Kevin-Pottier/SOCN/VHDL/PkgS51ItCtrl/CompPkgS51ItCtrl.vhdl

-- Library Declaration

Library IEEE;
  Use IEEE.std_logic_1164.all;
-- synopsys translate_off
  Use IEEE.vital_primitives.all;
  Use IEEE.vital_timing.all;

-- synopsys translate_on

-- Components Declaration

package PkgCompPkgS51ItCtrl is

End PkgCompPkgS51ItCtrl ;
