Kevin-Pottier/SOCN/TECH/AMS/vital/c35/c35_CORELIB_3B_Vcomponents.vhd

----------------------------------------------------------------
-- 
-- DATE CREATED :    Tue Aug  6 2006
-- 
-- LIBRARY      :    c35_CORELIB_3B
-- REVISION     :    2.1 bka
-- TECHNOLOGY   :    cmos
-- TIME SCALE   :    1 ps
-- LOGIC SYSTEM :    IEEE-1164
-- NOTES        :    
--                   Owner: austriamicrosystems AG  HIT-Kit: Digital
-- HISTORY      :
-- 
----------------------------------------------------------------

library IEEE;
use IEEE.STD_LOGIC_1164.all;
-- synopsys translate_off

library IEEE;
use IEEE.VITAL_Timing.all;
-- synopsys translate_on

package VCOMPONENTS is

constant DefaultTimingChecksOn : Boolean := True;
constant DefaultXon : Boolean := True;
constant DefaultMsgOn : Boolean := True;

----- Component ADD21 -----
component ADD21_3B
-- synopsys translate_off
   generic(
      TimingChecksOn: Boolean := DefaultTimingChecksOn;
      InstancePath: STRING := "*";
      Xon: Boolean := DefaultXon;
      MsgOn: Boolean := DefaultMsgOn;
      tpd_A_CO                       :	VitalDelayType01 := (1 ps, 1 ps);
      tpd_B_CO                       :	VitalDelayType01 := (1 ps, 1 ps);
      tpd_A_S                        :	VitalDelayType01 := (1 ps, 1 ps);
      tpd_B_S                        :	VitalDelayType01 := (1 ps, 1 ps);
      tipd_A                         :	VitalDelayType01 := (0 ps, 0 ps);
      tipd_B                         :	VitalDelayType01 := (0 ps, 0 ps));

-- synopsys translate_on
   port(
      A                              :	in    STD_ULOGIC;
      B                              :	in    STD_ULOGIC;
      CO                             :	out   STD_ULOGIC;
      S                              :	out   STD_ULOGIC);
end component;


----- Component ADD22 -----
component ADD22_3B
-- synopsys translate_off
   generic(
      TimingChecksOn: Boolean := DefaultTimingChecksOn;
      InstancePath: STRING := "*";
      Xon: Boolean := DefaultXon;
      MsgOn: Boolean := DefaultMsgOn;
      tpd_A_CO                       :	VitalDelayType01 := (1 ps, 1 ps);
      tpd_B_CO                       :	VitalDelayType01 := (1 ps, 1 ps);
      tpd_A_S                        :	VitalDelayType01 := (1 ps, 1 ps);
      tpd_B_S                        :	VitalDelayType01 := (1 ps, 1 ps);
      tipd_A                         :	VitalDelayType01 := (0 ps, 0 ps);
      tipd_B                         :	VitalDelayType01 := (0 ps, 0 ps));

-- synopsys translate_on
   port(
      A                              :	in    STD_ULOGIC;
      B                              :	in    STD_ULOGIC;
      CO                             :	out   STD_ULOGIC;
      S                              :	out   STD_ULOGIC);
end component;


----- Component ADD31 -----
component ADD31_3B
-- synopsys translate_off
   generic(
      TimingChecksOn: Boolean := DefaultTimingChecksOn;
      InstancePath: STRING := "*";
      Xon: Boolean := DefaultXon;
      MsgOn: Boolean := DefaultMsgOn;
      tpd_A_CO                       :	VitalDelayType01 := (1 ps, 1 ps);
      tpd_B_CO                       :	VitalDelayType01 := (1 ps, 1 ps);
      tpd_CI_CO                      :	VitalDelayType01 := (1 ps, 1 ps);
      tpd_A_S                        :	VitalDelayType01 := (1 ps, 1 ps);
      tpd_B_S                        :	VitalDelayType01 := (1 ps, 1 ps);
      tpd_CI_S                       :	VitalDelayType01 := (1 ps, 1 ps);
      tipd_A                         :	VitalDelayType01 := (0 ps, 0 ps);
      tipd_B                         :	VitalDelayType01 := (0 ps, 0 ps);
      tipd_CI                        :	VitalDelayType01 := (0 ps, 0 ps));

-- synopsys translate_on
   port(
      A                              :	in    STD_ULOGIC;
      B                              :	in    STD_ULOGIC;
      CI                             :	in    STD_ULOGIC;
      CO                             :	out   STD_ULOGIC;
      S                              :	out   STD_ULOGIC);
end component;


----- Component ADD32 -----
component ADD32_3B
-- synopsys translate_off
   generic(
      TimingChecksOn: Boolean := DefaultTimingChecksOn;
      InstancePath: STRING := "*";
      Xon: Boolean := DefaultXon;
      MsgOn: Boolean := DefaultMsgOn;
      tpd_A_CO                       :	VitalDelayType01 := (1 ps, 1 ps);
      tpd_B_CO                       :	VitalDelayType01 := (1 ps, 1 ps);
      tpd_CI_CO                      :	VitalDelayType01 := (1 ps, 1 ps);
      tpd_A_S                        :	VitalDelayType01 := (1 ps, 1 ps);
      tpd_B_S                        :	VitalDelayType01 := (1 ps, 1 ps);
      tpd_CI_S                       :	VitalDelayType01 := (1 ps, 1 ps);
      tipd_A                         :	VitalDelayType01 := (0 ps, 0 ps);
      tipd_B                         :	VitalDelayType01 := (0 ps, 0 ps);
      tipd_CI                        :	VitalDelayType01 := (0 ps, 0 ps));

-- synopsys translate_on
   port(
      A                              :	in    STD_ULOGIC;
      B                              :	in    STD_ULOGIC;
      CI                             :	in    STD_ULOGIC;
      CO                             :	out   STD_ULOGIC;
      S                              :	out   STD_ULOGIC);
end component;


----- Component AOI210 -----
component AOI210_3B
-- synopsys translate_off
   generic(
      TimingChecksOn: Boolean := DefaultTimingChecksOn;
      InstancePath: STRING := "*";
      Xon: Boolean := DefaultXon;
      MsgOn: Boolean := DefaultMsgOn;
      tpd_A_Q                        :	VitalDelayType01 := (1 ps, 1 ps);
      tpd_B_Q                        :	VitalDelayType01 := (1 ps, 1 ps);
      tpd_C_Q                        :	VitalDelayType01 := (1 ps, 1 ps);
      tipd_A                         :	VitalDelayType01 := (0 ps, 0 ps);
      tipd_B                         :	VitalDelayType01 := (0 ps, 0 ps);
      tipd_C                         :	VitalDelayType01 := (0 ps, 0 ps));

-- synopsys translate_on
   port(
      A                              :	in    STD_ULOGIC;
      B                              :	in    STD_ULOGIC;
      C                              :	in    STD_ULOGIC;
      Q                              :	out   STD_ULOGIC);
end component;


----- Component AOI211 -----
component AOI211_3B
-- synopsys translate_off
   generic(
      TimingChecksOn: Boolean := DefaultTimingChecksOn;
      InstancePath: STRING := "*";
      Xon: Boolean := DefaultXon;
      MsgOn: Boolean := DefaultMsgOn;
      tpd_A_Q                        :	VitalDelayType01 := (1 ps, 1 ps);
      tpd_B_Q                        :	VitalDelayType01 := (1 ps, 1 ps);
      tpd_C_Q                        :	VitalDelayType01 := (1 ps, 1 ps);
      tipd_A                         :	VitalDelayType01 := (0 ps, 0 ps);
      tipd_B                         :	VitalDelayType01 := (0 ps, 0 ps);
      tipd_C                         :	VitalDelayType01 := (0 ps, 0 ps));

-- synopsys translate_on
   port(
      A                              :	in    STD_ULOGIC;
      B                              :	in    STD_ULOGIC;
      C                              :	in    STD_ULOGIC;
      Q                              :	out   STD_ULOGIC);
end component;


----- Component AOI212 -----
component AOI212_3B
-- synopsys translate_off
   generic(
      TimingChecksOn: Boolean := DefaultTimingChecksOn;
      InstancePath: STRING := "*";
      Xon: Boolean := DefaultXon;
      MsgOn: Boolean := DefaultMsgOn;
      tpd_A_Q                        :	VitalDelayType01 := (1 ps, 1 ps);
      tpd_B_Q                        :	VitalDelayType01 := (1 ps, 1 ps);
      tpd_C_Q                        :	VitalDelayType01 := (1 ps, 1 ps);
      tipd_A                         :	VitalDelayType01 := (0 ps, 0 ps);
      tipd_B                         :	VitalDelayType01 := (0 ps, 0 ps);
      tipd_C                         :	VitalDelayType01 := (0 ps, 0 ps));

-- synopsys translate_on
   port(
      A                              :	in    STD_ULOGIC;
      B                              :	in    STD_ULOGIC;
      C                              :	in    STD_ULOGIC;
      Q                              :	out   STD_ULOGIC);
end component;


----- Component AOI220 -----
component AOI220_3B
-- synopsys translate_off
   generic(
      TimingChecksOn: Boolean := DefaultTimingChecksOn;
      InstancePath: STRING := "*";
      Xon: Boolean := DefaultXon;
      MsgOn: Boolean := DefaultMsgOn;
      tpd_A_Q                        :	VitalDelayType01 := (1 ps, 1 ps);
      tpd_B_Q                        :	VitalDelayType01 := (1 ps, 1 ps);
      tpd_C_Q                        :	VitalDelayType01 := (1 ps, 1 ps);
      tpd_D_Q                        :	VitalDelayType01 := (1 ps, 1 ps);
      tipd_A                         :	VitalDelayType01 := (0 ps, 0 ps);
      tipd_B                         :	VitalDelayType01 := (0 ps, 0 ps);
      tipd_C                         :	VitalDelayType01 := (0 ps, 0 ps);
      tipd_D                         :	VitalDelayType01 := (0 ps, 0 ps));

-- synopsys translate_on
   port(
      A                              :	in    STD_ULOGIC;
      B                              :	in    STD_ULOGIC;
      C                              :	in    STD_ULOGIC;
      D                              :	in    STD_ULOGIC;
      Q                              :	out   STD_ULOGIC);
end component;


----- Component AOI221 -----
component AOI221_3B
-- synopsys translate_off
   generic(
      TimingChecksOn: Boolean := DefaultTimingChecksOn;
      InstancePath: STRING := "*";
      Xon: Boolean := DefaultXon;
      MsgOn: Boolean := DefaultMsgOn;
      tpd_A_Q                        :	VitalDelayType01 := (1 ps, 1 ps);
      tpd_B_Q                        :	VitalDelayType01 := (1 ps, 1 ps);
      tpd_C_Q                        :	VitalDelayType01 := (1 ps, 1 ps);
      tpd_D_Q                        :	VitalDelayType01 := (1 ps, 1 ps);
      tipd_A                         :	VitalDelayType01 := (0 ps, 0 ps);
      tipd_B                         :	VitalDelayType01 := (0 ps, 0 ps);
      tipd_C                         :	VitalDelayType01 := (0 ps, 0 ps);
      tipd_D                         :	VitalDelayType01 := (0 ps, 0 ps));

-- synopsys translate_on
   port(
      A                              :	in    STD_ULOGIC;
      B                              :	in    STD_ULOGIC;
      C                              :	in    STD_ULOGIC;
      D                              :	in    STD_ULOGIC;
      Q                              :	out   STD_ULOGIC);
end component;


----- Component AOI222 -----
component AOI222_3B
-- synopsys translate_off
   generic(
      TimingChecksOn: Boolean := DefaultTimingChecksOn;
      InstancePath: STRING := "*";
      Xon: Boolean := DefaultXon;
      MsgOn: Boolean := DefaultMsgOn;
      tpd_A_Q                        :	VitalDelayType01 := (1 ps, 1 ps);
      tpd_B_Q                        :	VitalDelayType01 := (1 ps, 1 ps);
      tpd_C_Q                        :	VitalDelayType01 := (1 ps, 1 ps);
      tpd_D_Q                        :	VitalDelayType01 := (1 ps, 1 ps);
      tipd_A                         :	VitalDelayType01 := (0 ps, 0 ps);
      tipd_B                         :	VitalDelayType01 := (0 ps, 0 ps);
      tipd_C                         :	VitalDelayType01 := (0 ps, 0 ps);
      tipd_D                         :	VitalDelayType01 := (0 ps, 0 ps));

-- synopsys translate_on
   port(
      A                              :	in    STD_ULOGIC;
      B                              :	in    STD_ULOGIC;
      C                              :	in    STD_ULOGIC;
      D                              :	in    STD_ULOGIC;
      Q                              :	out   STD_ULOGIC);
end component;


----- Component AOI310 -----
component AOI310_3B
-- synopsys translate_off
   generic(
      TimingChecksOn: Boolean := DefaultTimingChecksOn;
      InstancePath: STRING := "*";
      Xon: Boolean := DefaultXon;
      MsgOn: Boolean := DefaultMsgOn;
      tpd_A_Q                        :	VitalDelayType01 := (1 ps, 1 ps);
      tpd_B_Q                        :	VitalDelayType01 := (1 ps, 1 ps);
      tpd_C_Q                        :	VitalDelayType01 := (1 ps, 1 ps);
      tpd_D_Q                        :	VitalDelayType01 := (1 ps, 1 ps);
      tipd_A                         :	VitalDelayType01 := (0 ps, 0 ps);
      tipd_B                         :	VitalDelayType01 := (0 ps, 0 ps);
      tipd_C                         :	VitalDelayType01 := (0 ps, 0 ps);
      tipd_D                         :	VitalDelayType01 := (0 ps, 0 ps));

-- synopsys translate_on
   port(
      A                              :	in    STD_ULOGIC;
      B                              :	in    STD_ULOGIC;
      C                              :	in    STD_ULOGIC;
      D                              :	in    STD_ULOGIC;
      Q                              :	out   STD_ULOGIC);
end component;


----- Component AOI311 -----
component AOI311_3B
-- synopsys translate_off
   generic(
      TimingChecksOn: Boolean := DefaultTimingChecksOn;
      InstancePath: STRING := "*";
      Xon: Boolean := DefaultXon;
      MsgOn: Boolean := DefaultMsgOn;
      tpd_A_Q                        :	VitalDelayType01 := (1 ps, 1 ps);
      tpd_B_Q                        :	VitalDelayType01 := (1 ps, 1 ps);
      tpd_C_Q                        :	VitalDelayType01 := (1 ps, 1 ps);
      tpd_D_Q                        :	VitalDelayType01 := (1 ps, 1 ps);
      tipd_A                         :	VitalDelayType01 := (0 ps, 0 ps);
      tipd_B                         :	VitalDelayType01 := (0 ps, 0 ps);
      tipd_C                         :	VitalDelayType01 := (0 ps, 0 ps);
      tipd_D                         :	VitalDelayType01 := (0 ps, 0 ps));

-- synopsys translate_on
   port(
      A                              :	in    STD_ULOGIC;
      B                              :	in    STD_ULOGIC;
      C                              :	in    STD_ULOGIC;
      D                              :	in    STD_ULOGIC;
      Q                              :	out   STD_ULOGIC);
end component;


----- Component AOI312 -----
component AOI312_3B
-- synopsys translate_off
   generic(
      TimingChecksOn: Boolean := DefaultTimingChecksOn;
      InstancePath: STRING := "*";
      Xon: Boolean := DefaultXon;
      MsgOn: Boolean := DefaultMsgOn;
      tpd_A_Q                        :	VitalDelayType01 := (1 ps, 1 ps);
      tpd_B_Q                        :	VitalDelayType01 := (1 ps, 1 ps);
      tpd_C_Q                        :	VitalDelayType01 := (1 ps, 1 ps);
      tpd_D_Q                        :	VitalDelayType01 := (1 ps, 1 ps);
      tipd_A                         :	VitalDelayType01 := (0 ps, 0 ps);
      tipd_B                         :	VitalDelayType01 := (0 ps, 0 ps);
      tipd_C                         :	VitalDelayType01 := (0 ps, 0 ps);
      tipd_D                         :	VitalDelayType01 := (0 ps, 0 ps));

-- synopsys translate_on
   port(
      A                              :	in    STD_ULOGIC;
      B                              :	in    STD_ULOGIC;
      C                              :	in    STD_ULOGIC;
      D                              :	in    STD_ULOGIC;
      Q                              :	out   STD_ULOGIC);
end component;


----- Component AOI2110 -----
component AOI2110_3B
-- synopsys translate_off
   generic(
      TimingChecksOn: Boolean := DefaultTimingChecksOn;
      InstancePath: STRING := "*";
      Xon: Boolean := DefaultXon;
      MsgOn: Boolean := DefaultMsgOn;
      tpd_A_Q                        :	VitalDelayType01 := (1 ps, 1 ps);
      tpd_B_Q                        :	VitalDelayType01 := (1 ps, 1 ps);
      tpd_C_Q                        :	VitalDelayType01 := (1 ps, 1 ps);
      tpd_D_Q                        :	VitalDelayType01 := (1 ps, 1 ps);
      tipd_A                         :	VitalDelayType01 := (0 ps, 0 ps);
      tipd_B                         :	VitalDelayType01 := (0 ps, 0 ps);
      tipd_C                         :	VitalDelayType01 := (0 ps, 0 ps);
      tipd_D                         :	VitalDelayType01 := (0 ps, 0 ps));

-- synopsys translate_on
   port(
      A                              :	in    STD_ULOGIC;
      B                              :	in    STD_ULOGIC;
      C                              :	in    STD_ULOGIC;
      D                              :	in    STD_ULOGIC;
      Q                              :	out   STD_ULOGIC);
end component;


----- Component AOI2111 -----
component AOI2111_3B
-- synopsys translate_off
   generic(
      TimingChecksOn: Boolean := DefaultTimingChecksOn;
      InstancePath: STRING := "*";
      Xon: Boolean := DefaultXon;
      MsgOn: Boolean := DefaultMsgOn;
      tpd_A_Q                        :	VitalDelayType01 := (1 ps, 1 ps);
      tpd_B_Q                        :	VitalDelayType01 := (1 ps, 1 ps);
      tpd_C_Q                        :	VitalDelayType01 := (1 ps, 1 ps);
      tpd_D_Q                        :	VitalDelayType01 := (1 ps, 1 ps);
      tipd_A                         :	VitalDelayType01 := (0 ps, 0 ps);
      tipd_B                         :	VitalDelayType01 := (0 ps, 0 ps);
      tipd_C                         :	VitalDelayType01 := (0 ps, 0 ps);
      tipd_D                         :	VitalDelayType01 := (0 ps, 0 ps));

-- synopsys translate_on
   port(
      A                              :	in    STD_ULOGIC;
      B                              :	in    STD_ULOGIC;
      C                              :	in    STD_ULOGIC;
      D                              :	in    STD_ULOGIC;
      Q                              :	out   STD_ULOGIC);
end component;


----- Component AOI2112 -----
component AOI2112_3B
-- synopsys translate_off
   generic(
      TimingChecksOn: Boolean := DefaultTimingChecksOn;
      InstancePath: STRING := "*";
      Xon: Boolean := DefaultXon;
      MsgOn: Boolean := DefaultMsgOn;
      tpd_A_Q                        :	VitalDelayType01 := (1 ps, 1 ps);
      tpd_B_Q                        :	VitalDelayType01 := (1 ps, 1 ps);
      tpd_C_Q                        :	VitalDelayType01 := (1 ps, 1 ps);
      tpd_D_Q                        :	VitalDelayType01 := (1 ps, 1 ps);
      tipd_A                         :	VitalDelayType01 := (0 ps, 0 ps);
      tipd_B                         :	VitalDelayType01 := (0 ps, 0 ps);
      tipd_C                         :	VitalDelayType01 := (0 ps, 0 ps);
      tipd_D                         :	VitalDelayType01 := (0 ps, 0 ps));

-- synopsys translate_on
   port(
      A                              :	in    STD_ULOGIC;
      B                              :	in    STD_ULOGIC;
      C                              :	in    STD_ULOGIC;
      D                              :	in    STD_ULOGIC;
      Q                              :	out   STD_ULOGIC);
end component;


----- Component BUF2 -----
component BUF2_3B
-- synopsys translate_off
   generic(
      TimingChecksOn: Boolean := DefaultTimingChecksOn;
      InstancePath: STRING := "*";
      Xon: Boolean := DefaultXon;
      MsgOn: Boolean := DefaultMsgOn;
      tpd_A_Q                        :	VitalDelayType01 := (1 ps, 1 ps);
      tipd_A                         :	VitalDelayType01 := (0 ps, 0 ps));

-- synopsys translate_on
   port(
      A                              :	in    STD_ULOGIC;
      Q                              :	out   STD_ULOGIC);
end component;


----- Component BUF4 -----
component BUF4_3B
-- synopsys translate_off
   generic(
      TimingChecksOn: Boolean := DefaultTimingChecksOn;
      InstancePath: STRING := "*";
      Xon: Boolean := DefaultXon;
      MsgOn: Boolean := DefaultMsgOn;
      tpd_A_Q                        :	VitalDelayType01 := (1 ps, 1 ps);
      tipd_A                         :	VitalDelayType01 := (0 ps, 0 ps));

-- synopsys translate_on
   port(
      A                              :	in    STD_ULOGIC;
      Q                              :	out   STD_ULOGIC);
end component;


----- Component BUF6 -----
component BUF6_3B
-- synopsys translate_off
   generic(
      TimingChecksOn: Boolean := DefaultTimingChecksOn;
      InstancePath: STRING := "*";
      Xon: Boolean := DefaultXon;
      MsgOn: Boolean := DefaultMsgOn;
      tpd_A_Q                        :	VitalDelayType01 := (1 ps, 1 ps);
      tipd_A                         :	VitalDelayType01 := (0 ps, 0 ps));

-- synopsys translate_on
   port(
      A                              :	in    STD_ULOGIC;
      Q                              :	out   STD_ULOGIC);
end component;


----- Component BUF8 -----
component BUF8_3B
-- synopsys translate_off
   generic(
      TimingChecksOn: Boolean := DefaultTimingChecksOn;
      InstancePath: STRING := "*";
      Xon: Boolean := DefaultXon;
      MsgOn: Boolean := DefaultMsgOn;
      tpd_A_Q                        :	VitalDelayType01 := (1 ps, 1 ps);
      tipd_A                         :	VitalDelayType01 := (0 ps, 0 ps));

-- synopsys translate_on
   port(
      A                              :	in    STD_ULOGIC;
      Q                              :	out   STD_ULOGIC);
end component;


----- Component BUF12 -----
component BUF12_3B
-- synopsys translate_off
   generic(
      TimingChecksOn: Boolean := DefaultTimingChecksOn;
      InstancePath: STRING := "*";
      Xon: Boolean := DefaultXon;
      MsgOn: Boolean := DefaultMsgOn;
      tpd_A_Q                        :	VitalDelayType01 := (1 ps, 1 ps);
      tipd_A                         :	VitalDelayType01 := (0 ps, 0 ps));

-- synopsys translate_on
   port(
      A                              :	in    STD_ULOGIC;
      Q                              :	out   STD_ULOGIC);
end component;


----- Component BUF15 -----
component BUF15_3B
-- synopsys translate_off
   generic(
      TimingChecksOn: Boolean := DefaultTimingChecksOn;
      InstancePath: STRING := "*";
      Xon: Boolean := DefaultXon;
      MsgOn: Boolean := DefaultMsgOn;
      tpd_A_Q                        :	VitalDelayType01 := (1 ps, 1 ps);
      tipd_A                         :	VitalDelayType01 := (0 ps, 0 ps));

-- synopsys translate_on
   port(
      A                              :	in    STD_ULOGIC;
      Q                              :	out   STD_ULOGIC);
end component;


----- Component BUFE2 -----
component BUFE2_3B
-- synopsys translate_off
   generic(
      TimingChecksOn: Boolean := DefaultTimingChecksOn;
      InstancePath: STRING := "*";
      Xon: Boolean := DefaultXon;
      MsgOn: Boolean := DefaultMsgOn;
      tpd_A_Q                        :	VitalDelayType01 := (1 ps, 1 ps);
      tpd_E_Q                        :	VitalDelayType01z := 
               (1 ps, 1 ps, 1 ps, 1 ps, 1 ps, 1 ps);
      tipd_A                         :	VitalDelayType01 := (0 ps, 0 ps);
      tipd_E                         :	VitalDelayType01 := (0 ps, 0 ps));

-- synopsys translate_on
   port(
      A                              :	in    STD_ULOGIC;
      E                              :	in    STD_ULOGIC;
      Q                              :	out   STD_ULOGIC);
end component;


----- Component BUFE4 -----
component BUFE4_3B
-- synopsys translate_off
   generic(
      TimingChecksOn: Boolean := DefaultTimingChecksOn;
      InstancePath: STRING := "*";
      Xon: Boolean := DefaultXon;
      MsgOn: Boolean := DefaultMsgOn;
      tpd_A_Q                        :	VitalDelayType01 := (1 ps, 1 ps);
      tpd_E_Q                        :	VitalDelayType01z := 
               (1 ps, 1 ps, 1 ps, 1 ps, 1 ps, 1 ps);
      tipd_A                         :	VitalDelayType01 := (0 ps, 0 ps);
      tipd_E                         :	VitalDelayType01 := (0 ps, 0 ps));

-- synopsys translate_on
   port(
      A                              :	in    STD_ULOGIC;
      E                              :	in    STD_ULOGIC;
      Q                              :	out   STD_ULOGIC);
end component;


----- Component BUFE6 -----
component BUFE6_3B
-- synopsys translate_off
   generic(
      TimingChecksOn: Boolean := DefaultTimingChecksOn;
      InstancePath: STRING := "*";
      Xon: Boolean := DefaultXon;
      MsgOn: Boolean := DefaultMsgOn;
      tpd_A_Q                        :	VitalDelayType01 := (1 ps, 1 ps);
      tpd_E_Q                        :	VitalDelayType01z := 
               (1 ps, 1 ps, 1 ps, 1 ps, 1 ps, 1 ps);
      tipd_A                         :	VitalDelayType01 := (0 ps, 0 ps);
      tipd_E                         :	VitalDelayType01 := (0 ps, 0 ps));

-- synopsys translate_on
   port(
      A                              :	in    STD_ULOGIC;
      E                              :	in    STD_ULOGIC;
      Q                              :	out   STD_ULOGIC);
end component;


----- Component BUFE8 -----
component BUFE8_3B
-- synopsys translate_off
   generic(
      TimingChecksOn: Boolean := DefaultTimingChecksOn;
      InstancePath: STRING := "*";
      Xon: Boolean := DefaultXon;
      MsgOn: Boolean := DefaultMsgOn;
      tpd_A_Q                        :	VitalDelayType01 := (1 ps, 1 ps);
      tpd_E_Q                        :	VitalDelayType01z := 
               (1 ps, 1 ps, 1 ps, 1 ps, 1 ps, 1 ps);
      tipd_A                         :	VitalDelayType01 := (0 ps, 0 ps);
      tipd_E                         :	VitalDelayType01 := (0 ps, 0 ps));

-- synopsys translate_on
   port(
      A                              :	in    STD_ULOGIC;
      E                              :	in    STD_ULOGIC;
      Q                              :	out   STD_ULOGIC);
end component;


----- Component BUFE12 -----
component BUFE12_3B
-- synopsys translate_off
   generic(
      TimingChecksOn: Boolean := DefaultTimingChecksOn;
      InstancePath: STRING := "*";
      Xon: Boolean := DefaultXon;
      MsgOn: Boolean := DefaultMsgOn;
      tpd_A_Q                        :	VitalDelayType01 := (1 ps, 1 ps);
      tpd_E_Q                        :	VitalDelayType01z := 
               (1 ps, 1 ps, 1 ps, 1 ps, 1 ps, 1 ps);
      tipd_A                         :	VitalDelayType01 := (0 ps, 0 ps);
      tipd_E                         :	VitalDelayType01 := (0 ps, 0 ps));

-- synopsys translate_on
   port(
      A                              :	in    STD_ULOGIC;
      E                              :	in    STD_ULOGIC;
      Q                              :	out   STD_ULOGIC);
end component;


----- Component BUFE15 -----
component BUFE15_3B
-- synopsys translate_off
   generic(
      TimingChecksOn: Boolean := DefaultTimingChecksOn;
      InstancePath: STRING := "*";
      Xon: Boolean := DefaultXon;
      MsgOn: Boolean := DefaultMsgOn;
      tpd_A_Q                        :	VitalDelayType01 := (1 ps, 1 ps);
      tpd_E_Q                        :	VitalDelayType01z := 
               (1 ps, 1 ps, 1 ps, 1 ps, 1 ps, 1 ps);
      tipd_A                         :	VitalDelayType01 := (0 ps, 0 ps);
      tipd_E                         :	VitalDelayType01 := (0 ps, 0 ps));

-- synopsys translate_on
   port(
      A                              :	in    STD_ULOGIC;
      E                              :	in    STD_ULOGIC;
      Q                              :	out   STD_ULOGIC);
end component;


----- Component BUSHD -----
component BUSHD_3B
-- synopsys translate_off
   generic(
      TimingChecksOn: Boolean := DefaultTimingChecksOn;
      InstancePath: STRING := "*";
      Xon: Boolean := DefaultXon;
      MsgOn: Boolean := DefaultMsgOn;
      tipd_A                         :	VitalDelayType01 := (0 ps, 0 ps));

-- synopsys translate_on
   port(
      A                              :	inout STD_ULOGIC := 'Z');
end component;


----- Component BUFT2 -----
component BUFT2_3B
-- synopsys translate_off
   generic(
      TimingChecksOn: Boolean := DefaultTimingChecksOn;
      InstancePath: STRING := "*";
      Xon: Boolean := DefaultXon;
      MsgOn: Boolean := DefaultMsgOn;
      tpd_A_Q                        :	VitalDelayType01 := (1 ps, 1 ps);
      tpd_EN_Q                       :	VitalDelayType01z := 
               (1 ps, 1 ps, 1 ps, 1 ps, 1 ps, 1 ps);
      tipd_A                         :	VitalDelayType01 := (0 ps, 0 ps);
      tipd_EN                        :	VitalDelayType01 := (0 ps, 0 ps));

-- synopsys translate_on
   port(
      A                              :	in    STD_ULOGIC;
      EN                             :	in    STD_ULOGIC;
      Q                              :	out   STD_ULOGIC);
end component;


----- Component BUFT4 -----
component BUFT4_3B
-- synopsys translate_off
   generic(
      TimingChecksOn: Boolean := DefaultTimingChecksOn;
      InstancePath: STRING := "*";
      Xon: Boolean := DefaultXon;
      MsgOn: Boolean := DefaultMsgOn;
      tpd_A_Q                        :	VitalDelayType01 := (1 ps, 1 ps);
      tpd_EN_Q                       :	VitalDelayType01z := 
               (1 ps, 1 ps, 1 ps, 1 ps, 1 ps, 1 ps);
      tipd_A                         :	VitalDelayType01 := (0 ps, 0 ps);
      tipd_EN                        :	VitalDelayType01 := (0 ps, 0 ps));

-- synopsys translate_on
   port(
      A                              :	in    STD_ULOGIC;
      EN                             :	in    STD_ULOGIC;
      Q                              :	out   STD_ULOGIC);
end component;


----- Component BUFT6 -----
component BUFT6_3B
-- synopsys translate_off
   generic(
      TimingChecksOn: Boolean := DefaultTimingChecksOn;
      InstancePath: STRING := "*";
      Xon: Boolean := DefaultXon;
      MsgOn: Boolean := DefaultMsgOn;
      tpd_A_Q                        :	VitalDelayType01 := (1 ps, 1 ps);
      tpd_EN_Q                       :	VitalDelayType01z := 
               (1 ps, 1 ps, 1 ps, 1 ps, 1 ps, 1 ps);
      tipd_A                         :	VitalDelayType01 := (0 ps, 0 ps);
      tipd_EN                        :	VitalDelayType01 := (0 ps, 0 ps));

-- synopsys translate_on
   port(
      A                              :	in    STD_ULOGIC;
      EN                             :	in    STD_ULOGIC;
      Q                              :	out   STD_ULOGIC);
end component;


----- Component BUFT8 -----
component BUFT8_3B
-- synopsys translate_off
   generic(
      TimingChecksOn: Boolean := DefaultTimingChecksOn;
      InstancePath: STRING := "*";
      Xon: Boolean := DefaultXon;
      MsgOn: Boolean := DefaultMsgOn;
      tpd_A_Q                        :	VitalDelayType01 := (1 ps, 1 ps);
      tpd_EN_Q                       :	VitalDelayType01z := 
               (1 ps, 1 ps, 1 ps, 1 ps, 1 ps, 1 ps);
      tipd_A                         :	VitalDelayType01 := (0 ps, 0 ps);
      tipd_EN                        :	VitalDelayType01 := (0 ps, 0 ps));

-- synopsys translate_on
   port(
      A                              :	in    STD_ULOGIC;
      EN                             :	in    STD_ULOGIC;
      Q                              :	out   STD_ULOGIC);
end component;


----- Component BUFT12 -----
component BUFT12_3B
-- synopsys translate_off
   generic(
      TimingChecksOn: Boolean := DefaultTimingChecksOn;
      InstancePath: STRING := "*";
      Xon: Boolean := DefaultXon;
      MsgOn: Boolean := DefaultMsgOn;
      tpd_A_Q                        :	VitalDelayType01 := (1 ps, 1 ps);
      tpd_EN_Q                       :	VitalDelayType01z := 
               (1 ps, 1 ps, 1 ps, 1 ps, 1 ps, 1 ps);
      tipd_A                         :	VitalDelayType01 := (0 ps, 0 ps);
      tipd_EN                        :	VitalDelayType01 := (0 ps, 0 ps));

-- synopsys translate_on
   port(
      A                              :	in    STD_ULOGIC;
      EN                             :	in    STD_ULOGIC;
      Q                              :	out   STD_ULOGIC);
end component;


----- Component BUFT15 -----
component BUFT15_3B
-- synopsys translate_off
   generic(
      TimingChecksOn: Boolean := DefaultTimingChecksOn;
      InstancePath: STRING := "*";
      Xon: Boolean := DefaultXon;
      MsgOn: Boolean := DefaultMsgOn;
      tpd_A_Q                        :	VitalDelayType01 := (1 ps, 1 ps);
      tpd_EN_Q                       :	VitalDelayType01z := 
               (1 ps, 1 ps, 1 ps, 1 ps, 1 ps, 1 ps);
      tipd_A                         :	VitalDelayType01 := (0 ps, 0 ps);
      tipd_EN                        :	VitalDelayType01 := (0 ps, 0 ps));

-- synopsys translate_on
   port(
      A                              :	in    STD_ULOGIC;
      EN                             :	in    STD_ULOGIC;
      Q                              :	out   STD_ULOGIC);
end component;


----- Component CLKBUF2 -----
component CLKBUF2_3B
-- synopsys translate_off
   generic(
      TimingChecksOn: Boolean := DefaultTimingChecksOn;
      InstancePath: STRING := "*";
      Xon: Boolean := DefaultXon;
      MsgOn: Boolean := DefaultMsgOn;
      tpd_A_Q                        :	VitalDelayType01 := (1 ps, 1 ps);
      tipd_A                         :	VitalDelayType01 := (0 ps, 0 ps));

-- synopsys translate_on
   port(
      A                              :	in    STD_ULOGIC;
      Q                              :	out   STD_ULOGIC);
end component;


----- Component CLKBUF4 -----
component CLKBUF4_3B
-- synopsys translate_off
   generic(
      TimingChecksOn: Boolean := DefaultTimingChecksOn;
      InstancePath: STRING := "*";
      Xon: Boolean := DefaultXon;
      MsgOn: Boolean := DefaultMsgOn;
      tpd_A_Q                        :	VitalDelayType01 := (1 ps, 1 ps);
      tipd_A                         :	VitalDelayType01 := (0 ps, 0 ps));

-- synopsys translate_on
   port(
      A                              :	in    STD_ULOGIC;
      Q                              :	out   STD_ULOGIC);
end component;


----- Component CLKBUF6 -----
component CLKBUF6_3B
-- synopsys translate_off
   generic(
      TimingChecksOn: Boolean := DefaultTimingChecksOn;
      InstancePath: STRING := "*";
      Xon: Boolean := DefaultXon;
      MsgOn: Boolean := DefaultMsgOn;
      tpd_A_Q                        :	VitalDelayType01 := (1 ps, 1 ps);
      tipd_A                         :	VitalDelayType01 := (0 ps, 0 ps));

-- synopsys translate_on
   port(
      A                              :	in    STD_ULOGIC;
      Q                              :	out   STD_ULOGIC);
end component;


----- Component CLKBUF8 -----
component CLKBUF8_3B
-- synopsys translate_off
   generic(
      TimingChecksOn: Boolean := DefaultTimingChecksOn;
      InstancePath: STRING := "*";
      Xon: Boolean := DefaultXon;
      MsgOn: Boolean := DefaultMsgOn;
      tpd_A_Q                        :	VitalDelayType01 := (1 ps, 1 ps);
      tipd_A                         :	VitalDelayType01 := (0 ps, 0 ps));

-- synopsys translate_on
   port(
      A                              :	in    STD_ULOGIC;
      Q                              :	out   STD_ULOGIC);
end component;


----- Component CLKBUF12 -----
component CLKBUF12_3B
-- synopsys translate_off
   generic(
      TimingChecksOn: Boolean := DefaultTimingChecksOn;
      InstancePath: STRING := "*";
      Xon: Boolean := DefaultXon;
      MsgOn: Boolean := DefaultMsgOn;
      tpd_A_Q                        :	VitalDelayType01 := (1 ps, 1 ps);
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
      tipd_A                         :	VitalDelayType01 := (0 ps, 0 ps));

-- synopsys translate_on
   port(
      A                              :	in    STD_ULOGIC;
      Q                              :	out   STD_ULOGIC);
end component;


----- Component DF1 -----
component DF1_3B
-- synopsys translate_off
   generic(
      TimingChecksOn: Boolean := DefaultTimingChecksOn;
      InstancePath: STRING := "*";
      Xon: Boolean := DefaultXon;
      MsgOn: Boolean := DefaultMsgOn;
      tpd_C_Q                        :	VitalDelayType01 := (1 ps, 1 ps);
      tpd_C_QN                       :	VitalDelayType01 := (1 ps, 1 ps);
      thold_D_C_posedge_posedge      :	VitalDelayType := 1 ps;
      thold_D_C_negedge_posedge      :	VitalDelayType := 1 ps;
      tsetup_D_C_posedge_posedge     :	VitalDelayType := -1 ps;
      tsetup_D_C_negedge_posedge     :	VitalDelayType := -1 ps;
      tpw_C_posedge                  :	VitalDelayType := 1 ps;
      tpw_C_negedge                  :	VitalDelayType := 1 ps;
      tipd_C                         :	VitalDelayType01 := (0 ps, 0 ps);
      tipd_D                         :	VitalDelayType01 := (0 ps, 0 ps));

-- synopsys translate_on
   port(
      C                              :	in    STD_ULOGIC;
      D                              :	in    STD_ULOGIC;
      Q                              :	out   STD_ULOGIC;
      QN                             :	out   STD_ULOGIC);
end component;


----- Component DF3 -----
component DF3_3B
-- synopsys translate_off
   generic(
      TimingChecksOn: Boolean := DefaultTimingChecksOn;
      InstancePath: STRING := "*";
      Xon: Boolean := DefaultXon;
      MsgOn: Boolean := DefaultMsgOn;
      tpd_C_Q                        :	VitalDelayType01 := (1 ps, 1 ps);
      tpd_C_QN                       :	VitalDelayType01 := (1 ps, 1 ps);
      thold_D_C_posedge_posedge      :	VitalDelayType := 1 ps;
      thold_D_C_negedge_posedge      :	VitalDelayType := 1 ps;
      tsetup_D_C_posedge_posedge     :	VitalDelayType := -1 ps;
      tsetup_D_C_negedge_posedge     :	VitalDelayType := -1 ps;
      tpw_C_posedge                  :	VitalDelayType := 1 ps;
      tpw_C_negedge                  :	VitalDelayType := 1 ps;
      tipd_C                         :	VitalDelayType01 := (0 ps, 0 ps);
      tipd_D                         :	VitalDelayType01 := (0 ps, 0 ps));

-- synopsys translate_on
   port(
      C                              :	in    STD_ULOGIC;
      D                              :	in    STD_ULOGIC;
      Q                              :	out   STD_ULOGIC;
      QN                             :	out   STD_ULOGIC);
end component;


----- Component DFC1 -----
component DFC1_3B
-- synopsys translate_off
   generic(
      TimingChecksOn: Boolean := DefaultTimingChecksOn;
      InstancePath: STRING := "*";
      Xon: Boolean := DefaultXon;
      MsgOn: Boolean := DefaultMsgOn;
      tpd_RN_Q                       :	VitalDelayType01 := (0 ps, 1 ps);
      tpd_C_Q                        :	VitalDelayType01 := (1 ps, 1 ps);
      tpd_RN_QN                      :	VitalDelayType01 := (1 ps, 0 ps);
      tpd_C_QN                       :	VitalDelayType01 := (1 ps, 1 ps);
      thold_D_C_posedge_posedge      :	VitalDelayType := 1 ps;
      thold_D_C_negedge_posedge      :	VitalDelayType := 1 ps;
      tsetup_D_C_posedge_posedge     :	VitalDelayType := -1 ps;
      tsetup_D_C_negedge_posedge     :	VitalDelayType := -1 ps;
      trecovery_RN_C_posedge_posedge :	VitalDelayType := 0 ps;
      thold_RN_C_posedge_posedge     :	VitalDelayType := 0 ps;
      tpw_C_posedge                  :	VitalDelayType := 1 ps;
      tpw_C_negedge                  :	VitalDelayType := 1 ps;
      tpw_RN_negedge                 :	VitalDelayType := 1 ps;
      tipd_C                         :	VitalDelayType01 := (0 ps, 0 ps);
      tipd_D                         :	VitalDelayType01 := (0 ps, 0 ps);
      tipd_RN                        :	VitalDelayType01 := (0 ps, 0 ps));

-- synopsys translate_on
   port(
      C                              :	in    STD_ULOGIC;
      D                              :	in    STD_ULOGIC;
      Q                              :	out   STD_ULOGIC;
      QN                             :	out   STD_ULOGIC;
      RN                             :	in    STD_ULOGIC);
end component;


----- Component DFC3 -----
component DFC3_3B
-- synopsys translate_off
   generic(
      TimingChecksOn: Boolean := DefaultTimingChecksOn;
      InstancePath: STRING := "*";
      Xon: Boolean := DefaultXon;
      MsgOn: Boolean := DefaultMsgOn;
      tpd_RN_Q                       :	VitalDelayType01 := (0 ps, 1 ps);
      tpd_C_Q                        :	VitalDelayType01 := (1 ps, 1 ps);
      tpd_RN_QN                      :	VitalDelayType01 := (1 ps, 0 ps);
      tpd_C_QN                       :	VitalDelayType01 := (1 ps, 1 ps);
      thold_D_C_posedge_posedge      :	VitalDelayType := 1 ps;
      thold_D_C_negedge_posedge      :	VitalDelayType := 1 ps;
      tsetup_D_C_posedge_posedge     :	VitalDelayType := -1 ps;
      tsetup_D_C_negedge_posedge     :	VitalDelayType := -1 ps;
      trecovery_RN_C_posedge_posedge :	VitalDelayType := 0 ps;
      thold_RN_C_posedge_posedge     :	VitalDelayType := 0 ps;
      tpw_C_posedge                  :	VitalDelayType := 1 ps;
      tpw_C_negedge                  :	VitalDelayType := 1 ps;
      tpw_RN_negedge                 :	VitalDelayType := 1 ps;
      tipd_C                         :	VitalDelayType01 := (0 ps, 0 ps);
      tipd_D                         :	VitalDelayType01 := (0 ps, 0 ps);
      tipd_RN                        :	VitalDelayType01 := (0 ps, 0 ps));

-- synopsys translate_on
   port(
      C                              :	in    STD_ULOGIC;
      D                              :	in    STD_ULOGIC;
      Q                              :	out   STD_ULOGIC;
      QN                             :	out   STD_ULOGIC;
      RN                             :	in    STD_ULOGIC);
end component;


----- Component DFCP1 -----
component DFCP1_3B
-- synopsys translate_off
   generic(
      TimingChecksOn: Boolean := DefaultTimingChecksOn;
      InstancePath: STRING := "*";
      Xon: Boolean := DefaultXon;
      MsgOn: Boolean := DefaultMsgOn;
      tpd_RN_Q                       :	VitalDelayType01 := (1 ps, 1 ps);
      tpd_SN_Q                       :	VitalDelayType01 := (1 ps, 0 ps);
      tpd_C_Q                        :	VitalDelayType01 := (1 ps, 1 ps);
      tpd_RN_QN                      :	VitalDelayType01 := (1 ps, 0 ps);
      tpd_SN_QN                      :	VitalDelayType01 := (1 ps, 1 ps);
      tpd_C_QN                       :	VitalDelayType01 := (1 ps, 1 ps);
      thold_D_C_posedge_posedge      :	VitalDelayType := 1 ps;
      thold_D_C_negedge_posedge      :	VitalDelayType := 1 ps;
      tsetup_D_C_posedge_posedge     :	VitalDelayType := -1 ps;
      tsetup_D_C_negedge_posedge     :	VitalDelayType := -1 ps;
      trecovery_RN_C_posedge_posedge :	VitalDelayType := 0 ps;
      trecovery_SN_C_posedge_posedge :	VitalDelayType := 0 ps;
      thold_SN_C_posedge_posedge     :	VitalDelayType := 0 ps;
      thold_RN_C_posedge_posedge     :	VitalDelayType := 0 ps;
      tpw_C_posedge                  :	VitalDelayType := 1 ps;
      tpw_C_negedge                  :	VitalDelayType := 1 ps;
      tpw_RN_negedge                 :	VitalDelayType := 1 ps;
      tpw_SN_negedge                 :	VitalDelayType := 1 ps;
      tipd_C                         :	VitalDelayType01 := (0 ps, 0 ps);
      tipd_D                         :	VitalDelayType01 := (0 ps, 0 ps);
      tipd_RN                        :	VitalDelayType01 := (0 ps, 0 ps);
      tipd_SN                        :	VitalDelayType01 := (0 ps, 0 ps));

-- synopsys translate_on
   port(
      C                              :	in    STD_ULOGIC;
      D                              :	in    STD_ULOGIC;
      Q                              :	out   STD_ULOGIC;
      QN                             :	out   STD_ULOGIC;
      RN                             :	in    STD_ULOGIC;
      SN                             :	in    STD_ULOGIC);
end component;


----- Component DFCP3 -----
component DFCP3_3B
-- synopsys translate_off
   generic(
      TimingChecksOn: Boolean := DefaultTimingChecksOn;
      InstancePath: STRING := "*";
      Xon: Boolean := DefaultXon;
      MsgOn: Boolean := DefaultMsgOn;
      tpd_RN_Q                       :	VitalDelayType01 := (1 ps, 1 ps);
      tpd_SN_Q                       :	VitalDelayType01 := (1 ps, 0 ps);
      tpd_C_Q                        :	VitalDelayType01 := (1 ps, 1 ps);
      tpd_RN_QN                      :	VitalDelayType01 := (1 ps, 0 ps);
      tpd_SN_QN                      :	VitalDelayType01 := (1 ps, 1 ps);
      tpd_C_QN                       :	VitalDelayType01 := (1 ps, 1 ps);
      thold_D_C_posedge_posedge      :	VitalDelayType := 1 ps;
      thold_D_C_negedge_posedge      :	VitalDelayType := 1 ps;
      tsetup_D_C_posedge_posedge     :	VitalDelayType := 1 ps;
      tsetup_D_C_negedge_posedge     :	VitalDelayType := -1 ps;
      trecovery_RN_C_posedge_posedge :	VitalDelayType := 0 ps;
      trecovery_SN_C_posedge_posedge :	VitalDelayType := 0 ps;
      thold_SN_C_posedge_posedge     :	VitalDelayType := 0 ps;
      thold_RN_C_posedge_posedge     :	VitalDelayType := 0 ps;
      tpw_C_posedge                  :	VitalDelayType := 1 ps;
      tpw_C_negedge                  :	VitalDelayType := 1 ps;
      tpw_RN_negedge                 :	VitalDelayType := 1 ps;
      tpw_SN_negedge                 :	VitalDelayType := 1 ps;
      tipd_C                         :	VitalDelayType01 := (0 ps, 0 ps);
      tipd_D                         :	VitalDelayType01 := (0 ps, 0 ps);
      tipd_RN                        :	VitalDelayType01 := (0 ps, 0 ps);
      tipd_SN                        :	VitalDelayType01 := (0 ps, 0 ps));

-- synopsys translate_on
   port(
      C                              :	in    STD_ULOGIC;
      D                              :	in    STD_ULOGIC;
      Q                              :	out   STD_ULOGIC;
      QN                             :	out   STD_ULOGIC;
      RN                             :	in    STD_ULOGIC;
      SN                             :	in    STD_ULOGIC);
end component;


----- Component DFE1 -----
component DFE1_3B
-- synopsys translate_off
   generic(
      TimingChecksOn: Boolean := DefaultTimingChecksOn;
      InstancePath: STRING := "*";
      Xon: Boolean := DefaultXon;
      MsgOn: Boolean := DefaultMsgOn;
      tpd_C_Q                        :	VitalDelayType01 := (1 ps, 1 ps);
      tpd_C_QN                       :	VitalDelayType01 := (1 ps, 1 ps);
      thold_D_C_posedge_posedge      :	VitalDelayType := -1 ps;
      thold_D_C_negedge_posedge      :	VitalDelayType := 1 ps;
      tsetup_D_C_posedge_posedge     :	VitalDelayType := 1 ps;
      tsetup_D_C_negedge_posedge     :	VitalDelayType := 1 ps;
      thold_E_C_posedge_posedge      :	VitalDelayType := -1 ps;
      thold_E_C_negedge_posedge      :	VitalDelayType := 0 ps;
      tsetup_E_C_posedge_posedge     :	VitalDelayType := 1 ps;
      tsetup_E_C_negedge_posedge     :	VitalDelayType := 1 ps;
      tpw_C_posedge                  :	VitalDelayType := 1 ps;
      tpw_C_negedge                  :	VitalDelayType := 1 ps;
      tipd_C                         :	VitalDelayType01 := (0 ps, 0 ps);
      tipd_D                         :	VitalDelayType01 := (0 ps, 0 ps);
      tipd_E                         :	VitalDelayType01 := (0 ps, 0 ps));

-- synopsys translate_on
   port(
      C                              :	in    STD_ULOGIC;
      D                              :	in    STD_ULOGIC;
      E                              :	in    STD_ULOGIC;
      Q                              :	out   STD_ULOGIC;
      QN                             :	out   STD_ULOGIC);
end component;


----- Component DFE3 -----
component DFE3_3B
-- synopsys translate_off
   generic(
      TimingChecksOn: Boolean := DefaultTimingChecksOn;
      InstancePath: STRING := "*";
      Xon: Boolean := DefaultXon;
      MsgOn: Boolean := DefaultMsgOn;
      tpd_C_Q                        :	VitalDelayType01 := (1 ps, 1 ps);
      tpd_C_QN                       :	VitalDelayType01 := (1 ps, 1 ps);
      thold_D_C_posedge_posedge      :	VitalDelayType := -1 ps;
      thold_D_C_negedge_posedge      :	VitalDelayType := -1 ps;
      tsetup_D_C_posedge_posedge     :	VitalDelayType := 1 ps;
      tsetup_D_C_negedge_posedge     :	VitalDelayType := 1 ps;
      thold_E_C_posedge_posedge      :	VitalDelayType := -1 ps;
      thold_E_C_negedge_posedge      :	VitalDelayType := 0 ps;
      tsetup_E_C_posedge_posedge     :	VitalDelayType := 1 ps;
      tsetup_E_C_negedge_posedge     :	VitalDelayType := 1 ps;
      tpw_C_posedge                  :	VitalDelayType := 1 ps;
      tpw_C_negedge                  :	VitalDelayType := 1 ps;
      tipd_C                         :	VitalDelayType01 := (0 ps, 0 ps);
      tipd_D                         :	VitalDelayType01 := (0 ps, 0 ps);
      tipd_E                         :	VitalDelayType01 := (0 ps, 0 ps));

-- synopsys translate_on
   port(
      C                              :	in    STD_ULOGIC;
      D                              :	in    STD_ULOGIC;
      E                              :	in    STD_ULOGIC;
      Q                              :	out   STD_ULOGIC;
      QN                             :	out   STD_ULOGIC);
end component;


----- Component DFEC1 -----
component DFEC1_3B
-- synopsys translate_off
   generic(
      TimingChecksOn: Boolean := DefaultTimingChecksOn;
      InstancePath: STRING := "*";
      Xon: Boolean := DefaultXon;
      MsgOn: Boolean := DefaultMsgOn;
      tpd_RN_Q                       :	VitalDelayType01 := (0 ps, 1 ps);
      tpd_C_Q                        :	VitalDelayType01 := (1 ps, 1 ps);
      tpd_RN_QN                      :	VitalDelayType01 := (1 ps, 0 ps);
      tpd_C_QN                       :	VitalDelayType01 := (1 ps, 1 ps);
      thold_D_C_posedge_posedge      :	VitalDelayType := 0 ps;
      thold_D_C_negedge_posedge      :	VitalDelayType := -1 ps;
      tsetup_D_C_posedge_posedge     :	VitalDelayType := 1 ps;
      tsetup_D_C_negedge_posedge     :	VitalDelayType := 1 ps;
      thold_E_C_posedge_posedge      :	VitalDelayType := 0 ps;
      thold_E_C_negedge_posedge      :	VitalDelayType := 1 ps;
      tsetup_E_C_posedge_posedge     :	VitalDelayType := 1 ps;
      tsetup_E_C_negedge_posedge     :	VitalDelayType := 1 ps;
      trecovery_RN_C_posedge_posedge :	VitalDelayType := 0 ps;
      thold_RN_C_posedge_posedge     :	VitalDelayType := 0 ps;
      tpw_C_posedge                  :	VitalDelayType := 1 ps;
      tpw_C_negedge                  :	VitalDelayType := 1 ps;
      tpw_RN_negedge                 :	VitalDelayType := 1 ps;
      tipd_C                         :	VitalDelayType01 := (0 ps, 0 ps);
      tipd_D                         :	VitalDelayType01 := (0 ps, 0 ps);
      tipd_E                         :	VitalDelayType01 := (0 ps, 0 ps);
      tipd_RN                        :	VitalDelayType01 := (0 ps, 0 ps));

-- synopsys translate_on
   port(
      C                              :	in    STD_ULOGIC;
      D                              :	in    STD_ULOGIC;
      E                              :	in    STD_ULOGIC;
      Q                              :	out   STD_ULOGIC;
      QN                             :	out   STD_ULOGIC;
      RN                             :	in    STD_ULOGIC);
end component;


----- Component DFEC3 -----
component DFEC3_3B
-- synopsys translate_off
   generic(
      TimingChecksOn: Boolean := DefaultTimingChecksOn;
      InstancePath: STRING := "*";
      Xon: Boolean := DefaultXon;
      MsgOn: Boolean := DefaultMsgOn;
      tpd_RN_Q                       :	VitalDelayType01 := (0 ps, 1 ps);
      tpd_C_Q                        :	VitalDelayType01 := (1 ps, 1 ps);
      tpd_RN_QN                      :	VitalDelayType01 := (1 ps, 0 ps);
      tpd_C_QN                       :	VitalDelayType01 := (1 ps, 1 ps);
      thold_D_C_posedge_posedge      :	VitalDelayType := -1 ps;
      thold_D_C_negedge_posedge      :	VitalDelayType := -1 ps;
      tsetup_D_C_posedge_posedge     :	VitalDelayType := 1 ps;
      tsetup_D_C_negedge_posedge     :	VitalDelayType := 1 ps;
      thold_E_C_posedge_posedge      :	VitalDelayType := -1 ps;
      thold_E_C_negedge_posedge      :	VitalDelayType := 0 ps;
      tsetup_E_C_posedge_posedge     :	VitalDelayType := 1 ps;
      tsetup_E_C_negedge_posedge     :	VitalDelayType := 1 ps;
      trecovery_RN_C_posedge_posedge :	VitalDelayType := 0 ps;
      thold_RN_C_posedge_posedge     :	VitalDelayType := 0 ps;
      tpw_C_posedge                  :	VitalDelayType := 1 ps;
      tpw_C_negedge                  :	VitalDelayType := 1 ps;
      tpw_RN_negedge                 :	VitalDelayType := 1 ps;
      tipd_C                         :	VitalDelayType01 := (0 ps, 0 ps);
      tipd_D                         :	VitalDelayType01 := (0 ps, 0 ps);
      tipd_E                         :	VitalDelayType01 := (0 ps, 0 ps);
      tipd_RN                        :	VitalDelayType01 := (0 ps, 0 ps));

-- synopsys translate_on
   port(
      C                              :	in    STD_ULOGIC;
      D                              :	in    STD_ULOGIC;
      E                              :	in    STD_ULOGIC;
      Q                              :	out   STD_ULOGIC;
      QN                             :	out   STD_ULOGIC;
      RN                             :	in    STD_ULOGIC);
end component;


----- Component DFECP1 -----
component DFECP1_3B
-- synopsys translate_off
   generic(
      TimingChecksOn: Boolean := DefaultTimingChecksOn;
      InstancePath: STRING := "*";
      Xon: Boolean := DefaultXon;
      MsgOn: Boolean := DefaultMsgOn;
      tpd_SN_Q                       :	VitalDelayType01 := (1 ps, 0 ps);
      tpd_RN_Q                       :	VitalDelayType01 := (1 ps, 1 ps);
      tpd_C_Q                        :	VitalDelayType01 := (1 ps, 1 ps);
      tpd_SN_QN                      :	VitalDelayType01 := (1 ps, 1 ps);
      tpd_RN_QN                      :	VitalDelayType01 := (1 ps, 0 ps);
      tpd_C_QN                       :	VitalDelayType01 := (1 ps, 1 ps);
      thold_D_C_posedge_posedge      :	VitalDelayType := -1 ps;
      thold_D_C_negedge_posedge      :	VitalDelayType := 1 ps;
      tsetup_D_C_posedge_posedge     :	VitalDelayType := 1 ps;
      tsetup_D_C_negedge_posedge     :	VitalDelayType := 1 ps;
      thold_E_C_posedge_posedge      :	VitalDelayType := 0 ps;
      thold_E_C_negedge_posedge      :	VitalDelayType := 1 ps;
      tsetup_E_C_posedge_posedge     :	VitalDelayType := 1 ps;
      tsetup_E_C_negedge_posedge     :	VitalDelayType := 1 ps;
      trecovery_RN_C_posedge_posedge :	VitalDelayType := 0 ps;
      trecovery_SN_C_posedge_posedge :	VitalDelayType := 0 ps;
      thold_SN_C_posedge_posedge     :	VitalDelayType := 0 ps;
      thold_RN_C_posedge_posedge     :	VitalDelayType := 0 ps;
      tpw_C_posedge                  :	VitalDelayType := 1 ps;
      tpw_C_negedge                  :	VitalDelayType := 1 ps;
      tpw_RN_negedge                 :	VitalDelayType := 1 ps;
      tpw_SN_negedge                 :	VitalDelayType := 1 ps;
      tipd_C                         :	VitalDelayType01 := (0 ps, 0 ps);
      tipd_D                         :	VitalDelayType01 := (0 ps, 0 ps);
      tipd_E                         :	VitalDelayType01 := (0 ps, 0 ps);
      tipd_RN                        :	VitalDelayType01 := (0 ps, 0 ps);
      tipd_SN                        :	VitalDelayType01 := (0 ps, 0 ps));

-- synopsys translate_on
   port(
      C                              :	in    STD_ULOGIC;
      D                              :	in    STD_ULOGIC;
      E                              :	in    STD_ULOGIC;
      Q                              :	out   STD_ULOGIC;
      QN                             :	out   STD_ULOGIC;
      RN                             :	in    STD_ULOGIC;
      SN                             :	in    STD_ULOGIC);
end component;


----- Component DFECP3 -----
component DFECP3_3B
-- synopsys translate_off
   generic(
      TimingChecksOn: Boolean := DefaultTimingChecksOn;
      InstancePath: STRING := "*";
      Xon: Boolean := DefaultXon;
      MsgOn: Boolean := DefaultMsgOn;
      tpd_SN_Q                       :	VitalDelayType01 := (1 ps, 0 ps);
      tpd_RN_Q                       :	VitalDelayType01 := (1 ps, 1 ps);
      tpd_C_Q                        :	VitalDelayType01 := (1 ps, 1 ps);
      tpd_SN_QN                      :	VitalDelayType01 := (1 ps, 1 ps);
      tpd_RN_QN                      :	VitalDelayType01 := (1 ps, 0 ps);
      tpd_C_QN                       :	VitalDelayType01 := (1 ps, 1 ps);
      thold_D_C_posedge_posedge      :	VitalDelayType := -1 ps;
      thold_D_C_negedge_posedge      :	VitalDelayType := -1 ps;
      tsetup_D_C_posedge_posedge     :	VitalDelayType := 1 ps;
      tsetup_D_C_negedge_posedge     :	VitalDelayType := 1 ps;
      thold_E_C_posedge_posedge      :	VitalDelayType := 0 ps;
      thold_E_C_negedge_posedge      :	VitalDelayType := 1 ps;
      tsetup_E_C_posedge_posedge     :	VitalDelayType := 1 ps;
      tsetup_E_C_negedge_posedge     :	VitalDelayType := 1 ps;
      trecovery_RN_C_posedge_posedge :	VitalDelayType := 0 ps;
      trecovery_SN_C_posedge_posedge :	VitalDelayType := 0 ps;
      thold_SN_C_posedge_posedge     :	VitalDelayType := 0 ps;
      thold_RN_C_posedge_posedge     :	VitalDelayType := 0 ps;
      tpw_C_posedge                  :	VitalDelayType := 1 ps;
      tpw_C_negedge                  :	VitalDelayType := 1 ps;
      tpw_RN_negedge                 :	VitalDelayType := 1 ps;
      tpw_SN_negedge                 :	VitalDelayType := 1 ps;
      tipd_C                         :	VitalDelayType01 := (0 ps, 0 ps);
      tipd_D                         :	VitalDelayType01 := (0 ps, 0 ps);
      tipd_E                         :	VitalDelayType01 := (0 ps, 0 ps);
      tipd_RN                        :	VitalDelayType01 := (0 ps, 0 ps);
      tipd_SN                        :	VitalDelayType01 := (0 ps, 0 ps));

-- synopsys translate_on
   port(
      C                              :	in    STD_ULOGIC;
      D                              :	in    STD_ULOGIC;
      E                              :	in    STD_ULOGIC;
      Q                              :	out   STD_ULOGIC;
      QN                             :	out   STD_ULOGIC;
      RN                             :	in    STD_ULOGIC;
      SN                             :	in    STD_ULOGIC);
end component;


----- Component DFEP1 -----
component DFEP1_3B
-- synopsys translate_off
   generic(
      TimingChecksOn: Boolean := DefaultTimingChecksOn;
      InstancePath: STRING := "*";
      Xon: Boolean := DefaultXon;
      MsgOn: Boolean := DefaultMsgOn;
      tpd_SN_Q                       :	VitalDelayType01 := (1 ps, 0 ps);
      tpd_C_Q                        :	VitalDelayType01 := (1 ps, 1 ps);
      tpd_SN_QN                      :	VitalDelayType01 := (0 ps, 1 ps);
      tpd_C_QN                       :	VitalDelayType01 := (1 ps, 1 ps);
      thold_D_C_posedge_posedge      :	VitalDelayType := -1 ps;
      thold_D_C_negedge_posedge      :	VitalDelayType := -1 ps;
      tsetup_D_C_posedge_posedge     :	VitalDelayType := 1 ps;
      tsetup_D_C_negedge_posedge     :	VitalDelayType := 1 ps;
      thold_E_C_posedge_posedge      :	VitalDelayType := 0 ps;
      thold_E_C_negedge_posedge      :	VitalDelayType := 1 ps;
      tsetup_E_C_posedge_posedge     :	VitalDelayType := 1 ps;
      tsetup_E_C_negedge_posedge     :	VitalDelayType := 1 ps;
      trecovery_SN_C_posedge_posedge :	VitalDelayType := 0 ps;
      thold_SN_C_posedge_posedge     :	VitalDelayType := 0 ps;
      tpw_C_posedge                  :	VitalDelayType := 1 ps;
      tpw_C_negedge                  :	VitalDelayType := 1 ps;
      tpw_SN_negedge                 :	VitalDelayType := 1 ps;
      tipd_C                         :	VitalDelayType01 := (0 ps, 0 ps);
      tipd_D                         :	VitalDelayType01 := (0 ps, 0 ps);
      tipd_E                         :	VitalDelayType01 := (0 ps, 0 ps);
      tipd_SN                        :	VitalDelayType01 := (0 ps, 0 ps));

-- synopsys translate_on
   port(
      C                              :	in    STD_ULOGIC;
      D                              :	in    STD_ULOGIC;
      E                              :	in    STD_ULOGIC;
      Q                              :	out   STD_ULOGIC;
      QN                             :	out   STD_ULOGIC;
      SN                             :	in    STD_ULOGIC);
end component;


----- Component DFEP3 -----
component DFEP3_3B
-- synopsys translate_off
   generic(
      TimingChecksOn: Boolean := DefaultTimingChecksOn;
      InstancePath: STRING := "*";
      Xon: Boolean := DefaultXon;
      MsgOn: Boolean := DefaultMsgOn;
      tpd_SN_Q                       :	VitalDelayType01 := (1 ps, 0 ps);
      tpd_C_Q                        :	VitalDelayType01 := (1 ps, 1 ps);
      tpd_SN_QN                      :	VitalDelayType01 := (0 ps, 1 ps);
      tpd_C_QN                       :	VitalDelayType01 := (1 ps, 1 ps);
      thold_D_C_posedge_posedge      :	VitalDelayType := 1 ps;
      thold_D_C_negedge_posedge      :	VitalDelayType := -1 ps;
      tsetup_D_C_posedge_posedge     :	VitalDelayType := 1 ps;
      tsetup_D_C_negedge_posedge     :	VitalDelayType := 1 ps;
      thold_E_C_posedge_posedge      :	VitalDelayType := 0 ps;
      thold_E_C_negedge_posedge      :	VitalDelayType := 1 ps;
      tsetup_E_C_posedge_posedge     :	VitalDelayType := 1 ps;
      tsetup_E_C_negedge_posedge     :	VitalDelayType := 1 ps;
      trecovery_SN_C_posedge_posedge :	VitalDelayType := 0 ps;
      thold_SN_C_posedge_posedge     :	VitalDelayType := 0 ps;
      tpw_C_posedge                  :	VitalDelayType := 1 ps;
      tpw_C_negedge                  :	VitalDelayType := 1 ps;
      tpw_SN_negedge                 :	VitalDelayType := 1 ps;
      tipd_C                         :	VitalDelayType01 := (0 ps, 0 ps);
      tipd_D                         :	VitalDelayType01 := (0 ps, 0 ps);
      tipd_E                         :	VitalDelayType01 := (0 ps, 0 ps);
      tipd_SN                        :	VitalDelayType01 := (0 ps, 0 ps));

-- synopsys translate_on
   port(
      C                              :	in    STD_ULOGIC;
      D                              :	in    STD_ULOGIC;
      E                              :	in    STD_ULOGIC;
      Q                              :	out   STD_ULOGIC;
      QN                             :	out   STD_ULOGIC;
      SN                             :	in    STD_ULOGIC);
end component;


----- Component DFP1 -----
component DFP1_3B
-- synopsys translate_off
   generic(
      TimingChecksOn: Boolean := DefaultTimingChecksOn;
      InstancePath: STRING := "*";
      Xon: Boolean := DefaultXon;
      MsgOn: Boolean := DefaultMsgOn;
      tpd_SN_Q                       :	VitalDelayType01 := (1 ps, 0 ps);
      tpd_C_Q                        :	VitalDelayType01 := (1 ps, 1 ps);
      tpd_SN_QN                      :	VitalDelayType01 := (0 ps, 1 ps);
      tpd_C_QN                       :	VitalDelayType01 := (1 ps, 1 ps);
      thold_D_C_posedge_posedge      :	VitalDelayType := 1 ps;
      thold_D_C_negedge_posedge      :	VitalDelayType := 0 ps;
      tsetup_D_C_posedge_posedge     :	VitalDelayType := 1 ps;
      tsetup_D_C_negedge_posedge     :	VitalDelayType := -1 ps;
      trecovery_SN_C_posedge_posedge :	VitalDelayType := 0 ps;
      thold_SN_C_posedge_posedge     :	VitalDelayType := 0 ps;
      tpw_C_posedge                  :	VitalDelayType := 1 ps;
      tpw_C_negedge                  :	VitalDelayType := 1 ps;
      tpw_SN_negedge                 :	VitalDelayType := 1 ps;
      tipd_C                         :	VitalDelayType01 := (0 ps, 0 ps);
      tipd_D                         :	VitalDelayType01 := (0 ps, 0 ps);
      tipd_SN                        :	VitalDelayType01 := (0 ps, 0 ps));

-- synopsys translate_on
   port(
      C                              :	in    STD_ULOGIC;
      D                              :	in    STD_ULOGIC;
      Q                              :	out   STD_ULOGIC;
      QN                             :	out   STD_ULOGIC;
      SN                             :	in    STD_ULOGIC);
end component;


----- Component DFP3 -----
component DFP3_3B
-- synopsys translate_off
   generic(
      TimingChecksOn: Boolean := DefaultTimingChecksOn;
      InstancePath: STRING := "*";
      Xon: Boolean := DefaultXon;
      MsgOn: Boolean := DefaultMsgOn;
      tpd_SN_Q                       :	VitalDelayType01 := (1 ps, 0 ps);
      tpd_C_Q                        :	VitalDelayType01 := (1 ps, 1 ps);
      tpd_SN_QN                      :	VitalDelayType01 := (0 ps, 1 ps);
      tpd_C_QN                       :	VitalDelayType01 := (1 ps, 1 ps);
      thold_D_C_posedge_posedge      :	VitalDelayType := -1 ps;
      thold_D_C_negedge_posedge      :	VitalDelayType := 0 ps;
      tsetup_D_C_posedge_posedge     :	VitalDelayType := 1 ps;
      tsetup_D_C_negedge_posedge     :	VitalDelayType := -1 ps;
      trecovery_SN_C_posedge_posedge :	VitalDelayType := 0 ps;
      thold_SN_C_posedge_posedge     :	VitalDelayType := 0 ps;
      tpw_C_posedge                  :	VitalDelayType := 1 ps;
      tpw_C_negedge                  :	VitalDelayType := 1 ps;
      tpw_SN_negedge                 :	VitalDelayType := 1 ps;
      tipd_C                         :	VitalDelayType01 := (0 ps, 0 ps);
      tipd_D                         :	VitalDelayType01 := (0 ps, 0 ps);
      tipd_SN                        :	VitalDelayType01 := (0 ps, 0 ps));

-- synopsys translate_on
   port(
      C                              :	in    STD_ULOGIC;
      D                              :	in    STD_ULOGIC;
      Q                              :	out   STD_ULOGIC;
      QN                             :	out   STD_ULOGIC;
      SN                             :	in    STD_ULOGIC);
end component;


----- Component DFS1 -----
component DFS1_3B
-- synopsys translate_off
   generic(
      TimingChecksOn: Boolean := DefaultTimingChecksOn;
      InstancePath: STRING := "*";
      Xon: Boolean := DefaultXon;
      MsgOn: Boolean := DefaultMsgOn;
      tpd_C_Q                        :	VitalDelayType01 := (1 ps, 1 ps);
      tpd_C_QN                       :	VitalDelayType01 := (1 ps, 1 ps);
      thold_D_C_negedge_posedge      :	VitalDelayType := 0 ps;
      tsetup_D_C_negedge_posedge     :	VitalDelayType := 1 ps;
      thold_SD_C_posedge_posedge     :	VitalDelayType := 1 ps;
      thold_SD_C_negedge_posedge     :	VitalDelayType := 0 ps;
      tsetup_SD_C_posedge_posedge    :	VitalDelayType := 1 ps;
      tsetup_SD_C_negedge_posedge    :	VitalDelayType := 1 ps;
      thold_SE_C_posedge_posedge     :	VitalDelayType := 0 ps;
      thold_SE_C_negedge_posedge     :	VitalDelayType := -1 ps;
      tsetup_SE_C_posedge_posedge    :	VitalDelayType := 1 ps;
      tsetup_SE_C_negedge_posedge    :	VitalDelayType := 1 ps;
      tpw_C_posedge                  :	VitalDelayType := 1 ps;
      tpw_C_negedge                  :	VitalDelayType := 1 ps;
      tipd_C                         :	VitalDelayType01 := (0 ps, 0 ps);
      tipd_D                         :	VitalDelayType01 := (0 ps, 0 ps);
      tipd_SD                        :	VitalDelayType01 := (0 ps, 0 ps);
      tipd_SE                        :	VitalDelayType01 := (0 ps, 0 ps));

-- synopsys translate_on
   port(
      C                              :	in    STD_ULOGIC;
      D                              :	in    STD_ULOGIC;
      Q                              :	out   STD_ULOGIC;
      QN                             :	out   STD_ULOGIC;
      SD                             :	in    STD_ULOGIC;
      SE                             :	in    STD_ULOGIC);
end component;


----- Component DFS3 -----
component DFS3_3B
-- synopsys translate_off
   generic(
      TimingChecksOn: Boolean := DefaultTimingChecksOn;
      InstancePath: STRING := "*";
      Xon: Boolean := DefaultXon;
      MsgOn: Boolean := DefaultMsgOn;
      tpd_C_Q                        :	VitalDelayType01 := (1 ps, 1 ps);
      tpd_C_QN                       :	VitalDelayType01 := (1 ps, 1 ps);
      thold_D_C_posedge_posedge      :	VitalDelayType := 0 ps;
      thold_D_C_negedge_posedge      :	VitalDelayType := 1 ps;
      tsetup_D_C_posedge_posedge     :	VitalDelayType := 1 ps;
      tsetup_D_C_negedge_posedge     :	VitalDelayType := 1 ps;
      thold_SD_C_posedge_posedge     :	VitalDelayType := -1 ps;
      thold_SD_C_negedge_posedge     :	VitalDelayType := 0 ps;
      tsetup_SD_C_posedge_posedge    :	VitalDelayType := 1 ps;
      tsetup_SD_C_negedge_posedge    :	VitalDelayType := 1 ps;
      thold_SE_C_posedge_posedge     :	VitalDelayType := -1 ps;
      thold_SE_C_negedge_posedge     :	VitalDelayType := -1 ps;
      tsetup_SE_C_posedge_posedge    :	VitalDelayType := 1 ps;
      tsetup_SE_C_negedge_posedge    :	VitalDelayType := 1 ps;
      tpw_C_posedge                  :	VitalDelayType := 1 ps;
      tpw_C_negedge                  :	VitalDelayType := 1 ps;
      tipd_C                         :	VitalDelayType01 := (0 ps, 0 ps);
      tipd_D                         :	VitalDelayType01 := (0 ps, 0 ps);
      tipd_SD                        :	VitalDelayType01 := (0 ps, 0 ps);
      tipd_SE                        :	VitalDelayType01 := (0 ps, 0 ps));

-- synopsys translate_on
   port(
      C                              :	in    STD_ULOGIC;
      D                              :	in    STD_ULOGIC;
      Q                              :	out   STD_ULOGIC;
      QN                             :	out   STD_ULOGIC;
      SD                             :	in    STD_ULOGIC;
      SE                             :	in    STD_ULOGIC);
end component;


----- Component DFSC1 -----
component DFSC1_3B
-- synopsys translate_off
   generic(
      TimingChecksOn: Boolean := DefaultTimingChecksOn;
      InstancePath: STRING := "*";
      Xon: Boolean := DefaultXon;
      MsgOn: Boolean := DefaultMsgOn;
      tpd_RN_Q                       :	VitalDelayType01 := (0 ps, 1 ps);
      tpd_C_Q                        :	VitalDelayType01 := (1 ps, 1 ps);
      tpd_RN_QN                      :	VitalDelayType01 := (1 ps, 0 ps);
      tpd_C_QN                       :	VitalDelayType01 := (1 ps, 1 ps);
      thold_D_C_posedge_posedge      :	VitalDelayType := 0 ps;
      thold_D_C_negedge_posedge      :	VitalDelayType := -1 ps;
      tsetup_D_C_posedge_posedge     :	VitalDelayType := 1 ps;
      tsetup_D_C_negedge_posedge     :	VitalDelayType := 1 ps;
      trecovery_RN_C_posedge_posedge :	VitalDelayType := 0 ps;
      thold_SD_C_posedge_posedge     :	VitalDelayType := 0 ps;
      thold_SD_C_negedge_posedge     :	VitalDelayType := 1 ps;
      tsetup_SD_C_posedge_posedge    :	VitalDelayType := 1 ps;
      tsetup_SD_C_negedge_posedge    :	VitalDelayType := 1 ps;
      thold_SE_C_posedge_posedge     :	VitalDelayType := 0 ps;
      thold_SE_C_negedge_posedge     :	VitalDelayType := -1 ps;
      tsetup_SE_C_posedge_posedge    :	VitalDelayType := 1 ps;
      tsetup_SE_C_negedge_posedge    :	VitalDelayType := 1 ps;
      thold_RN_C_posedge_posedge     :	VitalDelayType := 0 ps;
      tpw_C_posedge                  :	VitalDelayType := 1 ps;
      tpw_C_negedge                  :	VitalDelayType := 1 ps;
      tpw_RN_negedge                 :	VitalDelayType := 1 ps;
      tipd_C                         :	VitalDelayType01 := (0 ps, 0 ps);
      tipd_D                         :	VitalDelayType01 := (0 ps, 0 ps);
      tipd_RN                        :	VitalDelayType01 := (0 ps, 0 ps);
      tipd_SD                        :	VitalDelayType01 := (0 ps, 0 ps);
      tipd_SE                        :	VitalDelayType01 := (0 ps, 0 ps));

-- synopsys translate_on
   port(
      C                              :	in    STD_ULOGIC;
      D                              :	in    STD_ULOGIC;
      Q                              :	out   STD_ULOGIC;
      QN                             :	out   STD_ULOGIC;
      RN                             :	in    STD_ULOGIC;
      SD                             :	in    STD_ULOGIC;
      SE                             :	in    STD_ULOGIC);
end component;


----- Component DFSC3 -----
component DFSC3_3B
-- synopsys translate_off
   generic(
      TimingChecksOn: Boolean := DefaultTimingChecksOn;
      InstancePath: STRING := "*";
      Xon: Boolean := DefaultXon;
      MsgOn: Boolean := DefaultMsgOn;
      tpd_RN_Q                       :	VitalDelayType01 := (0 ps, 1 ps);
      tpd_C_Q                        :	VitalDelayType01 := (1 ps, 1 ps);
      tpd_RN_QN                      :	VitalDelayType01 := (1 ps, 0 ps);
      tpd_C_QN                       :	VitalDelayType01 := (1 ps, 1 ps);
      thold_D_C_posedge_posedge      :	VitalDelayType := 0 ps;
      thold_D_C_negedge_posedge      :	VitalDelayType := 1 ps;
      tsetup_D_C_posedge_posedge     :	VitalDelayType := 1 ps;
      tsetup_D_C_negedge_posedge     :	VitalDelayType := 1 ps;
      trecovery_RN_C_posedge_posedge :	VitalDelayType := 0 ps;
      thold_SD_C_posedge_posedge     :	VitalDelayType := -1 ps;
      thold_SD_C_negedge_posedge     :	VitalDelayType := -1 ps;
      tsetup_SD_C_posedge_posedge    :	VitalDelayType := 1 ps;
      tsetup_SD_C_negedge_posedge    :	VitalDelayType := 1 ps;
      thold_SE_C_posedge_posedge     :	VitalDelayType := -1 ps;
      thold_SE_C_negedge_posedge     :	VitalDelayType := -1 ps;
      tsetup_SE_C_posedge_posedge    :	VitalDelayType := 1 ps;
      tsetup_SE_C_negedge_posedge    :	VitalDelayType := 1 ps;
      thold_RN_C_posedge_posedge     :	VitalDelayType := 0 ps;
      tpw_C_posedge                  :	VitalDelayType := 1 ps;
      tpw_C_negedge                  :	VitalDelayType := 1 ps;
      tpw_RN_negedge                 :	VitalDelayType := 1 ps;
      tipd_C                         :	VitalDelayType01 := (0 ps, 0 ps);
      tipd_D                         :	VitalDelayType01 := (0 ps, 0 ps);
      tipd_RN                        :	VitalDelayType01 := (0 ps, 0 ps);
      tipd_SD                        :	VitalDelayType01 := (0 ps, 0 ps);
      tipd_SE                        :	VitalDelayType01 := (0 ps, 0 ps));

-- synopsys translate_on
   port(
      C                              :	in    STD_ULOGIC;
      D                              :	in    STD_ULOGIC;
      Q                              :	out   STD_ULOGIC;
      QN                             :	out   STD_ULOGIC;
      RN                             :	in    STD_ULOGIC;
      SD                             :	in    STD_ULOGIC;
      SE                             :	in    STD_ULOGIC);
end component;


----- Component DFSCP1 -----
component DFSCP1_3B
-- synopsys translate_off
   generic(
      TimingChecksOn: Boolean := DefaultTimingChecksOn;
      InstancePath: STRING := "*";
      Xon: Boolean := DefaultXon;
      MsgOn: Boolean := DefaultMsgOn;
      tpd_RN_Q                       :	VitalDelayType01 := (1 ps, 1 ps);
      tpd_SN_Q                       :	VitalDelayType01 := (1 ps, 0 ps);
      tpd_C_Q                        :	VitalDelayType01 := (1 ps, 1 ps);
      tpd_RN_QN                      :	VitalDelayType01 := (1 ps, 0 ps);
      tpd_SN_QN                      :	VitalDelayType01 := (1 ps, 1 ps);
      tpd_C_QN                       :	VitalDelayType01 := (1 ps, 1 ps);
      thold_D_C_posedge_posedge      :	VitalDelayType := 0 ps;
      thold_D_C_negedge_posedge      :	VitalDelayType := -1 ps;
      tsetup_D_C_posedge_posedge     :	VitalDelayType := 1 ps;
      tsetup_D_C_negedge_posedge     :	VitalDelayType := 1 ps;
      trecovery_RN_C_posedge_posedge :	VitalDelayType := 0 ps;
      thold_SD_C_posedge_posedge     :	VitalDelayType := 1 ps;
      thold_SD_C_negedge_posedge     :	VitalDelayType := 1 ps;
      tsetup_SD_C_posedge_posedge    :	VitalDelayType := 1 ps;
      tsetup_SD_C_negedge_posedge    :	VitalDelayType := 1 ps;
      thold_SE_C_posedge_posedge     :	VitalDelayType := -1 ps;
      thold_SE_C_negedge_posedge     :	VitalDelayType := -1 ps;
      tsetup_SE_C_posedge_posedge    :	VitalDelayType := 1 ps;
      tsetup_SE_C_negedge_posedge    :	VitalDelayType := 1 ps;
      trecovery_SN_C_posedge_posedge :	VitalDelayType := 0 ps;
      thold_SN_C_posedge_posedge     :	VitalDelayType := 0 ps;
      thold_RN_C_posedge_posedge     :	VitalDelayType := 0 ps;
      tpw_C_posedge                  :	VitalDelayType := 1 ps;
      tpw_C_negedge                  :	VitalDelayType := 1 ps;
      tpw_RN_negedge                 :	VitalDelayType := 1 ps;
      tpw_SN_negedge                 :	VitalDelayType := 1 ps;
      tipd_C                         :	VitalDelayType01 := (0 ps, 0 ps);
      tipd_D                         :	VitalDelayType01 := (0 ps, 0 ps);
      tipd_RN                        :	VitalDelayType01 := (0 ps, 0 ps);
      tipd_SD                        :	VitalDelayType01 := (0 ps, 0 ps);
      tipd_SE                        :	VitalDelayType01 := (0 ps, 0 ps);
      tipd_SN                        :	VitalDelayType01 := (0 ps, 0 ps));

-- synopsys translate_on
   port(
      C                              :	in    STD_ULOGIC;
      D                              :	in    STD_ULOGIC;
      Q                              :	out   STD_ULOGIC;
      QN                             :	out   STD_ULOGIC;
      RN                             :	in    STD_ULOGIC;
      SD                             :	in    STD_ULOGIC;
      SE                             :	in    STD_ULOGIC;
      SN                             :	in    STD_ULOGIC);
end component;


----- Component DFSCP3 -----
component DFSCP3_3B
-- synopsys translate_off
   generic(
      TimingChecksOn: Boolean := DefaultTimingChecksOn;
      InstancePath: STRING := "*";
      Xon: Boolean := DefaultXon;
      MsgOn: Boolean := DefaultMsgOn;
      tpd_RN_Q                       :	VitalDelayType01 := (1 ps, 1 ps);
      tpd_SN_Q                       :	VitalDelayType01 := (1 ps, 0 ps);
      tpd_C_Q                        :	VitalDelayType01 := (1 ps, 1 ps);
      tpd_RN_QN                      :	VitalDelayType01 := (1 ps, 0 ps);
      tpd_SN_QN                      :	VitalDelayType01 := (1 ps, 1 ps);
      tpd_C_QN                       :	VitalDelayType01 := (1 ps, 1 ps);
      thold_D_C_posedge_posedge      :	VitalDelayType := 0 ps;
      thold_D_C_negedge_posedge      :	VitalDelayType := 1 ps;
      tsetup_D_C_posedge_posedge     :	VitalDelayType := 1 ps;
      tsetup_D_C_negedge_posedge     :	VitalDelayType := 1 ps;
      trecovery_RN_C_posedge_posedge :	VitalDelayType := 0 ps;
      thold_SD_C_posedge_posedge     :	VitalDelayType := -1 ps;
      thold_SD_C_negedge_posedge     :	VitalDelayType := -1 ps;
      tsetup_SD_C_posedge_posedge    :	VitalDelayType := 1 ps;
      tsetup_SD_C_negedge_posedge    :	VitalDelayType := 1 ps;
      thold_SE_C_posedge_posedge     :	VitalDelayType := -1 ps;
      thold_SE_C_negedge_posedge     :	VitalDelayType := 0 ps;
      tsetup_SE_C_posedge_posedge    :	VitalDelayType := 1 ps;
      tsetup_SE_C_negedge_posedge    :	VitalDelayType := 1 ps;
      trecovery_SN_C_posedge_posedge :	VitalDelayType := 0 ps;
      thold_SN_C_posedge_posedge     :	VitalDelayType := 0 ps;
      thold_RN_C_posedge_posedge     :	VitalDelayType := 0 ps;
      tpw_C_posedge                  :	VitalDelayType := 1 ps;
      tpw_C_negedge                  :	VitalDelayType := 1 ps;
      tpw_RN_negedge                 :	VitalDelayType := 1 ps;
      tpw_SN_negedge                 :	VitalDelayType := 1 ps;
      tipd_C                         :	VitalDelayType01 := (0 ps, 0 ps);
      tipd_D                         :	VitalDelayType01 := (0 ps, 0 ps);
      tipd_RN                        :	VitalDelayType01 := (0 ps, 0 ps);
      tipd_SD                        :	VitalDelayType01 := (0 ps, 0 ps);
      tipd_SE                        :	VitalDelayType01 := (0 ps, 0 ps);
      tipd_SN                        :	VitalDelayType01 := (0 ps, 0 ps));

-- synopsys translate_on
   port(
      C                              :	in    STD_ULOGIC;
      D                              :	in    STD_ULOGIC;
      Q                              :	out   STD_ULOGIC;
      QN                             :	out   STD_ULOGIC;
      RN                             :	in    STD_ULOGIC;
      SD                             :	in    STD_ULOGIC;
      SE                             :	in    STD_ULOGIC;
      SN                             :	in    STD_ULOGIC);
end component;


----- Component DFSE1 -----
component DFSE1_3B
-- synopsys translate_off
   generic(
      TimingChecksOn: Boolean := DefaultTimingChecksOn;
      InstancePath: STRING := "*";
      Xon: Boolean := DefaultXon;
      MsgOn: Boolean := DefaultMsgOn;
      tpd_C_Q                        :	VitalDelayType01 := (1 ps, 1 ps);
      tpd_C_QN                       :	VitalDelayType01 := (1 ps, 1 ps);
      thold_D_C_posedge_posedge      :	VitalDelayType := 0 ps;
      thold_D_C_negedge_posedge      :	VitalDelayType := 1 ps;
      tsetup_D_C_posedge_posedge     :	VitalDelayType := 1 ps;
      tsetup_D_C_negedge_posedge     :	VitalDelayType := 1 ps;
      thold_E_C_posedge_posedge      :	VitalDelayType := 0 ps;
      thold_E_C_negedge_posedge      :	VitalDelayType := 1 ps;
      tsetup_E_C_posedge_posedge     :	VitalDelayType := 1 ps;
      tsetup_E_C_negedge_posedge     :	VitalDelayType := 1 ps;
      thold_SD_C_posedge_posedge     :	VitalDelayType := 0 ps;
      thold_SD_C_negedge_posedge     :	VitalDelayType := -1 ps;
      tsetup_SD_C_posedge_posedge    :	VitalDelayType := 1 ps;
      tsetup_SD_C_negedge_posedge    :	VitalDelayType := 1 ps;
      thold_SE_C_posedge_posedge     :	VitalDelayType := 0 ps;
      thold_SE_C_negedge_posedge     :	VitalDelayType := -1 ps;
      tsetup_SE_C_posedge_posedge    :	VitalDelayType := 1 ps;
      tsetup_SE_C_negedge_posedge    :	VitalDelayType := 1 ps;
      tpw_C_posedge                  :	VitalDelayType := 1 ps;
      tpw_C_negedge                  :	VitalDelayType := 1 ps;
      tipd_C                         :	VitalDelayType01 := (0 ps, 0 ps);
      tipd_D                         :	VitalDelayType01 := (0 ps, 0 ps);
      tipd_E                         :	VitalDelayType01 := (0 ps, 0 ps);
      tipd_SD                        :	VitalDelayType01 := (0 ps, 0 ps);
      tipd_SE                        :	VitalDelayType01 := (0 ps, 0 ps));

-- synopsys translate_on
   port(
      C                              :	in    STD_ULOGIC;
      D                              :	in    STD_ULOGIC;
      E                              :	in    STD_ULOGIC;
      Q                              :	out   STD_ULOGIC;
      QN                             :	out   STD_ULOGIC;
      SD                             :	in    STD_ULOGIC;
      SE                             :	in    STD_ULOGIC);
end component;


----- Component DFSE3 -----
component DFSE3_3B
-- synopsys translate_off
   generic(
      TimingChecksOn: Boolean := DefaultTimingChecksOn;
      InstancePath: STRING := "*";
      Xon: Boolean := DefaultXon;
      MsgOn: Boolean := DefaultMsgOn;
      tpd_C_Q                        :	VitalDelayType01 := (1 ps, 1 ps);
      tpd_C_QN                       :	VitalDelayType01 := (1 ps, 1 ps);
      thold_D_C_posedge_posedge      :	VitalDelayType := 0 ps;
      thold_D_C_negedge_posedge      :	VitalDelayType := -1 ps;
      tsetup_D_C_posedge_posedge     :	VitalDelayType := 1 ps;
      tsetup_D_C_negedge_posedge     :	VitalDelayType := 1 ps;
      thold_E_C_posedge_posedge      :	VitalDelayType := 0 ps;
      thold_E_C_negedge_posedge      :	VitalDelayType := 1 ps;
      tsetup_E_C_posedge_posedge     :	VitalDelayType := 1 ps;
      tsetup_E_C_negedge_posedge     :	VitalDelayType := 1 ps;
      thold_SD_C_posedge_posedge     :	VitalDelayType := -1 ps;
      thold_SD_C_negedge_posedge     :	VitalDelayType := -1 ps;
      tsetup_SD_C_posedge_posedge    :	VitalDelayType := 1 ps;
      tsetup_SD_C_negedge_posedge    :	VitalDelayType := 1 ps;
      thold_SE_C_posedge_posedge     :	VitalDelayType := -1 ps;
      thold_SE_C_negedge_posedge     :	VitalDelayType := -1 ps;
      tsetup_SE_C_posedge_posedge    :	VitalDelayType := 1 ps;
      tsetup_SE_C_negedge_posedge    :	VitalDelayType := 1 ps;
      tpw_C_posedge                  :	VitalDelayType := 1 ps;
      tpw_C_negedge                  :	VitalDelayType := 1 ps;
      tipd_C                         :	VitalDelayType01 := (0 ps, 0 ps);
      tipd_D                         :	VitalDelayType01 := (0 ps, 0 ps);
      tipd_E                         :	VitalDelayType01 := (0 ps, 0 ps);
      tipd_SD                        :	VitalDelayType01 := (0 ps, 0 ps);
      tipd_SE                        :	VitalDelayType01 := (0 ps, 0 ps));

-- synopsys translate_on
   port(
      C                              :	in    STD_ULOGIC;
      D                              :	in    STD_ULOGIC;
      E                              :	in    STD_ULOGIC;
      Q                              :	out   STD_ULOGIC;
      QN                             :	out   STD_ULOGIC;
      SD                             :	in    STD_ULOGIC;
      SE                             :	in    STD_ULOGIC);
end component;


----- Component DFSEC1 -----
component DFSEC1_3B
-- synopsys translate_off
   generic(
      TimingChecksOn: Boolean := DefaultTimingChecksOn;
      InstancePath: STRING := "*";
      Xon: Boolean := DefaultXon;
      MsgOn: Boolean := DefaultMsgOn;
      tpd_RN_Q                       :	VitalDelayType01 := (0 ps, 1 ps);
      tpd_C_Q                        :	VitalDelayType01 := (1 ps, 1 ps);
      tpd_RN_QN                      :	VitalDelayType01 := (1 ps, 0 ps);
      tpd_C_QN                       :	VitalDelayType01 := (1 ps, 1 ps);
      thold_D_C_posedge_posedge      :	VitalDelayType := -1 ps;
      thold_D_C_negedge_posedge      :	VitalDelayType := -1 ps;
      tsetup_D_C_posedge_posedge     :	VitalDelayType := 1 ps;
      tsetup_D_C_negedge_posedge     :	VitalDelayType := 1 ps;
      thold_E_C_posedge_posedge      :	VitalDelayType := 0 ps;
      thold_E_C_negedge_posedge      :	VitalDelayType := 1 ps;
      tsetup_E_C_posedge_posedge     :	VitalDelayType := 1 ps;
      tsetup_E_C_negedge_posedge     :	VitalDelayType := 1 ps;
      trecovery_RN_C_posedge_posedge :	VitalDelayType := 0 ps;
      thold_SD_C_posedge_posedge     :	VitalDelayType := -1 ps;
      thold_SD_C_negedge_posedge     :	VitalDelayType := -1 ps;
      tsetup_SD_C_posedge_posedge    :	VitalDelayType := 1 ps;
      tsetup_SD_C_negedge_posedge    :	VitalDelayType := 1 ps;
      thold_SE_C_posedge_posedge     :	VitalDelayType := -1 ps;
      thold_SE_C_negedge_posedge     :	VitalDelayType := -1 ps;
      tsetup_SE_C_posedge_posedge    :	VitalDelayType := 1 ps;
      tsetup_SE_C_negedge_posedge    :	VitalDelayType := 1 ps;
      thold_RN_C_posedge_posedge     :	VitalDelayType := 0 ps;
      tpw_C_posedge                  :	VitalDelayType := 1 ps;
      tpw_C_negedge                  :	VitalDelayType := 1 ps;
      tpw_RN_negedge                 :	VitalDelayType := 1 ps;
      tipd_C                         :	VitalDelayType01 := (0 ps, 0 ps);
      tipd_D                         :	VitalDelayType01 := (0 ps, 0 ps);
      tipd_E                         :	VitalDelayType01 := (0 ps, 0 ps);
      tipd_RN                        :	VitalDelayType01 := (0 ps, 0 ps);
      tipd_SD                        :	VitalDelayType01 := (0 ps, 0 ps);
      tipd_SE                        :	VitalDelayType01 := (0 ps, 0 ps));

-- synopsys translate_on
   port(
      C                              :	in    STD_ULOGIC;
      D                              :	in    STD_ULOGIC;
      E                              :	in    STD_ULOGIC;
      Q                              :	out   STD_ULOGIC;
      QN                             :	out   STD_ULOGIC;
      RN                             :	in    STD_ULOGIC;
      SD                             :	in    STD_ULOGIC;
      SE                             :	in    STD_ULOGIC);
end component;


----- Component DFSEC3 -----
component DFSEC3_3B
-- synopsys translate_off
   generic(
      TimingChecksOn: Boolean := DefaultTimingChecksOn;
      InstancePath: STRING := "*";
      Xon: Boolean := DefaultXon;
      MsgOn: Boolean := DefaultMsgOn;
      tpd_RN_Q                       :	VitalDelayType01 := (0 ps, 1 ps);
      tpd_C_Q                        :	VitalDelayType01 := (1 ps, 1 ps);
      tpd_RN_QN                      :	VitalDelayType01 := (1 ps, 0 ps);
      tpd_C_QN                       :	VitalDelayType01 := (1 ps, 1 ps);
      thold_D_C_posedge_posedge      :	VitalDelayType := -1 ps;
      thold_D_C_negedge_posedge      :	VitalDelayType := -1 ps;
      tsetup_D_C_posedge_posedge     :	VitalDelayType := 0 ps;
      tsetup_D_C_negedge_posedge     :	VitalDelayType := 1 ps;
      thold_E_C_posedge_posedge      :	VitalDelayType := 0 ps;
      thold_E_C_negedge_posedge      :	VitalDelayType := 1 ps;
      tsetup_E_C_posedge_posedge     :	VitalDelayType := 1 ps;
      tsetup_E_C_negedge_posedge     :	VitalDelayType := 1 ps;
      trecovery_RN_C_posedge_posedge :	VitalDelayType := 0 ps;
      thold_SD_C_posedge_posedge     :	VitalDelayType := 0 ps;
      thold_SD_C_negedge_posedge     :	VitalDelayType := 1 ps;
      tsetup_SD_C_posedge_posedge    :	VitalDelayType := 0 ps;
      tsetup_SD_C_negedge_posedge    :	VitalDelayType := -1 ps;
      thold_SE_C_posedge_posedge     :	VitalDelayType := 0 ps;
      thold_SE_C_negedge_posedge     :	VitalDelayType := -1 ps;
      tsetup_SE_C_posedge_posedge    :	VitalDelayType := 1 ps;
      tsetup_SE_C_negedge_posedge    :	VitalDelayType := 1 ps;
      thold_RN_C_posedge_posedge     :	VitalDelayType := 0 ps;
      tpw_C_posedge                  :	VitalDelayType := 1 ps;
      tpw_C_negedge                  :	VitalDelayType := 1 ps;
      tpw_RN_negedge                 :	VitalDelayType := 1 ps;
      tipd_C                         :	VitalDelayType01 := (0 ps, 0 ps);
      tipd_D                         :	VitalDelayType01 := (0 ps, 0 ps);
      tipd_E                         :	VitalDelayType01 := (0 ps, 0 ps);
      tipd_RN                        :	VitalDelayType01 := (0 ps, 0 ps);
      tipd_SD                        :	VitalDelayType01 := (0 ps, 0 ps);
      tipd_SE                        :	VitalDelayType01 := (0 ps, 0 ps));

-- synopsys translate_on
   port(
      C                              :	in    STD_ULOGIC;
      D                              :	in    STD_ULOGIC;
      E                              :	in    STD_ULOGIC;
      Q                              :	out   STD_ULOGIC;
      QN                             :	out   STD_ULOGIC;
      RN                             :	in    STD_ULOGIC;
      SD                             :	in    STD_ULOGIC;
      SE                             :	in    STD_ULOGIC);
end component;


----- Component DFSECP1 -----
component DFSECP1_3B
-- synopsys translate_off
   generic(
      TimingChecksOn: Boolean := DefaultTimingChecksOn;
      InstancePath: STRING := "*";
      Xon: Boolean := DefaultXon;
      MsgOn: Boolean := DefaultMsgOn;
      tpd_SN_Q                       :	VitalDelayType01 := (1 ps, 0 ps);
      tpd_RN_Q                       :	VitalDelayType01 := (1 ps, 1 ps);
      tpd_C_Q                        :	VitalDelayType01 := (1 ps, 1 ps);
      tpd_SN_QN                      :	VitalDelayType01 := (1 ps, 1 ps);
      tpd_RN_QN                      :	VitalDelayType01 := (1 ps, 0 ps);
      tpd_C_QN                       :	VitalDelayType01 := (1 ps, 1 ps);
      thold_D_C_posedge_posedge      :	VitalDelayType := 1 ps;
      thold_D_C_negedge_posedge      :	VitalDelayType := 0 ps;
      tsetup_D_C_posedge_posedge     :	VitalDelayType := 1 ps;
      tsetup_D_C_negedge_posedge     :	VitalDelayType := 1 ps;
      thold_E_C_posedge_posedge      :	VitalDelayType := 0 ps;
      thold_E_C_negedge_posedge      :	VitalDelayType := 1 ps;
      tsetup_E_C_posedge_posedge     :	VitalDelayType := 1 ps;
      tsetup_E_C_negedge_posedge     :	VitalDelayType := 1 ps;
      trecovery_RN_C_posedge_posedge :	VitalDelayType := 0 ps;
      thold_SD_C_posedge_posedge     :	VitalDelayType := 1 ps;
      thold_SD_C_negedge_posedge     :	VitalDelayType := 1 ps;
      tsetup_SD_C_posedge_posedge    :	VitalDelayType := 1 ps;
      tsetup_SD_C_negedge_posedge    :	VitalDelayType := 1 ps;
      thold_SE_C_posedge_posedge     :	VitalDelayType := -1 ps;
      thold_SE_C_negedge_posedge     :	VitalDelayType := -1 ps;
      tsetup_SE_C_posedge_posedge    :	VitalDelayType := 1 ps;
      tsetup_SE_C_negedge_posedge    :	VitalDelayType := 1 ps;
      trecovery_SN_C_posedge_posedge :	VitalDelayType := 0 ps;
      thold_SN_C_posedge_posedge     :	VitalDelayType := 0 ps;
      thold_RN_C_posedge_posedge     :	VitalDelayType := 0 ps;
      tpw_C_posedge                  :	VitalDelayType := 1 ps;
      tpw_C_negedge                  :	VitalDelayType := 1 ps;
      tpw_RN_negedge                 :	VitalDelayType := 1 ps;
      tpw_SN_negedge                 :	VitalDelayType := 1 ps;
      tipd_C                         :	VitalDelayType01 := (0 ps, 0 ps);
      tipd_D                         :	VitalDelayType01 := (0 ps, 0 ps);
      tipd_E                         :	VitalDelayType01 := (0 ps, 0 ps);
      tipd_RN                        :	VitalDelayType01 := (0 ps, 0 ps);
      tipd_SD                        :	VitalDelayType01 := (0 ps, 0 ps);
      tipd_SE                        :	VitalDelayType01 := (0 ps, 0 ps);
      tipd_SN                        :	VitalDelayType01 := (0 ps, 0 ps));

-- synopsys translate_on
   port(
      C                              :	in    STD_ULOGIC;
      D                              :	in    STD_ULOGIC;
      E                              :	in    STD_ULOGIC;
      Q                              :	out   STD_ULOGIC;
      QN                             :	out   STD_ULOGIC;
      RN                             :	in    STD_ULOGIC;
      SD                             :	in    STD_ULOGIC;
      SE                             :	in    STD_ULOGIC;
      SN                             :	in    STD_ULOGIC);
end component;


----- Component DFSECP3 -----
component DFSECP3_3B
-- synopsys translate_off
   generic(
      TimingChecksOn: Boolean := DefaultTimingChecksOn;
      InstancePath: STRING := "*";
      Xon: Boolean := DefaultXon;
      MsgOn: Boolean := DefaultMsgOn;
      tpd_SN_Q                       :	VitalDelayType01 := (1 ps, 0 ps);
      tpd_RN_Q                       :	VitalDelayType01 := (1 ps, 1 ps);
      tpd_C_Q                        :	VitalDelayType01 := (1 ps, 1 ps);
      tpd_SN_QN                      :	VitalDelayType01 := (1 ps, 1 ps);
      tpd_RN_QN                      :	VitalDelayType01 := (1 ps, 0 ps);
      tpd_C_QN                       :	VitalDelayType01 := (1 ps, 1 ps);
      thold_D_C_posedge_posedge      :	VitalDelayType := 0 ps;
      thold_D_C_negedge_posedge      :	VitalDelayType := 1 ps;
      tsetup_D_C_posedge_posedge     :	VitalDelayType := 1 ps;
      tsetup_D_C_negedge_posedge     :	VitalDelayType := 1 ps;
      thold_E_C_posedge_posedge      :	VitalDelayType := 0 ps;
      thold_E_C_negedge_posedge      :	VitalDelayType := 1 ps;
      tsetup_E_C_posedge_posedge     :	VitalDelayType := 1 ps;
      tsetup_E_C_negedge_posedge     :	VitalDelayType := 1 ps;
      trecovery_RN_C_posedge_posedge :	VitalDelayType := 0 ps;
      thold_SD_C_posedge_posedge     :	VitalDelayType := -1 ps;
      thold_SD_C_negedge_posedge     :	VitalDelayType := 0 ps;
      tsetup_SD_C_posedge_posedge    :	VitalDelayType := 1 ps;
      tsetup_SD_C_negedge_posedge    :	VitalDelayType := 1 ps;
      thold_SE_C_posedge_posedge     :	VitalDelayType := -1 ps;
      thold_SE_C_negedge_posedge     :	VitalDelayType := -1 ps;
      tsetup_SE_C_posedge_posedge    :	VitalDelayType := 1 ps;
      tsetup_SE_C_negedge_posedge    :	VitalDelayType := 1 ps;
      trecovery_SN_C_posedge_posedge :	VitalDelayType := 0 ps;
      thold_SN_C_posedge_posedge     :	VitalDelayType := 0 ps;
      thold_RN_C_posedge_posedge     :	VitalDelayType := 0 ps;
      tpw_C_posedge                  :	VitalDelayType := 1 ps;
      tpw_C_negedge                  :	VitalDelayType := 1 ps;
      tpw_RN_negedge                 :	VitalDelayType := 1 ps;
      tpw_SN_negedge                 :	VitalDelayType := 1 ps;
      tipd_C                         :	VitalDelayType01 := (0 ps, 0 ps);
      tipd_D                         :	VitalDelayType01 := (0 ps, 0 ps);
      tipd_E                         :	VitalDelayType01 := (0 ps, 0 ps);
      tipd_RN                        :	VitalDelayType01 := (0 ps, 0 ps);
      tipd_SD                        :	VitalDelayType01 := (0 ps, 0 ps);
      tipd_SE                        :	VitalDelayType01 := (0 ps, 0 ps);
      tipd_SN                        :	VitalDelayType01 := (0 ps, 0 ps));

-- synopsys translate_on
   port(
      C                              :	in    STD_ULOGIC;
      D                              :	in    STD_ULOGIC;
      E                              :	in    STD_ULOGIC;
      Q                              :	out   STD_ULOGIC;
      QN                             :	out   STD_ULOGIC;
      RN                             :	in    STD_ULOGIC;
      SD                             :	in    STD_ULOGIC;
      SE                             :	in    STD_ULOGIC;
      SN                             :	in    STD_ULOGIC);
end component;


----- Component DFSEP1 -----
component DFSEP1_3B
-- synopsys translate_off
   generic(
      TimingChecksOn: Boolean := DefaultTimingChecksOn;
      InstancePath: STRING := "*";
      Xon: Boolean := DefaultXon;
      MsgOn: Boolean := DefaultMsgOn;
      tpd_SN_Q                       :	VitalDelayType01 := (1 ps, 0 ps);
      tpd_C_Q                        :	VitalDelayType01 := (1 ps, 1 ps);
      tpd_SN_QN                      :	VitalDelayType01 := (0 ps, 1 ps);
      tpd_C_QN                       :	VitalDelayType01 := (1 ps, 1 ps);
      thold_D_C_posedge_posedge      :	VitalDelayType := 0 ps;
      thold_D_C_negedge_posedge      :	VitalDelayType := 1 ps;
      tsetup_D_C_posedge_posedge     :	VitalDelayType := 1 ps;
      tsetup_D_C_negedge_posedge     :	VitalDelayType := 1 ps;
      thold_E_C_posedge_posedge      :	VitalDelayType := 0 ps;
      thold_E_C_negedge_posedge      :	VitalDelayType := -1 ps;
      tsetup_E_C_posedge_posedge     :	VitalDelayType := 1 ps;
      tsetup_E_C_negedge_posedge     :	VitalDelayType := 1 ps;
      thold_SD_C_posedge_posedge     :	VitalDelayType := -1 ps;
      thold_SD_C_negedge_posedge     :	VitalDelayType := -1 ps;
      tsetup_SD_C_posedge_posedge    :	VitalDelayType := 1 ps;
      tsetup_SD_C_negedge_posedge    :	VitalDelayType := 1 ps;
      thold_SE_C_posedge_posedge     :	VitalDelayType := -1 ps;
      thold_SE_C_negedge_posedge     :	VitalDelayType := -1 ps;
      tsetup_SE_C_posedge_posedge    :	VitalDelayType := 1 ps;
      tsetup_SE_C_negedge_posedge    :	VitalDelayType := 1 ps;
      trecovery_SN_C_posedge_posedge :	VitalDelayType := 0 ps;
      thold_SN_C_posedge_posedge     :	VitalDelayType := 0 ps;
      tpw_C_posedge                  :	VitalDelayType := 1 ps;
      tpw_C_negedge                  :	VitalDelayType := 1 ps;
      tpw_SN_negedge                 :	VitalDelayType := 1 ps;
      tipd_C                         :	VitalDelayType01 := (0 ps, 0 ps);
      tipd_D                         :	VitalDelayType01 := (0 ps, 0 ps);
      tipd_E                         :	VitalDelayType01 := (0 ps, 0 ps);
      tipd_SD                        :	VitalDelayType01 := (0 ps, 0 ps);
      tipd_SE                        :	VitalDelayType01 := (0 ps, 0 ps);
      tipd_SN                        :	VitalDelayType01 := (0 ps, 0 ps));

-- synopsys translate_on
   port(
      C                              :	in    STD_ULOGIC;
      D                              :	in    STD_ULOGIC;
      E                              :	in    STD_ULOGIC;
      Q                              :	out   STD_ULOGIC;
      QN                             :	out   STD_ULOGIC;
      SD                             :	in    STD_ULOGIC;
      SE                             :	in    STD_ULOGIC;
      SN                             :	in    STD_ULOGIC);
end component;


----- Component DFSEP3 -----
component DFSEP3_3B
-- synopsys translate_off
   generic(
      TimingChecksOn: Boolean := DefaultTimingChecksOn;
      InstancePath: STRING := "*";
      Xon: Boolean := DefaultXon;
      MsgOn: Boolean := DefaultMsgOn;
      tpd_SN_Q                       :	VitalDelayType01 := (1 ps, 0 ps);
      tpd_C_Q                        :	VitalDelayType01 := (1 ps, 1 ps);
      tpd_SN_QN                      :	VitalDelayType01 := (0 ps, 1 ps);
      tpd_C_QN                       :	VitalDelayType01 := (1 ps, 1 ps);
      thold_D_C_posedge_posedge      :	VitalDelayType := -1 ps;
      thold_D_C_negedge_posedge      :	VitalDelayType := -1 ps;
      tsetup_D_C_posedge_posedge     :	VitalDelayType := 0 ps;
      tsetup_D_C_negedge_posedge     :	VitalDelayType := 1 ps;
      thold_E_C_posedge_posedge      :	VitalDelayType := 0 ps;
      thold_E_C_negedge_posedge      :	VitalDelayType := 1 ps;
      tsetup_E_C_posedge_posedge     :	VitalDelayType := -1 ps;
      tsetup_E_C_negedge_posedge     :	VitalDelayType := 1 ps;
      thold_SD_C_posedge_posedge     :	VitalDelayType := -1 ps;
      thold_SD_C_negedge_posedge     :	VitalDelayType := 0 ps;
      tsetup_SD_C_posedge_posedge    :	VitalDelayType := 1 ps;
      tsetup_SD_C_negedge_posedge    :	VitalDelayType := 1 ps;
      thold_SE_C_posedge_posedge     :	VitalDelayType := -1 ps;
      thold_SE_C_negedge_posedge     :	VitalDelayType := -1 ps;
      tsetup_SE_C_posedge_posedge    :	VitalDelayType := 1 ps;
      tsetup_SE_C_negedge_posedge    :	VitalDelayType := 1 ps;
      trecovery_SN_C_posedge_posedge :	VitalDelayType := 0 ps;
      thold_SN_C_posedge_posedge     :	VitalDelayType := 0 ps;
      tpw_C_posedge                  :	VitalDelayType := 1 ps;
      tpw_C_negedge                  :	VitalDelayType := 1 ps;
      tpw_SN_negedge                 :	VitalDelayType := 1 ps;
      tipd_C                         :	VitalDelayType01 := (0 ps, 0 ps);
      tipd_D                         :	VitalDelayType01 := (0 ps, 0 ps);
      tipd_E                         :	VitalDelayType01 := (0 ps, 0 ps);
      tipd_SD                        :	VitalDelayType01 := (0 ps, 0 ps);
      tipd_SE                        :	VitalDelayType01 := (0 ps, 0 ps);
      tipd_SN                        :	VitalDelayType01 := (0 ps, 0 ps));

-- synopsys translate_on
   port(
      C                              :	in    STD_ULOGIC;
      D                              :	in    STD_ULOGIC;
      E                              :	in    STD_ULOGIC;
      Q                              :	out   STD_ULOGIC;
      QN                             :	out   STD_ULOGIC;
      SD                             :	in    STD_ULOGIC;
      SE                             :	in    STD_ULOGIC;
      SN                             :	in    STD_ULOGIC);
end component;


----- Component DFSP1 -----
component DFSP1_3B
-- synopsys translate_off
   generic(
      TimingChecksOn: Boolean := DefaultTimingChecksOn;
      InstancePath: STRING := "*";
      Xon: Boolean := DefaultXon;
      MsgOn: Boolean := DefaultMsgOn;
      tpd_SN_Q                       :	VitalDelayType01 := (1 ps, 0 ps);
      tpd_C_Q                        :	VitalDelayType01 := (1 ps, 1 ps);
      tpd_SN_QN                      :	VitalDelayType01 := (0 ps, 1 ps);
      tpd_C_QN                       :	VitalDelayType01 := (1 ps, 1 ps);
      thold_D_C_posedge_posedge      :	VitalDelayType := -1 ps;
      thold_D_C_negedge_posedge      :	VitalDelayType := -1 ps;
      tsetup_D_C_posedge_posedge     :	VitalDelayType := 1 ps;
      tsetup_D_C_negedge_posedge     :	VitalDelayType := 1 ps;
      thold_SD_C_posedge_posedge     :	VitalDelayType := -1 ps;
      thold_SD_C_negedge_posedge     :	VitalDelayType := -1 ps;
      tsetup_SD_C_posedge_posedge    :	VitalDelayType := 1 ps;
      tsetup_SD_C_negedge_posedge    :	VitalDelayType := 1 ps;
      thold_SE_C_posedge_posedge     :	VitalDelayType := 0 ps;
      thold_SE_C_negedge_posedge     :	VitalDelayType := -1 ps;
      tsetup_SE_C_posedge_posedge    :	VitalDelayType := 1 ps;
      tsetup_SE_C_negedge_posedge    :	VitalDelayType := 1 ps;
      trecovery_SN_C_posedge_posedge :	VitalDelayType := 0 ps;
      thold_SN_C_posedge_posedge     :	VitalDelayType := 0 ps;
      tpw_C_posedge                  :	VitalDelayType := 1 ps;
      tpw_C_negedge                  :	VitalDelayType := 1 ps;
      tpw_SN_negedge                 :	VitalDelayType := 1 ps;
      tipd_C                         :	VitalDelayType01 := (0 ps, 0 ps);
      tipd_D                         :	VitalDelayType01 := (0 ps, 0 ps);
      tipd_SD                        :	VitalDelayType01 := (0 ps, 0 ps);
      tipd_SE                        :	VitalDelayType01 := (0 ps, 0 ps);
      tipd_SN                        :	VitalDelayType01 := (0 ps, 0 ps));

-- synopsys translate_on
   port(
      C                              :	in    STD_ULOGIC;
      D                              :	in    STD_ULOGIC;
      Q                              :	out   STD_ULOGIC;
      QN                             :	out   STD_ULOGIC;
      SD                             :	in    STD_ULOGIC;
      SE                             :	in    STD_ULOGIC;
      SN                             :	in    STD_ULOGIC);
end component;


----- Component DFSP3 -----
component DFSP3_3B
-- synopsys translate_off
   generic(
      TimingChecksOn: Boolean := DefaultTimingChecksOn;
      InstancePath: STRING := "*";
      Xon: Boolean := DefaultXon;
      MsgOn: Boolean := DefaultMsgOn;
      tpd_SN_Q                       :	VitalDelayType01 := (1 ps, 0 ps);
      tpd_C_Q                        :	VitalDelayType01 := (1 ps, 1 ps);
      tpd_SN_QN                      :	VitalDelayType01 := (0 ps, 1 ps);
      tpd_C_QN                       :	VitalDelayType01 := (1 ps, 1 ps);
      thold_D_C_posedge_posedge      :	VitalDelayType := -1 ps;
      thold_D_C_negedge_posedge      :	VitalDelayType := -1 ps;
      tsetup_D_C_posedge_posedge     :	VitalDelayType := 1 ps;
      tsetup_D_C_negedge_posedge     :	VitalDelayType := 1 ps;
      thold_SD_C_posedge_posedge     :	VitalDelayType := -1 ps;
      thold_SD_C_negedge_posedge     :	VitalDelayType := 0 ps;
      tsetup_SD_C_posedge_posedge    :	VitalDelayType := 1 ps;
      tsetup_SD_C_negedge_posedge    :	VitalDelayType := 1 ps;
      thold_SE_C_posedge_posedge     :	VitalDelayType := 0 ps;
      thold_SE_C_negedge_posedge     :	VitalDelayType := -1 ps;
      tsetup_SE_C_posedge_posedge    :	VitalDelayType := 1 ps;
      tsetup_SE_C_negedge_posedge    :	VitalDelayType := 1 ps;
      trecovery_SN_C_posedge_posedge :	VitalDelayType := 0 ps;
      thold_SN_C_posedge_posedge     :	VitalDelayType := 0 ps;
      tpw_C_posedge                  :	VitalDelayType := 1 ps;
      tpw_C_negedge                  :	VitalDelayType := 1 ps;
      tpw_SN_negedge                 :	VitalDelayType := 1 ps;
      tipd_C                         :	VitalDelayType01 := (0 ps, 0 ps);
      tipd_D                         :	VitalDelayType01 := (0 ps, 0 ps);
      tipd_SD                        :	VitalDelayType01 := (0 ps, 0 ps);
      tipd_SE                        :	VitalDelayType01 := (0 ps, 0 ps);
      tipd_SN                        :	VitalDelayType01 := (0 ps, 0 ps));

-- synopsys translate_on
   port(
      C                              :	in    STD_ULOGIC;
      D                              :	in    STD_ULOGIC;
      Q                              :	out   STD_ULOGIC;
      QN                             :	out   STD_ULOGIC;
      SD                             :	in    STD_ULOGIC;
      SE                             :	in    STD_ULOGIC;
      SN                             :	in    STD_ULOGIC);
end component;


----- Component DL1 -----
component DL1_3B
-- synopsys translate_off
   generic(
      TimingChecksOn: Boolean := DefaultTimingChecksOn;
      InstancePath: STRING := "*";
      Xon: Boolean := DefaultXon;
      MsgOn: Boolean := DefaultMsgOn;
      tpd_D_Q                        :	VitalDelayType01 := (1 ps, 1 ps);
      tpd_GN_Q                       :	VitalDelayType01 := (1 ps, 1 ps);
      tpd_D_QN                       :	VitalDelayType01 := (1 ps, 1 ps);
      tpd_GN_QN                      :	VitalDelayType01 := (1 ps, 1 ps);
      thold_D_GN_posedge_posedge     :	VitalDelayType := -1 ps;
      thold_D_GN_negedge_posedge     :	VitalDelayType := -1 ps;
      tsetup_D_GN_posedge_posedge    :	VitalDelayType := 1 ps;
      tsetup_D_GN_negedge_posedge    :	VitalDelayType := 1 ps;
      tpw_GN_negedge                 :	VitalDelayType := 1 ps;
      tipd_D                         :	VitalDelayType01 := (0 ps, 0 ps);
      tipd_GN                        :	VitalDelayType01 := (0 ps, 0 ps));

-- synopsys translate_on
   port(
      D                              :	in    STD_ULOGIC;
      GN                             :	in    STD_ULOGIC;
      Q                              :	out   STD_ULOGIC;
      QN                             :	out   STD_ULOGIC);
end component;


----- Component DL3 -----
component DL3_3B
-- synopsys translate_off
   generic(
      TimingChecksOn: Boolean := DefaultTimingChecksOn;
      InstancePath: STRING := "*";
      Xon: Boolean := DefaultXon;
      MsgOn: Boolean := DefaultMsgOn;
      tpd_D_Q                        :	VitalDelayType01 := (1 ps, 1 ps);
      tpd_GN_Q                       :	VitalDelayType01 := (1 ps, 1 ps);
      tpd_D_QN                       :	VitalDelayType01 := (1 ps, 1 ps);
      tpd_GN_QN                      :	VitalDelayType01 := (1 ps, 1 ps);
      thold_D_GN_posedge_posedge     :	VitalDelayType := -1 ps;
      thold_D_GN_negedge_posedge     :	VitalDelayType := -1 ps;
      tsetup_D_GN_posedge_posedge    :	VitalDelayType := 1 ps;
      tsetup_D_GN_negedge_posedge    :	VitalDelayType := 1 ps;
      tpw_GN_negedge                 :	VitalDelayType := 1 ps;
      tipd_D                         :	VitalDelayType01 := (0 ps, 0 ps);
      tipd_GN                        :	VitalDelayType01 := (0 ps, 0 ps));

-- synopsys translate_on
   port(
      D                              :	in    STD_ULOGIC;
      GN                             :	in    STD_ULOGIC;
      Q                              :	out   STD_ULOGIC;
      QN                             :	out   STD_ULOGIC);
end component;


----- Component DLC1 -----
component DLC1_3B
-- synopsys translate_off
   generic(
      TimingChecksOn: Boolean := DefaultTimingChecksOn;
      InstancePath: STRING := "*";
      Xon: Boolean := DefaultXon;
      MsgOn: Boolean := DefaultMsgOn;
      tpd_D_Q                        :	VitalDelayType01 := (1 ps, 1 ps);
      tpd_GN_Q                       :	VitalDelayType01 := (1 ps, 1 ps);
      tpd_RN_Q                       :	VitalDelayType01 := (1 ps, 1 ps);
      tpd_D_QN                       :	VitalDelayType01 := (1 ps, 1 ps);
      tpd_GN_QN                      :	VitalDelayType01 := (1 ps, 1 ps);
      tpd_RN_QN                      :	VitalDelayType01 := (1 ps, 1 ps);
      thold_D_GN_posedge_posedge     :	VitalDelayType := -1 ps;
      thold_D_GN_negedge_posedge     :	VitalDelayType := -1 ps;
      tsetup_D_GN_posedge_posedge    :	VitalDelayType := 1 ps;
      tsetup_D_GN_negedge_posedge    :	VitalDelayType := 1 ps;
      thold_RN_GN_posedge_posedge    :	VitalDelayType := -1 ps;
      trecovery_RN_GN_posedge_posedge :	VitalDelayType := 0 ps;
      tpw_GN_negedge                 :	VitalDelayType := 1 ps;
      tpw_RN_negedge                 :	VitalDelayType := 1 ps;
      tipd_D                         :	VitalDelayType01 := (0 ps, 0 ps);
      tipd_GN                        :	VitalDelayType01 := (0 ps, 0 ps);
      tipd_RN                        :	VitalDelayType01 := (0 ps, 0 ps));

-- synopsys translate_on
   port(
      D                              :	in    STD_ULOGIC;
      GN                             :	in    STD_ULOGIC;
      Q                              :	out   STD_ULOGIC;
      QN                             :	out   STD_ULOGIC;
      RN                             :	in    STD_ULOGIC);
end component;


----- Component DLC3 -----
component DLC3_3B
-- synopsys translate_off
   generic(
      TimingChecksOn: Boolean := DefaultTimingChecksOn;
      InstancePath: STRING := "*";
      Xon: Boolean := DefaultXon;
      MsgOn: Boolean := DefaultMsgOn;
      tpd_D_Q                        :	VitalDelayType01 := (1 ps, 1 ps);
      tpd_GN_Q                       :	VitalDelayType01 := (1 ps, 1 ps);
      tpd_RN_Q                       :	VitalDelayType01 := (1 ps, 1 ps);
      tpd_D_QN                       :	VitalDelayType01 := (1 ps, 1 ps);
      tpd_GN_QN                      :	VitalDelayType01 := (1 ps, 1 ps);
      tpd_RN_QN                      :	VitalDelayType01 := (1 ps, 1 ps);
      thold_D_GN_posedge_posedge     :	VitalDelayType := -1 ps;
      thold_D_GN_negedge_posedge     :	VitalDelayType := -1 ps;
      tsetup_D_GN_posedge_posedge    :	VitalDelayType := 1 ps;
      tsetup_D_GN_negedge_posedge    :	VitalDelayType := 1 ps;
      thold_RN_GN_posedge_posedge    :	VitalDelayType := -1 ps;
      trecovery_RN_GN_posedge_posedge :	VitalDelayType := 0 ps;
      tpw_GN_negedge                 :	VitalDelayType := 1 ps;
      tpw_RN_negedge                 :	VitalDelayType := 1 ps;
      tipd_D                         :	VitalDelayType01 := (0 ps, 0 ps);
      tipd_GN                        :	VitalDelayType01 := (0 ps, 0 ps);
      tipd_RN                        :	VitalDelayType01 := (0 ps, 0 ps));

-- synopsys translate_on
   port(
      D                              :	in    STD_ULOGIC;
      GN                             :	in    STD_ULOGIC;
      Q                              :	out   STD_ULOGIC;
      QN                             :	out   STD_ULOGIC;
      RN                             :	in    STD_ULOGIC);
end component;
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
