Kevin-Pottier/SOCN/TECH/AMS/vital/c35/c35_IOLIBV5_3M_VITAL.vhd

----------------------------------------------------------------
-- 
-- Created by the Synopsys Library Compiler 2000.11
-- FILE CONTENTS:    Entity, Structural Architecture(VITAL),
--                   and Configuration
-- DATE CREATED :    Thu Jun 27 17:09:16 2002
-- 
-- LIBRARY      :    c35_IOLIBV5_4M
-- DATE ENTERED :    $Date: 2001/10/30 09:43:45 $
-- REVISION     :    $Id: csx_IOLIBV5_3M.lib,v 1.2 2001/10/30 09:43:45 mbo Exp mbo $
-- TECHNOLOGY   :    cmos
-- TIME SCALE   :    1 ps
-- LOGIC SYSTEM :    IEEE-1164
-- NOTES        :    VITAL, TimingChecksOn(TRUE), XGenerationOn(TRUE), TimingMessage(TRUE), OnEvent 
--                   Owner: austriamicrosystems AG  HIT-Kit: Digital
-- HISTORY      :
-- 
----------------------------------------------------------------

----- CELL BBC1P_V5 -----
library IEEE;
use IEEE.STD_LOGIC_1164.all;
library IEEE;
use IEEE.VITAL_Timing.all;


-- entity declaration --
entity BBC1P_V5 is
   generic(
      TimingChecksOn: Boolean := True;
      InstancePath: STRING := "*";
      Xon: Boolean := True;
      MsgOn: Boolean := True;
      tpd_A_PAD                      :	VitalDelayType01 := (1 ps, 1 ps);
      tpd_EN_PAD                     :	VitalDelayType01z := 
               (1 ps, 1 ps, 1 ps, 1 ps, 1 ps, 1 ps);
      tpd_PAD_Y                      :	VitalDelayType01 := (1 ps, 1 ps);
      tipd_A                         :	VitalDelayType01 := (0 ps, 0 ps);
      tipd_EN                        :	VitalDelayType01 := (0 ps, 0 ps);
      tipd_PAD                       :	VitalDelayType01 := (0 ps, 0 ps));

   port(
      A                              :	in    STD_ULOGIC;
      EN                             :	in    STD_ULOGIC;
      PAD                            :	inout STD_ULOGIC;
      Y                              :	out   STD_ULOGIC);
attribute VITAL_LEVEL0 of BBC1P_V5 : entity is TRUE;
end BBC1P_V5;

-- architecture body --
library IEEE;
use IEEE.VITAL_Primitives.all;
library c35_IOLIBV5_4M;
use c35_IOLIBV5_4M.VTABLES.all;
architecture VITAL of BBC1P_V5 is
   attribute VITAL_LEVEL1 of VITAL : architecture is TRUE;

   SIGNAL A_ipd	 : STD_ULOGIC := 'X';
   SIGNAL EN_ipd	 : STD_ULOGIC := 'X';
   SIGNAL PAD_ipd	 : STD_ULOGIC := 'X';

begin

   ---------------------
   --  INPUT PATH DELAYs
   ---------------------
   WireDelay : block
   begin
   VitalWireDelay (A_ipd, A, tipd_A);
   VitalWireDelay (EN_ipd, EN, tipd_EN);
   VitalWireDelay (PAD_ipd, PAD, tipd_PAD);
   end block;
   --------------------
   --  BEHAVIOR SECTION
   --------------------
   VITALBehavior : process (A_ipd, EN_ipd, PAD_ipd)


   -- functionality results
   VARIABLE Results : STD_LOGIC_VECTOR(1 to 2) := (others => 'X');
   ALIAS PAD_zd : STD_LOGIC is Results(1);
   ALIAS Y_zd : STD_LOGIC is Results(2);

   -- output glitch detection variables
   VARIABLE PAD_GlitchData	: VitalGlitchDataType;
   VARIABLE Y_GlitchData	: VitalGlitchDataType;

   begin

      -------------------------
      --  Functionality Section
      -------------------------
      PAD_zd := VitalBUFIF0 (data => A_ipd,
              enable => EN_ipd);
      Y_zd := TO_X01(PAD_ipd);

      ----------------------
      --  Path Delay Section
      ----------------------
      VitalPathDelay01Z (
       OutSignal => PAD,
       GlitchData => PAD_GlitchData,
       OutSignalName => "PAD",
       OutTemp => PAD_zd,
       Paths => (0 => (A_ipd'last_event, VitalExtendToFillDelay(tpd_A_PAD), TRUE),
                 1 => (EN_ipd'last_event, VitalExtendToFillDelay(tpd_EN_PAD), TRUE)),
       Mode => OnEvent,
       Xon => Xon,
       MsgOn => MsgOn,
       MsgSeverity => WARNING,
       OutputMap => "UX01ZWLH-");
      VitalPathDelay01 (
       OutSignal => Y,
       GlitchData => Y_GlitchData,
       OutSignalName => "Y",
       OutTemp => Y_zd,
       Paths => (0 => (PAD_ipd'last_event, tpd_PAD_Y, TRUE)),
       Mode => OnEvent,
       Xon => Xon,
       MsgOn => MsgOn,
       MsgSeverity => WARNING);

end process;

end VITAL;

configuration CFG_BBC1P_V5_VITAL of BBC1P_V5 is
   for VITAL
   end for;
end CFG_BBC1P_V5_VITAL;


----- CELL BBC4P_V5 -----
library IEEE;
use IEEE.STD_LOGIC_1164.all;
library IEEE;
use IEEE.VITAL_Timing.all;


-- entity declaration --
entity BBC4P_V5 is
   generic(
      TimingChecksOn: Boolean := True;
      InstancePath: STRING := "*";
      Xon: Boolean := True;
      MsgOn: Boolean := True;
      tpd_A_PAD                      :	VitalDelayType01 := (1 ps, 1 ps);
      tpd_EN_PAD                     :	VitalDelayType01z := 
               (1 ps, 1 ps, 1 ps, 1 ps, 1 ps, 1 ps);
      tpd_PAD_Y                      :	VitalDelayType01 := (1 ps, 1 ps);
      tipd_A                         :	VitalDelayType01 := (0 ps, 0 ps);
      tipd_EN                        :	VitalDelayType01 := (0 ps, 0 ps);
      tipd_PAD                       :	VitalDelayType01 := (0 ps, 0 ps));

   port(
      A                              :	in    STD_ULOGIC;
      EN                             :	in    STD_ULOGIC;
      PAD                            :	inout STD_ULOGIC;
      Y                              :	out   STD_ULOGIC);
attribute VITAL_LEVEL0 of BBC4P_V5 : entity is TRUE;
end BBC4P_V5;

-- architecture body --
library IEEE;
use IEEE.VITAL_Primitives.all;
library c35_IOLIBV5_4M;
use c35_IOLIBV5_4M.VTABLES.all;
architecture VITAL of BBC4P_V5 is
   attribute VITAL_LEVEL1 of VITAL : architecture is TRUE;

   SIGNAL A_ipd	 : STD_ULOGIC := 'X';
   SIGNAL EN_ipd	 : STD_ULOGIC := 'X';
   SIGNAL PAD_ipd	 : STD_ULOGIC := 'X';

begin

   ---------------------
   --  INPUT PATH DELAYs
   ---------------------
   WireDelay : block
   begin
   VitalWireDelay (A_ipd, A, tipd_A);
   VitalWireDelay (EN_ipd, EN, tipd_EN);
   VitalWireDelay (PAD_ipd, PAD, tipd_PAD);
   end block;
   --------------------
   --  BEHAVIOR SECTION
   --------------------
   VITALBehavior : process (A_ipd, EN_ipd, PAD_ipd)


   -- functionality results
   VARIABLE Results : STD_LOGIC_VECTOR(1 to 2) := (others => 'X');
   ALIAS PAD_zd : STD_LOGIC is Results(1);
   ALIAS Y_zd : STD_LOGIC is Results(2);

   -- output glitch detection variables
   VARIABLE PAD_GlitchData	: VitalGlitchDataType;
   VARIABLE Y_GlitchData	: VitalGlitchDataType;

   begin

      -------------------------
      --  Functionality Section
      -------------------------
      PAD_zd := VitalBUFIF0 (data => A_ipd,
              enable => EN_ipd);
      Y_zd := TO_X01(PAD_ipd);

      ----------------------
      --  Path Delay Section
      ----------------------
      VitalPathDelay01Z (
       OutSignal => PAD,
       GlitchData => PAD_GlitchData,
       OutSignalName => "PAD",
       OutTemp => PAD_zd,
       Paths => (0 => (A_ipd'last_event, VitalExtendToFillDelay(tpd_A_PAD), TRUE),
                 1 => (EN_ipd'last_event, VitalExtendToFillDelay(tpd_EN_PAD), TRUE)),
       Mode => OnEvent,
       Xon => Xon,
       MsgOn => MsgOn,
       MsgSeverity => WARNING,
       OutputMap => "UX01ZWLH-");
      VitalPathDelay01 (
       OutSignal => Y,
       GlitchData => Y_GlitchData,
       OutSignalName => "Y",
       OutTemp => Y_zd,
       Paths => (0 => (PAD_ipd'last_event, tpd_PAD_Y, TRUE)),
       Mode => OnEvent,
       Xon => Xon,
       MsgOn => MsgOn,
       MsgSeverity => WARNING);

end process;

end VITAL;

configuration CFG_BBC4P_V5_VITAL of BBC4P_V5 is
   for VITAL
   end for;
end CFG_BBC4P_V5_VITAL;


----- CELL BBC4SMP_V5 -----
library IEEE;
use IEEE.STD_LOGIC_1164.all;
library IEEE;
use IEEE.VITAL_Timing.all;


-- entity declaration --
entity BBC4SMP_V5 is
   generic(
      TimingChecksOn: Boolean := True;
      InstancePath: STRING := "*";
      Xon: Boolean := True;
      MsgOn: Boolean := True;
      tpd_A_PAD                      :	VitalDelayType01 := (1 ps, 1 ps);
      tpd_EN_PAD                     :	VitalDelayType01z := 
               (1 ps, 1 ps, 1 ps, 1 ps, 1 ps, 1 ps);
      tpd_PAD_Y                      :	VitalDelayType01 := (1 ps, 1 ps);
      tipd_A                         :	VitalDelayType01 := (0 ps, 0 ps);
      tipd_EN                        :	VitalDelayType01 := (0 ps, 0 ps);
      tipd_PAD                       :	VitalDelayType01 := (0 ps, 0 ps));

   port(
      A                              :	in    STD_ULOGIC;
      EN                             :	in    STD_ULOGIC;
      PAD                            :	inout STD_ULOGIC;
      Y                              :	out   STD_ULOGIC);
attribute VITAL_LEVEL0 of BBC4SMP_V5 : entity is TRUE;
end BBC4SMP_V5;

-- architecture body --
library IEEE;
use IEEE.VITAL_Primitives.all;
library c35_IOLIBV5_4M;
use c35_IOLIBV5_4M.VTABLES.all;
architecture VITAL of BBC4SMP_V5 is
   attribute VITAL_LEVEL1 of VITAL : architecture is TRUE;

   SIGNAL A_ipd	 : STD_ULOGIC := 'X';
   SIGNAL EN_ipd	 : STD_ULOGIC := 'X';
   SIGNAL PAD_ipd	 : STD_ULOGIC := 'X';

begin

   ---------------------
   --  INPUT PATH DELAYs
   ---------------------
   WireDelay : block
   begin
   VitalWireDelay (A_ipd, A, tipd_A);
   VitalWireDelay (EN_ipd, EN, tipd_EN);
   VitalWireDelay (PAD_ipd, PAD, tipd_PAD);
   end block;
   --------------------
   --  BEHAVIOR SECTION
   --------------------
   VITALBehavior : process (A_ipd, EN_ipd, PAD_ipd)


   -- functionality results
   VARIABLE Results : STD_LOGIC_VECTOR(1 to 2) := (others => 'X');
   ALIAS PAD_zd : STD_LOGIC is Results(1);
   ALIAS Y_zd : STD_LOGIC is Results(2);

   -- output glitch detection variables
   VARIABLE PAD_GlitchData	: VitalGlitchDataType;
   VARIABLE Y_GlitchData	: VitalGlitchDataType;

   begin

      -------------------------
      --  Functionality Section
      -------------------------
      PAD_zd := VitalBUFIF0 (data => A_ipd,
              enable => EN_ipd);
      Y_zd := TO_X01(PAD_ipd);

      ----------------------
      --  Path Delay Section
      ----------------------
      VitalPathDelay01Z (
       OutSignal => PAD,
       GlitchData => PAD_GlitchData,
       OutSignalName => "PAD",
       OutTemp => PAD_zd,
       Paths => (0 => (A_ipd'last_event, VitalExtendToFillDelay(tpd_A_PAD), TRUE),
                 1 => (EN_ipd'last_event, VitalExtendToFillDelay(tpd_EN_PAD), TRUE)),
       Mode => OnEvent,
       Xon => Xon,
       MsgOn => MsgOn,
       MsgSeverity => WARNING,
       OutputMap => "UX01ZWLH-");
      VitalPathDelay01 (
       OutSignal => Y,
       GlitchData => Y_GlitchData,
       OutSignalName => "Y",
       OutTemp => Y_zd,
       Paths => (0 => (PAD_ipd'last_event, tpd_PAD_Y, TRUE)),
       Mode => OnEvent,
       Xon => Xon,
       MsgOn => MsgOn,
       MsgSeverity => WARNING);

end process;

end VITAL;

configuration CFG_BBC4SMP_V5_VITAL of BBC4SMP_V5 is
   for VITAL
   end for;
end CFG_BBC4SMP_V5_VITAL;


----- CELL BBC8P_V5 -----
library IEEE;
use IEEE.STD_LOGIC_1164.all;
library IEEE;
use IEEE.VITAL_Timing.all;


-- entity declaration --
entity BBC8P_V5 is
   generic(
      TimingChecksOn: Boolean := True;
      InstancePath: STRING := "*";
      Xon: Boolean := True;
      MsgOn: Boolean := True;
      tpd_A_PAD                      :	VitalDelayType01 := (1 ps, 1 ps);
      tpd_EN_PAD                     :	VitalDelayType01z := 
               (1 ps, 1 ps, 1 ps, 1 ps, 1 ps, 1 ps);
      tpd_PAD_Y                      :	VitalDelayType01 := (1 ps, 1 ps);
      tipd_A                         :	VitalDelayType01 := (0 ps, 0 ps);
      tipd_EN                        :	VitalDelayType01 := (0 ps, 0 ps);
      tipd_PAD                       :	VitalDelayType01 := (0 ps, 0 ps));

   port(
      A                              :	in    STD_ULOGIC;
      EN                             :	in    STD_ULOGIC;
      PAD                            :	inout STD_ULOGIC;
      Y                              :	out   STD_ULOGIC);
attribute VITAL_LEVEL0 of BBC8P_V5 : entity is TRUE;
end BBC8P_V5;

-- architecture body --
library IEEE;
use IEEE.VITAL_Primitives.all;
library c35_IOLIBV5_4M;
use c35_IOLIBV5_4M.VTABLES.all;
architecture VITAL of BBC8P_V5 is
   attribute VITAL_LEVEL1 of VITAL : architecture is TRUE;

   SIGNAL A_ipd	 : STD_ULOGIC := 'X';
   SIGNAL EN_ipd	 : STD_ULOGIC := 'X';
   SIGNAL PAD_ipd	 : STD_ULOGIC := 'X';

begin

   ---------------------
   --  INPUT PATH DELAYs
   ---------------------
   WireDelay : block
   begin
   VitalWireDelay (A_ipd, A, tipd_A);
   VitalWireDelay (EN_ipd, EN, tipd_EN);
   VitalWireDelay (PAD_ipd, PAD, tipd_PAD);
   end block;
   --------------------
   --  BEHAVIOR SECTION
   --------------------
   VITALBehavior : process (A_ipd, EN_ipd, PAD_ipd)


   -- functionality results
   VARIABLE Results : STD_LOGIC_VECTOR(1 to 2) := (others => 'X');
   ALIAS PAD_zd : STD_LOGIC is Results(1);
   ALIAS Y_zd : STD_LOGIC is Results(2);

   -- output glitch detection variables
   VARIABLE PAD_GlitchData	: VitalGlitchDataType;
   VARIABLE Y_GlitchData	: VitalGlitchDataType;

   begin

      -------------------------
      --  Functionality Section
      -------------------------
      PAD_zd := VitalBUFIF0 (data => A_ipd,
              enable => EN_ipd);
      Y_zd := TO_X01(PAD_ipd);

      ----------------------
      --  Path Delay Section
      ----------------------
      VitalPathDelay01Z (
       OutSignal => PAD,
       GlitchData => PAD_GlitchData,
       OutSignalName => "PAD",
       OutTemp => PAD_zd,
       Paths => (0 => (A_ipd'last_event, VitalExtendToFillDelay(tpd_A_PAD), TRUE),
                 1 => (EN_ipd'last_event, VitalExtendToFillDelay(tpd_EN_PAD), TRUE)),
       Mode => OnEvent,
       Xon => Xon,
       MsgOn => MsgOn,
       MsgSeverity => WARNING,
       OutputMap => "UX01ZWLH-");
      VitalPathDelay01 (
       OutSignal => Y,
       GlitchData => Y_GlitchData,
       OutSignalName => "Y",
       OutTemp => Y_zd,
       Paths => (0 => (PAD_ipd'last_event, tpd_PAD_Y, TRUE)),
       Mode => OnEvent,
       Xon => Xon,
       MsgOn => MsgOn,
       MsgSeverity => WARNING);

end process;

end VITAL;

configuration CFG_BBC8P_V5_VITAL of BBC8P_V5 is
   for VITAL
   end for;
end CFG_BBC8P_V5_VITAL;


----- CELL BBC8SMP_V5 -----
library IEEE;
use IEEE.STD_LOGIC_1164.all;
library IEEE;
use IEEE.VITAL_Timing.all;


-- entity declaration --
entity BBC8SMP_V5 is
   generic(
      TimingChecksOn: Boolean := True;
      InstancePath: STRING := "*";
      Xon: Boolean := True;
      MsgOn: Boolean := True;
      tpd_A_PAD                      :	VitalDelayType01 := (1 ps, 1 ps);
      tpd_EN_PAD                     :	VitalDelayType01z := 
               (1 ps, 1 ps, 1 ps, 1 ps, 1 ps, 1 ps);
      tpd_PAD_Y                      :	VitalDelayType01 := (1 ps, 1 ps);
      tipd_A                         :	VitalDelayType01 := (0 ps, 0 ps);
      tipd_EN                        :	VitalDelayType01 := (0 ps, 0 ps);
      tipd_PAD                       :	VitalDelayType01 := (0 ps, 0 ps));

   port(
      A                              :	in    STD_ULOGIC;
      EN                             :	in    STD_ULOGIC;
      PAD                            :	inout STD_ULOGIC;
      Y                              :	out   STD_ULOGIC);
attribute VITAL_LEVEL0 of BBC8SMP_V5 : entity is TRUE;
end BBC8SMP_V5;

-- architecture body --
library IEEE;
use IEEE.VITAL_Primitives.all;
library c35_IOLIBV5_4M;
use c35_IOLIBV5_4M.VTABLES.all;
architecture VITAL of BBC8SMP_V5 is
   attribute VITAL_LEVEL1 of VITAL : architecture is TRUE;

   SIGNAL A_ipd	 : STD_ULOGIC := 'X';
   SIGNAL EN_ipd	 : STD_ULOGIC := 'X';
   SIGNAL PAD_ipd	 : STD_ULOGIC := 'X';

begin

   ---------------------
   --  INPUT PATH DELAYs
   ---------------------
   WireDelay : block
   begin
   VitalWireDelay (A_ipd, A, tipd_A);
   VitalWireDelay (EN_ipd, EN, tipd_EN);
   VitalWireDelay (PAD_ipd, PAD, tipd_PAD);
   end block;
   --------------------
   --  BEHAVIOR SECTION
   --------------------
   VITALBehavior : process (A_ipd, EN_ipd, PAD_ipd)


   -- functionality results
   VARIABLE Results : STD_LOGIC_VECTOR(1 to 2) := (others => 'X');
   ALIAS PAD_zd : STD_LOGIC is Results(1);
   ALIAS Y_zd : STD_LOGIC is Results(2);

   -- output glitch detection variables
   VARIABLE PAD_GlitchData	: VitalGlitchDataType;
   VARIABLE Y_GlitchData	: VitalGlitchDataType;

   begin

      -------------------------
      --  Functionality Section
      -------------------------
      PAD_zd := VitalBUFIF0 (data => A_ipd,
              enable => EN_ipd);
      Y_zd := TO_X01(PAD_ipd);

      ----------------------
      --  Path Delay Section
      ----------------------
      VitalPathDelay01Z (
       OutSignal => PAD,
       GlitchData => PAD_GlitchData,
       OutSignalName => "PAD",
       OutTemp => PAD_zd,
       Paths => (0 => (A_ipd'last_event, VitalExtendToFillDelay(tpd_A_PAD), TRUE),
                 1 => (EN_ipd'last_event, VitalExtendToFillDelay(tpd_EN_PAD), TRUE)),
       Mode => OnEvent,
       Xon => Xon,
       MsgOn => MsgOn,
       MsgSeverity => WARNING,
       OutputMap => "UX01ZWLH-");
      VitalPathDelay01 (
       OutSignal => Y,
       GlitchData => Y_GlitchData,
       OutSignalName => "Y",
       OutTemp => Y_zd,
       Paths => (0 => (PAD_ipd'last_event, tpd_PAD_Y, TRUE)),
       Mode => OnEvent,
       Xon => Xon,
       MsgOn => MsgOn,
       MsgSeverity => WARNING);

end process;

end VITAL;

configuration CFG_BBC8SMP_V5_VITAL of BBC8SMP_V5 is
   for VITAL
   end for;
end CFG_BBC8SMP_V5_VITAL;


----- CELL BBC8SP_V5 -----
library IEEE;
use IEEE.STD_LOGIC_1164.all;
library IEEE;
use IEEE.VITAL_Timing.all;


-- entity declaration --
entity BBC8SP_V5 is
   generic(
      TimingChecksOn: Boolean := True;
      InstancePath: STRING := "*";
      Xon: Boolean := True;
      MsgOn: Boolean := True;
      tpd_A_PAD                      :	VitalDelayType01 := (1 ps, 1 ps);
      tpd_EN_PAD                     :	VitalDelayType01z := 
               (1 ps, 1 ps, 1 ps, 1 ps, 1 ps, 1 ps);
      tpd_PAD_Y                      :	VitalDelayType01 := (1 ps, 1 ps);
      tipd_A                         :	VitalDelayType01 := (0 ps, 0 ps);
      tipd_EN                        :	VitalDelayType01 := (0 ps, 0 ps);
      tipd_PAD                       :	VitalDelayType01 := (0 ps, 0 ps));

   port(
      A                              :	in    STD_ULOGIC;
      EN                             :	in    STD_ULOGIC;
      PAD                            :	inout STD_ULOGIC;
      Y                              :	out   STD_ULOGIC);
attribute VITAL_LEVEL0 of BBC8SP_V5 : entity is TRUE;
end BBC8SP_V5;

-- architecture body --
library IEEE;
use IEEE.VITAL_Primitives.all;
library c35_IOLIBV5_4M;
use c35_IOLIBV5_4M.VTABLES.all;
architecture VITAL of BBC8SP_V5 is
   attribute VITAL_LEVEL1 of VITAL : architecture is TRUE;

   SIGNAL A_ipd	 : STD_ULOGIC := 'X';
   SIGNAL EN_ipd	 : STD_ULOGIC := 'X';
   SIGNAL PAD_ipd	 : STD_ULOGIC := 'X';

begin

   ---------------------
   --  INPUT PATH DELAYs
   ---------------------
   WireDelay : block
   begin
   VitalWireDelay (A_ipd, A, tipd_A);
   VitalWireDelay (EN_ipd, EN, tipd_EN);
   VitalWireDelay (PAD_ipd, PAD, tipd_PAD);
   end block;
   --------------------
   --  BEHAVIOR SECTION
   --------------------
   VITALBehavior : process (A_ipd, EN_ipd, PAD_ipd)


   -- functionality results
   VARIABLE Results : STD_LOGIC_VECTOR(1 to 2) := (others => 'X');
   ALIAS PAD_zd : STD_LOGIC is Results(1);
   ALIAS Y_zd : STD_LOGIC is Results(2);

   -- output glitch detection variables
   VARIABLE PAD_GlitchData	: VitalGlitchDataType;
   VARIABLE Y_GlitchData	: VitalGlitchDataType;

   begin

      -------------------------
      --  Functionality Section
      -------------------------
      PAD_zd := VitalBUFIF0 (data => A_ipd,
              enable => EN_ipd);
      Y_zd := TO_X01(PAD_ipd);

      ----------------------
      --  Path Delay Section
      ----------------------
      VitalPathDelay01Z (
       OutSignal => PAD,
       GlitchData => PAD_GlitchData,
       OutSignalName => "PAD",
       OutTemp => PAD_zd,
       Paths => (0 => (A_ipd'last_event, VitalExtendToFillDelay(tpd_A_PAD), TRUE),
                 1 => (EN_ipd'last_event, VitalExtendToFillDelay(tpd_EN_PAD), TRUE)),
       Mode => OnEvent,
       Xon => Xon,
       MsgOn => MsgOn,
       MsgSeverity => WARNING,
       OutputMap => "UX01ZWLH-");
      VitalPathDelay01 (
       OutSignal => Y,
       GlitchData => Y_GlitchData,
       OutSignalName => "Y",
       OutTemp => Y_zd,
       Paths => (0 => (PAD_ipd'last_event, tpd_PAD_Y, TRUE)),
       Mode => OnEvent,
       Xon => Xon,
       MsgOn => MsgOn,
       MsgSeverity => WARNING);

end process;

end VITAL;

configuration CFG_BBC8SP_V5_VITAL of BBC8SP_V5 is
   for VITAL
   end for;
end CFG_BBC8SP_V5_VITAL;


----- CELL BBC16P_V5 -----
library IEEE;
use IEEE.STD_LOGIC_1164.all;
library IEEE;
use IEEE.VITAL_Timing.all;


-- entity declaration --
entity BBC16P_V5 is
   generic(
      TimingChecksOn: Boolean := True;
      InstancePath: STRING := "*";
      Xon: Boolean := True;
      MsgOn: Boolean := True;
      tpd_A_PAD                      :	VitalDelayType01 := (1 ps, 1 ps);
      tpd_EN_PAD                     :	VitalDelayType01z := 
               (1 ps, 1 ps, 1 ps, 1 ps, 1 ps, 1 ps);
      tpd_PAD_Y                      :	VitalDelayType01 := (1 ps, 1 ps);
      tipd_A                         :	VitalDelayType01 := (0 ps, 0 ps);
      tipd_EN                        :	VitalDelayType01 := (0 ps, 0 ps);
      tipd_PAD                       :	VitalDelayType01 := (0 ps, 0 ps));

   port(
      A                              :	in    STD_ULOGIC;
      EN                             :	in    STD_ULOGIC;
      PAD                            :	inout STD_ULOGIC;
      Y                              :	out   STD_ULOGIC);
attribute VITAL_LEVEL0 of BBC16P_V5 : entity is TRUE;
end BBC16P_V5;

-- architecture body --
library IEEE;
use IEEE.VITAL_Primitives.all;
library c35_IOLIBV5_4M;
use c35_IOLIBV5_4M.VTABLES.all;
architecture VITAL of BBC16P_V5 is
   attribute VITAL_LEVEL1 of VITAL : architecture is TRUE;

   SIGNAL A_ipd	 : STD_ULOGIC := 'X';
   SIGNAL EN_ipd	 : STD_ULOGIC := 'X';
   SIGNAL PAD_ipd	 : STD_ULOGIC := 'X';

begin

   ---------------------
   --  INPUT PATH DELAYs
   ---------------------
   WireDelay : block
   begin
   VitalWireDelay (A_ipd, A, tipd_A);
   VitalWireDelay (EN_ipd, EN, tipd_EN);
   VitalWireDelay (PAD_ipd, PAD, tipd_PAD);
   end block;
   --------------------
   --  BEHAVIOR SECTION
   --------------------
   VITALBehavior : process (A_ipd, EN_ipd, PAD_ipd)


   -- functionality results
   VARIABLE Results : STD_LOGIC_VECTOR(1 to 2) := (others => 'X');
   ALIAS PAD_zd : STD_LOGIC is Results(1);
   ALIAS Y_zd : STD_LOGIC is Results(2);

   -- output glitch detection variables
   VARIABLE PAD_GlitchData	: VitalGlitchDataType;
   VARIABLE Y_GlitchData	: VitalGlitchDataType;

   begin

      -------------------------
      --  Functionality Section
      -------------------------
      PAD_zd := VitalBUFIF0 (data => A_ipd,
              enable => EN_ipd);
      Y_zd := TO_X01(PAD_ipd);

      ----------------------
      --  Path Delay Section
      ----------------------
      VitalPathDelay01Z (
       OutSignal => PAD,
       GlitchData => PAD_GlitchData,
       OutSignalName => "PAD",
       OutTemp => PAD_zd,
       Paths => (0 => (A_ipd'last_event, VitalExtendToFillDelay(tpd_A_PAD), TRUE),
                 1 => (EN_ipd'last_event, VitalExtendToFillDelay(tpd_EN_PAD), TRUE)),
       Mode => OnEvent,
       Xon => Xon,
       MsgOn => MsgOn,
       MsgSeverity => WARNING,
       OutputMap => "UX01ZWLH-");
      VitalPathDelay01 (
       OutSignal => Y,
       GlitchData => Y_GlitchData,
       OutSignalName => "Y",
       OutTemp => Y_zd,
       Paths => (0 => (PAD_ipd'last_event, tpd_PAD_Y, TRUE)),
       Mode => OnEvent,
       Xon => Xon,
       MsgOn => MsgOn,
       MsgSeverity => WARNING);

end process;

end VITAL;

configuration CFG_BBC16P_V5_VITAL of BBC16P_V5 is
   for VITAL
   end for;
end CFG_BBC16P_V5_VITAL;


----- CELL BBC16SMP_V5 -----
library IEEE;
use IEEE.STD_LOGIC_1164.all;
library IEEE;
use IEEE.VITAL_Timing.all;


-- entity declaration --
entity BBC16SMP_V5 is
   generic(
      TimingChecksOn: Boolean := True;
      InstancePath: STRING := "*";
      Xon: Boolean := True;
      MsgOn: Boolean := True;
      tpd_A_PAD                      :	VitalDelayType01 := (1 ps, 1 ps);
      tpd_EN_PAD                     :	VitalDelayType01z := 
               (1 ps, 1 ps, 1 ps, 1 ps, 1 ps, 1 ps);
      tpd_PAD_Y                      :	VitalDelayType01 := (1 ps, 1 ps);
      tipd_A                         :	VitalDelayType01 := (0 ps, 0 ps);
      tipd_EN                        :	VitalDelayType01 := (0 ps, 0 ps);
      tipd_PAD                       :	VitalDelayType01 := (0 ps, 0 ps));

   port(
      A                              :	in    STD_ULOGIC;
      EN                             :	in    STD_ULOGIC;
      PAD                            :	inout STD_ULOGIC;
      Y                              :	out   STD_ULOGIC);
attribute VITAL_LEVEL0 of BBC16SMP_V5 : entity is TRUE;
end BBC16SMP_V5;

-- architecture body --
library IEEE;
use IEEE.VITAL_Primitives.all;
library c35_IOLIBV5_4M;
use c35_IOLIBV5_4M.VTABLES.all;
architecture VITAL of BBC16SMP_V5 is
   attribute VITAL_LEVEL1 of VITAL : architecture is TRUE;

   SIGNAL A_ipd	 : STD_ULOGIC := 'X';
   SIGNAL EN_ipd	 : STD_ULOGIC := 'X';
   SIGNAL PAD_ipd	 : STD_ULOGIC := 'X';

begin

   ---------------------
   --  INPUT PATH DELAYs
   ---------------------
   WireDelay : block
   begin
   VitalWireDelay (A_ipd, A, tipd_A);
   VitalWireDelay (EN_ipd, EN, tipd_EN);
   VitalWireDelay (PAD_ipd, PAD, tipd_PAD);
   end block;
   --------------------
   --  BEHAVIOR SECTION
   --------------------
   VITALBehavior : process (A_ipd, EN_ipd, PAD_ipd)


   -- functionality results
   VARIABLE Results : STD_LOGIC_VECTOR(1 to 2) := (others => 'X');
   ALIAS PAD_zd : STD_LOGIC is Results(1);
   ALIAS Y_zd : STD_LOGIC is Results(2);

   -- output glitch detection variables
   VARIABLE PAD_GlitchData	: VitalGlitchDataType;
   VARIABLE Y_GlitchData	: VitalGlitchDataType;

   begin

      -------------------------
      --  Functionality Section
      -------------------------
      PAD_zd := VitalBUFIF0 (data => A_ipd,
              enable => EN_ipd);
      Y_zd := TO_X01(PAD_ipd);

      ----------------------
      --  Path Delay Section
      ----------------------
      VitalPathDelay01Z (
       OutSignal => PAD,
       GlitchData => PAD_GlitchData,
       OutSignalName => "PAD",
       OutTemp => PAD_zd,
       Paths => (0 => (A_ipd'last_event, VitalExtendToFillDelay(tpd_A_PAD), TRUE),
                 1 => (EN_ipd'last_event, VitalExtendToFillDelay(tpd_EN_PAD), TRUE)),
       Mode => OnEvent,
       Xon => Xon,
       MsgOn => MsgOn,
       MsgSeverity => WARNING,
       OutputMap => "UX01ZWLH-");
      VitalPathDelay01 (
       OutSignal => Y,
       GlitchData => Y_GlitchData,
       OutSignalName => "Y",
       OutTemp => Y_zd,
       Paths => (0 => (PAD_ipd'last_event, tpd_PAD_Y, TRUE)),
       Mode => OnEvent,
       Xon => Xon,
       MsgOn => MsgOn,
       MsgSeverity => WARNING);

end process;

end VITAL;

configuration CFG_BBC16SMP_V5_VITAL of BBC16SMP_V5 is
   for VITAL
   end for;
end CFG_BBC16SMP_V5_VITAL;


----- CELL BBC16SP_V5 -----
library IEEE;
use IEEE.STD_LOGIC_1164.all;
library IEEE;
use IEEE.VITAL_Timing.all;


-- entity declaration --
entity BBC16SP_V5 is
   generic(
      TimingChecksOn: Boolean := True;
      InstancePath: STRING := "*";
      Xon: Boolean := True;
      MsgOn: Boolean := True;
      tpd_A_PAD                      :	VitalDelayType01 := (1 ps, 1 ps);
      tpd_EN_PAD                     :	VitalDelayType01z := 
               (1 ps, 1 ps, 1 ps, 1 ps, 1 ps, 1 ps);
      tpd_PAD_Y                      :	VitalDelayType01 := (1 ps, 1 ps);
      tipd_A                         :	VitalDelayType01 := (0 ps, 0 ps);
      tipd_EN                        :	VitalDelayType01 := (0 ps, 0 ps);
      tipd_PAD                       :	VitalDelayType01 := (0 ps, 0 ps));

   port(
      A                              :	in    STD_ULOGIC;
      EN                             :	in    STD_ULOGIC;
      PAD                            :	inout STD_ULOGIC;
      Y                              :	out   STD_ULOGIC);
attribute VITAL_LEVEL0 of BBC16SP_V5 : entity is TRUE;
end BBC16SP_V5;

-- architecture body --
library IEEE;
use IEEE.VITAL_Primitives.all;
library c35_IOLIBV5_4M;
use c35_IOLIBV5_4M.VTABLES.all;
architecture VITAL of BBC16SP_V5 is
   attribute VITAL_LEVEL1 of VITAL : architecture is TRUE;

   SIGNAL A_ipd	 : STD_ULOGIC := 'X';
   SIGNAL EN_ipd	 : STD_ULOGIC := 'X';
   SIGNAL PAD_ipd	 : STD_ULOGIC := 'X';

begin

   ---------------------
   --  INPUT PATH DELAYs
   ---------------------
   WireDelay : block
   begin
   VitalWireDelay (A_ipd, A, tipd_A);
   VitalWireDelay (EN_ipd, EN, tipd_EN);
   VitalWireDelay (PAD_ipd, PAD, tipd_PAD);
   end block;
   --------------------
   --  BEHAVIOR SECTION
   --------------------
   VITALBehavior : process (A_ipd, EN_ipd, PAD_ipd)


   -- functionality results
   VARIABLE Results : STD_LOGIC_VECTOR(1 to 2) := (others => 'X');
   ALIAS PAD_zd : STD_LOGIC is Results(1);
   ALIAS Y_zd : STD_LOGIC is Results(2);

   -- output glitch detection variables
   VARIABLE PAD_GlitchData	: VitalGlitchDataType;
   VARIABLE Y_GlitchData	: VitalGlitchDataType;

   begin

      -------------------------
      --  Functionality Section
      -------------------------
      PAD_zd := VitalBUFIF0 (data => A_ipd,
              enable => EN_ipd);
      Y_zd := TO_X01(PAD_ipd);

      ----------------------
      --  Path Delay Section
      ----------------------
      VitalPathDelay01Z (
       OutSignal => PAD,
       GlitchData => PAD_GlitchData,
       OutSignalName => "PAD",
       OutTemp => PAD_zd,
       Paths => (0 => (A_ipd'last_event, VitalExtendToFillDelay(tpd_A_PAD), TRUE),
                 1 => (EN_ipd'last_event, VitalExtendToFillDelay(tpd_EN_PAD), TRUE)),
       Mode => OnEvent,
       Xon => Xon,
       MsgOn => MsgOn,
       MsgSeverity => WARNING,
       OutputMap => "UX01ZWLH-");
      VitalPathDelay01 (
       OutSignal => Y,
       GlitchData => Y_GlitchData,
       OutSignalName => "Y",
       OutTemp => Y_zd,
       Paths => (0 => (PAD_ipd'last_event, tpd_PAD_Y, TRUE)),
       Mode => OnEvent,
       Xon => Xon,
       MsgOn => MsgOn,
       MsgSeverity => WARNING);

end process;

end VITAL;

configuration CFG_BBC16SP_V5_VITAL of BBC16SP_V5 is
   for VITAL
   end for;
end CFG_BBC16SP_V5_VITAL;


----- CELL BBC24P_V5 -----
library IEEE;
use IEEE.STD_LOGIC_1164.all;
library IEEE;
use IEEE.VITAL_Timing.all;


-- entity declaration --
entity BBC24P_V5 is
   generic(
      TimingChecksOn: Boolean := True;
      InstancePath: STRING := "*";
      Xon: Boolean := True;
      MsgOn: Boolean := True;
      tpd_A_PAD                      :	VitalDelayType01 := (1 ps, 1 ps);
      tpd_EN_PAD                     :	VitalDelayType01z := 
               (1 ps, 1 ps, 1 ps, 1 ps, 1 ps, 1 ps);
      tpd_PAD_Y                      :	VitalDelayType01 := (1 ps, 1 ps);
      tipd_A                         :	VitalDelayType01 := (0 ps, 0 ps);
      tipd_EN                        :	VitalDelayType01 := (0 ps, 0 ps);
      tipd_PAD                       :	VitalDelayType01 := (0 ps, 0 ps));

   port(
      A                              :	in    STD_ULOGIC;
      EN                             :	in    STD_ULOGIC;
      PAD                            :	inout STD_ULOGIC;
      Y                              :	out   STD_ULOGIC);
attribute VITAL_LEVEL0 of BBC24P_V5 : entity is TRUE;
end BBC24P_V5;

-- architecture body --
library IEEE;
use IEEE.VITAL_Primitives.all;
library c35_IOLIBV5_4M;
use c35_IOLIBV5_4M.VTABLES.all;
architecture VITAL of BBC24P_V5 is
   attribute VITAL_LEVEL1 of VITAL : architecture is TRUE;

   SIGNAL A_ipd	 : STD_ULOGIC := 'X';
   SIGNAL EN_ipd	 : STD_ULOGIC := 'X';
   SIGNAL PAD_ipd	 : STD_ULOGIC := 'X';

begin

   ---------------------
   --  INPUT PATH DELAYs
   ---------------------
   WireDelay : block
   begin
   VitalWireDelay (A_ipd, A, tipd_A);
   VitalWireDelay (EN_ipd, EN, tipd_EN);
   VitalWireDelay (PAD_ipd, PAD, tipd_PAD);
   end block;
   --------------------
   --  BEHAVIOR SECTION
   --------------------
   VITALBehavior : process (A_ipd, EN_ipd, PAD_ipd)


   -- functionality results
   VARIABLE Results : STD_LOGIC_VECTOR(1 to 2) := (others => 'X');
   ALIAS PAD_zd : STD_LOGIC is Results(1);
   ALIAS Y_zd : STD_LOGIC is Results(2);

   -- output glitch detection variables
   VARIABLE PAD_GlitchData	: VitalGlitchDataType;
   VARIABLE Y_GlitchData	: VitalGlitchDataType;

   begin

      -------------------------
      --  Functionality Section
      -------------------------
      PAD_zd := VitalBUFIF0 (data => A_ipd,
              enable => EN_ipd);
      Y_zd := TO_X01(PAD_ipd);

      ----------------------
      --  Path Delay Section
      ----------------------
      VitalPathDelay01Z (
       OutSignal => PAD,
       GlitchData => PAD_GlitchData,
       OutSignalName => "PAD",
       OutTemp => PAD_zd,
       Paths => (0 => (A_ipd'last_event, VitalExtendToFillDelay(tpd_A_PAD), TRUE),
                 1 => (EN_ipd'last_event, VitalExtendToFillDelay(tpd_EN_PAD), TRUE)),
       Mode => OnEvent,
       Xon => Xon,
       MsgOn => MsgOn,
       MsgSeverity => WARNING,
       OutputMap => "UX01ZWLH-");
      VitalPathDelay01 (
       OutSignal => Y,
       GlitchData => Y_GlitchData,
       OutSignalName => "Y",
       OutTemp => Y_zd,
       Paths => (0 => (PAD_ipd'last_event, tpd_PAD_Y, TRUE)),
       Mode => OnEvent,
       Xon => Xon,
       MsgOn => MsgOn,
       MsgSeverity => WARNING);

end process;

end VITAL;

configuration CFG_BBC24P_V5_VITAL of BBC24P_V5 is
   for VITAL
   end for;
end CFG_BBC24P_V5_VITAL;


----- CELL BBC24SMP_V5 -----
library IEEE;
use IEEE.STD_LOGIC_1164.all;
library IEEE;
use IEEE.VITAL_Timing.all;


-- entity declaration --
entity BBC24SMP_V5 is
   generic(
      TimingChecksOn: Boolean := True;
      InstancePath: STRING := "*";
      Xon: Boolean := True;
      MsgOn: Boolean := True;
      tpd_A_PAD                      :	VitalDelayType01 := (1 ps, 1 ps);
      tpd_EN_PAD                     :	VitalDelayType01z := 
               (1 ps, 1 ps, 1 ps, 1 ps, 1 ps, 1 ps);
      tpd_PAD_Y                      :	VitalDelayType01 := (1 ps, 1 ps);
      tipd_A                         :	VitalDelayType01 := (0 ps, 0 ps);
      tipd_EN                        :	VitalDelayType01 := (0 ps, 0 ps);
      tipd_PAD                       :	VitalDelayType01 := (0 ps, 0 ps));

   port(
      A                              :	in    STD_ULOGIC;
      EN                             :	in    STD_ULOGIC;
      PAD                            :	inout STD_ULOGIC;
      Y                              :	out   STD_ULOGIC);
attribute VITAL_LEVEL0 of BBC24SMP_V5 : entity is TRUE;
end BBC24SMP_V5;

-- architecture body --
library IEEE;
use IEEE.VITAL_Primitives.all;
library c35_IOLIBV5_4M;
use c35_IOLIBV5_4M.VTABLES.all;
architecture VITAL of BBC24SMP_V5 is
   attribute VITAL_LEVEL1 of VITAL : architecture is TRUE;

   SIGNAL A_ipd	 : STD_ULOGIC := 'X';
   SIGNAL EN_ipd	 : STD_ULOGIC := 'X';
   SIGNAL PAD_ipd	 : STD_ULOGIC := 'X';

begin

   ---------------------
   --  INPUT PATH DELAYs
   ---------------------
   WireDelay : block
   begin
   VitalWireDelay (A_ipd, A, tipd_A);
   VitalWireDelay (EN_ipd, EN, tipd_EN);
   VitalWireDelay (PAD_ipd, PAD, tipd_PAD);
   end block;
   --------------------
   --  BEHAVIOR SECTION
   --------------------
   VITALBehavior : process (A_ipd, EN_ipd, PAD_ipd)


   -- functionality results
   VARIABLE Results : STD_LOGIC_VECTOR(1 to 2) := (others => 'X');
   ALIAS PAD_zd : STD_LOGIC is Results(1);
   ALIAS Y_zd : STD_LOGIC is Results(2);

   -- output glitch detection variables
   VARIABLE PAD_GlitchData	: VitalGlitchDataType;
   VARIABLE Y_GlitchData	: VitalGlitchDataType;

   begin

      -------------------------
      --  Functionality Section
      -------------------------
      PAD_zd := VitalBUFIF0 (data => A_ipd,
              enable => EN_ipd);
      Y_zd := TO_X01(PAD_ipd);

      ----------------------
      --  Path Delay Section
      ----------------------
      VitalPathDelay01Z (
       OutSignal => PAD,
       GlitchData => PAD_GlitchData,
       OutSignalName => "PAD",
       OutTemp => PAD_zd,
       Paths => (0 => (A_ipd'last_event, VitalExtendToFillDelay(tpd_A_PAD), TRUE),
                 1 => (EN_ipd'last_event, VitalExtendToFillDelay(tpd_EN_PAD), TRUE)),
       Mode => OnEvent,
       Xon => Xon,
       MsgOn => MsgOn,
       MsgSeverity => WARNING,
       OutputMap => "UX01ZWLH-");
      VitalPathDelay01 (
       OutSignal => Y,
       GlitchData => Y_GlitchData,
       OutSignalName => "Y",
       OutTemp => Y_zd,
       Paths => (0 => (PAD_ipd'last_event, tpd_PAD_Y, TRUE)),
       Mode => OnEvent,
       Xon => Xon,
       MsgOn => MsgOn,
       MsgSeverity => WARNING);

end process;

end VITAL;

configuration CFG_BBC24SMP_V5_VITAL of BBC24SMP_V5 is
   for VITAL
   end for;
end CFG_BBC24SMP_V5_VITAL;


----- CELL BBC24SP_V5 -----
library IEEE;
use IEEE.STD_LOGIC_1164.all;
library IEEE;
use IEEE.VITAL_Timing.all;


-- entity declaration --
entity BBC24SP_V5 is
   generic(
      TimingChecksOn: Boolean := True;
      InstancePath: STRING := "*";
      Xon: Boolean := True;
      MsgOn: Boolean := True;
      tpd_A_PAD                      :	VitalDelayType01 := (1 ps, 1 ps);
      tpd_EN_PAD                     :	VitalDelayType01z := 
               (1 ps, 1 ps, 1 ps, 1 ps, 1 ps, 1 ps);
      tpd_PAD_Y                      :	VitalDelayType01 := (1 ps, 1 ps);
      tipd_A                         :	VitalDelayType01 := (0 ps, 0 ps);
      tipd_EN                        :	VitalDelayType01 := (0 ps, 0 ps);
      tipd_PAD                       :	VitalDelayType01 := (0 ps, 0 ps));

   port(
      A                              :	in    STD_ULOGIC;
      EN                             :	in    STD_ULOGIC;
      PAD                            :	inout STD_ULOGIC;
      Y                              :	out   STD_ULOGIC);
attribute VITAL_LEVEL0 of BBC24SP_V5 : entity is TRUE;
end BBC24SP_V5;

-- architecture body --
library IEEE;
use IEEE.VITAL_Primitives.all;
library c35_IOLIBV5_4M;
use c35_IOLIBV5_4M.VTABLES.all;
architecture VITAL of BBC24SP_V5 is
   attribute VITAL_LEVEL1 of VITAL : architecture is TRUE;

   SIGNAL A_ipd	 : STD_ULOGIC := 'X';
   SIGNAL EN_ipd	 : STD_ULOGIC := 'X';
   SIGNAL PAD_ipd	 : STD_ULOGIC := 'X';

begin

   ---------------------
   --  INPUT PATH DELAYs
   ---------------------
   WireDelay : block
   begin
   VitalWireDelay (A_ipd, A, tipd_A);
   VitalWireDelay (EN_ipd, EN, tipd_EN);
   VitalWireDelay (PAD_ipd, PAD, tipd_PAD);
   end block;
   --------------------
   --  BEHAVIOR SECTION
   --------------------
   VITALBehavior : process (A_ipd, EN_ipd, PAD_ipd)


   -- functionality results
   VARIABLE Results : STD_LOGIC_VECTOR(1 to 2) := (others => 'X');
   ALIAS PAD_zd : STD_LOGIC is Results(1);
   ALIAS Y_zd : STD_LOGIC is Results(2);

   -- output glitch detection variables
   VARIABLE PAD_GlitchData	: VitalGlitchDataType;
   VARIABLE Y_GlitchData	: VitalGlitchDataType;

   begin

      -------------------------
      --  Functionality Section
      -------------------------
      PAD_zd := VitalBUFIF0 (data => A_ipd,
              enable => EN_ipd);
      Y_zd := TO_X01(PAD_ipd);

      ----------------------
      --  Path Delay Section
      ----------------------
      VitalPathDelay01Z (
       OutSignal => PAD,
       GlitchData => PAD_GlitchData,
       OutSignalName => "PAD",
       OutTemp => PAD_zd,
       Paths => (0 => (A_ipd'last_event, VitalExtendToFillDelay(tpd_A_PAD), TRUE),
                 1 => (EN_ipd'last_event, VitalExtendToFillDelay(tpd_EN_PAD), TRUE)),
       Mode => OnEvent,
       Xon => Xon,
       MsgOn => MsgOn,
       MsgSeverity => WARNING,
       OutputMap => "UX01ZWLH-");
      VitalPathDelay01 (
       OutSignal => Y,
       GlitchData => Y_GlitchData,
       OutSignalName => "Y",
       OutTemp => Y_zd,
       Paths => (0 => (PAD_ipd'last_event, tpd_PAD_Y, TRUE)),
       Mode => OnEvent,
       Xon => Xon,
       MsgOn => MsgOn,
       MsgSeverity => WARNING);

end process;

end VITAL;

configuration CFG_BBC24SP_V5_VITAL of BBC24SP_V5 is
   for VITAL
   end for;
end CFG_BBC24SP_V5_VITAL;


----- CELL BBCD1P_V5 -----
library IEEE;
use IEEE.STD_LOGIC_1164.all;
library IEEE;
use IEEE.VITAL_Timing.all;


-- entity declaration --
entity BBCD1P_V5 is
   generic(
      TimingChecksOn: Boolean := True;
      InstancePath: STRING := "*";
      Xon: Boolean := True;
      MsgOn: Boolean := True;
      tpd_A_PAD                      :	VitalDelayType01 := (1 ps, 1 ps);
      tpd_EN_PAD                     :	VitalDelayType01z := 
               (1 ps, 1 ps, 1 ps, 1 ps, 1 ps, 1 ps);
      tpd_PAD_Y                      :	VitalDelayType01 := (1 ps, 1 ps);
      tipd_A                         :	VitalDelayType01 := (0 ps, 0 ps);
      tipd_EN                        :	VitalDelayType01 := (0 ps, 0 ps);
      tipd_PAD                       :	VitalDelayType01 := (0 ps, 0 ps));

   port(
      A                              :	in    STD_ULOGIC;
      EN                             :	in    STD_ULOGIC;
      PAD                            :	inout STD_ULOGIC;
      Y                              :	out   STD_ULOGIC);
attribute VITAL_LEVEL0 of BBCD1P_V5 : entity is TRUE;
end BBCD1P_V5;

-- architecture body --
library IEEE;
use IEEE.VITAL_Primitives.all;
library c35_IOLIBV5_4M;
use c35_IOLIBV5_4M.VTABLES.all;
architecture VITAL of BBCD1P_V5 is
   attribute VITAL_LEVEL1 of VITAL : architecture is TRUE;

   SIGNAL A_ipd	 : STD_ULOGIC := 'X';
   SIGNAL EN_ipd	 : STD_ULOGIC := 'X';
   SIGNAL PAD_ipd	 : STD_ULOGIC := 'X';

begin

   ---------------------
   --  INPUT PATH DELAYs
   ---------------------
   WireDelay : block
   begin
   VitalWireDelay (A_ipd, A, tipd_A);
   VitalWireDelay (EN_ipd, EN, tipd_EN);
   VitalWireDelay (PAD_ipd, PAD, tipd_PAD);
   end block;
   --------------------
   --  BEHAVIOR SECTION
   --------------------
   VITALBehavior : process (A_ipd, EN_ipd, PAD_ipd)


   -- functionality results
   VARIABLE Results : STD_LOGIC_VECTOR(1 to 2) := (others => 'X');
   ALIAS PAD_zd : STD_LOGIC is Results(1);
   ALIAS Y_zd : STD_LOGIC is Results(2);

   -- output glitch detection variables
   VARIABLE PAD_GlitchData	: VitalGlitchDataType;
   VARIABLE Y_GlitchData	: VitalGlitchDataType;

   begin

      -------------------------
      --  Functionality Section
      -------------------------
      PAD_zd := VitalBUFIF0 (data => A_ipd,
              enable => EN_ipd);
      Y_zd := TO_X01(PAD_ipd);

      ----------------------
      --  Path Delay Section
      ----------------------
      VitalPathDelay01Z (
       OutSignal => PAD,
       GlitchData => PAD_GlitchData,
       OutSignalName => "PAD",
       OutTemp => PAD_zd,
       Paths => (0 => (A_ipd'last_event, VitalExtendToFillDelay(tpd_A_PAD), TRUE),
                 1 => (EN_ipd'last_event, VitalExtendToFillDelay(tpd_EN_PAD), TRUE)),
       Mode => OnEvent,
       Xon => Xon,
       MsgOn => MsgOn,
       MsgSeverity => WARNING,
       OutputMap => "UX01ZWLH-");
      VitalPathDelay01 (
       OutSignal => Y,
       GlitchData => Y_GlitchData,
       OutSignalName => "Y",
       OutTemp => Y_zd,
       Paths => (0 => (PAD_ipd'last_event, tpd_PAD_Y, TRUE)),
       Mode => OnEvent,
       Xon => Xon,
       MsgOn => MsgOn,
       MsgSeverity => WARNING);

end process;

end VITAL;

configuration CFG_BBCD1P_V5_VITAL of BBCD1P_V5 is
   for VITAL
   end for;
end CFG_BBCD1P_V5_VITAL;


----- CELL BBCD4P_V5 -----
library IEEE;
use IEEE.STD_LOGIC_1164.all;
library IEEE;
use IEEE.VITAL_Timing.all;


-- entity declaration --
entity BBCD4P_V5 is
   generic(
      TimingChecksOn: Boolean := True;
      InstancePath: STRING := "*";
      Xon: Boolean := True;
      MsgOn: Boolean := True;
      tpd_A_PAD                      :	VitalDelayType01 := (1 ps, 1 ps);
      tpd_EN_PAD                     :	VitalDelayType01z := 
               (1 ps, 1 ps, 1 ps, 1 ps, 1 ps, 1 ps);
      tpd_PAD_Y                      :	VitalDelayType01 := (1 ps, 1 ps);
      tipd_A                         :	VitalDelayType01 := (0 ps, 0 ps);
      tipd_EN                        :	VitalDelayType01 := (0 ps, 0 ps);
      tipd_PAD                       :	VitalDelayType01 := (0 ps, 0 ps));

   port(
      A                              :	in    STD_ULOGIC;
      EN                             :	in    STD_ULOGIC;
      PAD                            :	inout STD_ULOGIC;
      Y                              :	out   STD_ULOGIC);
attribute VITAL_LEVEL0 of BBCD4P_V5 : entity is TRUE;
end BBCD4P_V5;

-- architecture body --
library IEEE;
use IEEE.VITAL_Primitives.all;
library c35_IOLIBV5_4M;
use c35_IOLIBV5_4M.VTABLES.all;
architecture VITAL of BBCD4P_V5 is
   attribute VITAL_LEVEL1 of VITAL : architecture is TRUE;

   SIGNAL A_ipd	 : STD_ULOGIC := 'X';
   SIGNAL EN_ipd	 : STD_ULOGIC := 'X';
   SIGNAL PAD_ipd	 : STD_ULOGIC := 'X';

begin

   ---------------------
   --  INPUT PATH DELAYs
   ---------------------
   WireDelay : block
   begin
   VitalWireDelay (A_ipd, A, tipd_A);
   VitalWireDelay (EN_ipd, EN, tipd_EN);
   VitalWireDelay (PAD_ipd, PAD, tipd_PAD);
   end block;
   --------------------
   --  BEHAVIOR SECTION
   --------------------
   VITALBehavior : process (A_ipd, EN_ipd, PAD_ipd)


   -- functionality results
   VARIABLE Results : STD_LOGIC_VECTOR(1 to 2) := (others => 'X');
   ALIAS PAD_zd : STD_LOGIC is Results(1);
   ALIAS Y_zd : STD_LOGIC is Results(2);

   -- output glitch detection variables
   VARIABLE PAD_GlitchData	: VitalGlitchDataType;
   VARIABLE Y_GlitchData	: VitalGlitchDataType;

   begin

      -------------------------
      --  Functionality Section
      -------------------------
      PAD_zd := VitalBUFIF0 (data => A_ipd,
              enable => EN_ipd);
      Y_zd := TO_X01(PAD_ipd);

      ----------------------
      --  Path Delay Section
      ----------------------
      VitalPathDelay01Z (
       OutSignal => PAD,
       GlitchData => PAD_GlitchData,
       OutSignalName => "PAD",
       OutTemp => PAD_zd,
       Paths => (0 => (A_ipd'last_event, VitalExtendToFillDelay(tpd_A_PAD), TRUE),
                 1 => (EN_ipd'last_event, VitalExtendToFillDelay(tpd_EN_PAD), TRUE)),
       Mode => OnEvent,
       Xon => Xon,
       MsgOn => MsgOn,
       MsgSeverity => WARNING,
       OutputMap => "UX01ZWLH-");
      VitalPathDelay01 (
       OutSignal => Y,
       GlitchData => Y_GlitchData,
       OutSignalName => "Y",
       OutTemp => Y_zd,
       Paths => (0 => (PAD_ipd'last_event, tpd_PAD_Y, TRUE)),
       Mode => OnEvent,
       Xon => Xon,
       MsgOn => MsgOn,
       MsgSeverity => WARNING);

end process;

end VITAL;

configuration CFG_BBCD4P_V5_VITAL of BBCD4P_V5 is
   for VITAL
   end for;
end CFG_BBCD4P_V5_VITAL;


----- CELL BBCD4SMP_V5 -----
library IEEE;
use IEEE.STD_LOGIC_1164.all;
library IEEE;
use IEEE.VITAL_Timing.all;


-- entity declaration --
entity BBCD4SMP_V5 is
   generic(
      TimingChecksOn: Boolean := True;
      InstancePath: STRING := "*";
      Xon: Boolean := True;
      MsgOn: Boolean := True;
      tpd_A_PAD                      :	VitalDelayType01 := (1 ps, 1 ps);
      tpd_EN_PAD                     :	VitalDelayType01z := 
               (1 ps, 1 ps, 1 ps, 1 ps, 1 ps, 1 ps);
      tpd_PAD_Y                      :	VitalDelayType01 := (1 ps, 1 ps);
      tipd_A                         :	VitalDelayType01 := (0 ps, 0 ps);
      tipd_EN                        :	VitalDelayType01 := (0 ps, 0 ps);
      tipd_PAD                       :	VitalDelayType01 := (0 ps, 0 ps));

   port(
      A                              :	in    STD_ULOGIC;
      EN                             :	in    STD_ULOGIC;
      PAD                            :	inout STD_ULOGIC;
      Y                              :	out   STD_ULOGIC);
attribute VITAL_LEVEL0 of BBCD4SMP_V5 : entity is TRUE;
end BBCD4SMP_V5;

-- architecture body --
library IEEE;
use IEEE.VITAL_Primitives.all;
library c35_IOLIBV5_4M;
use c35_IOLIBV5_4M.VTABLES.all;
architecture VITAL of BBCD4SMP_V5 is
   attribute VITAL_LEVEL1 of VITAL : architecture is TRUE;

   SIGNAL A_ipd	 : STD_ULOGIC := 'X';
   SIGNAL EN_ipd	 : STD_ULOGIC := 'X';
   SIGNAL PAD_ipd	 : STD_ULOGIC := 'X';

begin

   ---------------------
   --  INPUT PATH DELAYs
   ---------------------
   WireDelay : block
   begin
   VitalWireDelay (A_ipd, A, tipd_A);
   VitalWireDelay (EN_ipd, EN, tipd_EN);
   VitalWireDelay (PAD_ipd, PAD, tipd_PAD);
   end block;
   --------------------
   --  BEHAVIOR SECTION
   --------------------
   VITALBehavior : process (A_ipd, EN_ipd, PAD_ipd)


   -- functionality results
   VARIABLE Results : STD_LOGIC_VECTOR(1 to 2) := (others => 'X');
   ALIAS PAD_zd : STD_LOGIC is Results(1);
   ALIAS Y_zd : STD_LOGIC is Results(2);

   -- output glitch detection variables
   VARIABLE PAD_GlitchData	: VitalGlitchDataType;
   VARIABLE Y_GlitchData	: VitalGlitchDataType;

   begin

      -------------------------
      --  Functionality Section
      -------------------------
      PAD_zd := VitalBUFIF0 (data => A_ipd,
              enable => EN_ipd);
      Y_zd := TO_X01(PAD_ipd);

      ----------------------
      --  Path Delay Section
      ----------------------
      VitalPathDelay01Z (
       OutSignal => PAD,
       GlitchData => PAD_GlitchData,
       OutSignalName => "PAD",
       OutTemp => PAD_zd,
       Paths => (0 => (A_ipd'last_event, VitalExtendToFillDelay(tpd_A_PAD), TRUE),
                 1 => (EN_ipd'last_event, VitalExtendToFillDelay(tpd_EN_PAD), TRUE)),
       Mode => OnEvent,
       Xon => Xon,
       MsgOn => MsgOn,
       MsgSeverity => WARNING,
       OutputMap => "UX01ZWLH-");
      VitalPathDelay01 (
       OutSignal => Y,
       GlitchData => Y_GlitchData,
       OutSignalName => "Y",
       OutTemp => Y_zd,
       Paths => (0 => (PAD_ipd'last_event, tpd_PAD_Y, TRUE)),
       Mode => OnEvent,
       Xon => Xon,
       MsgOn => MsgOn,
       MsgSeverity => WARNING);

end process;

end VITAL;

configuration CFG_BBCD4SMP_V5_VITAL of BBCD4SMP_V5 is
   for VITAL
   end for;
end CFG_BBCD4SMP_V5_VITAL;


----- CELL BBCD8P_V5 -----
library IEEE;
use IEEE.STD_LOGIC_1164.all;
library IEEE;
use IEEE.VITAL_Timing.all;


-- entity declaration --
entity BBCD8P_V5 is
   generic(
      TimingChecksOn: Boolean := True;
      InstancePath: STRING := "*";
      Xon: Boolean := True;
      MsgOn: Boolean := True;
      tpd_A_PAD                      :	VitalDelayType01 := (1 ps, 1 ps);
      tpd_EN_PAD                     :	VitalDelayType01z := 
               (1 ps, 1 ps, 1 ps, 1 ps, 1 ps, 1 ps);
      tpd_PAD_Y                      :	VitalDelayType01 := (1 ps, 1 ps);
      tipd_A                         :	VitalDelayType01 := (0 ps, 0 ps);
      tipd_EN                        :	VitalDelayType01 := (0 ps, 0 ps);
      tipd_PAD                       :	VitalDelayType01 := (0 ps, 0 ps));

   port(
      A                              :	in    STD_ULOGIC;
      EN                             :	in    STD_ULOGIC;
      PAD                            :	inout STD_ULOGIC;
      Y                              :	out   STD_ULOGIC);
attribute VITAL_LEVEL0 of BBCD8P_V5 : entity is TRUE;
end BBCD8P_V5;

-- architecture body --
library IEEE;
use IEEE.VITAL_Primitives.all;
library c35_IOLIBV5_4M;
use c35_IOLIBV5_4M.VTABLES.all;
architecture VITAL of BBCD8P_V5 is
   attribute VITAL_LEVEL1 of VITAL : architecture is TRUE;

   SIGNAL A_ipd	 : STD_ULOGIC := 'X';
   SIGNAL EN_ipd	 : STD_ULOGIC := 'X';
   SIGNAL PAD_ipd	 : STD_ULOGIC := 'X';

begin

   ---------------------
   --  INPUT PATH DELAYs
   ---------------------
   WireDelay : block
   begin
   VitalWireDelay (A_ipd, A, tipd_A);
   VitalWireDelay (EN_ipd, EN, tipd_EN);
   VitalWireDelay (PAD_ipd, PAD, tipd_PAD);
   end block;
   --------------------
   --  BEHAVIOR SECTION
   --------------------
   VITALBehavior : process (A_ipd, EN_ipd, PAD_ipd)


   -- functionality results
   VARIABLE Results : STD_LOGIC_VECTOR(1 to 2) := (others => 'X');
   ALIAS PAD_zd : STD_LOGIC is Results(1);
   ALIAS Y_zd : STD_LOGIC is Results(2);

   -- output glitch detection variables
   VARIABLE PAD_GlitchData	: VitalGlitchDataType;
   VARIABLE Y_GlitchData	: VitalGlitchDataType;

   begin

      -------------------------
      --  Functionality Section
      -------------------------
      PAD_zd := VitalBUFIF0 (data => A_ipd,
              enable => EN_ipd);
      Y_zd := TO_X01(PAD_ipd);

      ----------------------
      --  Path Delay Section
      ----------------------
      VitalPathDelay01Z (
       OutSignal => PAD,
       GlitchData => PAD_GlitchData,
       OutSignalName => "PAD",
       OutTemp => PAD_zd,
       Paths => (0 => (A_ipd'last_event, VitalExtendToFillDelay(tpd_A_PAD), TRUE),
                 1 => (EN_ipd'last_event, VitalExtendToFillDelay(tpd_EN_PAD), TRUE)),
       Mode => OnEvent,
       Xon => Xon,
       MsgOn => MsgOn,
       MsgSeverity => WARNING,
       OutputMap => "UX01ZWLH-");
      VitalPathDelay01 (
       OutSignal => Y,
       GlitchData => Y_GlitchData,
       OutSignalName => "Y",
       OutTemp => Y_zd,
       Paths => (0 => (PAD_ipd'last_event, tpd_PAD_Y, TRUE)),
       Mode => OnEvent,
       Xon => Xon,
       MsgOn => MsgOn,
       MsgSeverity => WARNING);

end process;

end VITAL;

configuration CFG_BBCD8P_V5_VITAL of BBCD8P_V5 is
   for VITAL
   end for;
end CFG_BBCD8P_V5_VITAL;


----- CELL BBCD8SMP_V5 -----
library IEEE;
use IEEE.STD_LOGIC_1164.all;
library IEEE;
use IEEE.VITAL_Timing.all;


-- entity declaration --
entity BBCD8SMP_V5 is
   generic(
      TimingChecksOn: Boolean := True;
      InstancePath: STRING := "*";
      Xon: Boolean := True;
      MsgOn: Boolean := True;
      tpd_A_PAD                      :	VitalDelayType01 := (1 ps, 1 ps);
      tpd_EN_PAD                     :	VitalDelayType01z := 
               (1 ps, 1 ps, 1 ps, 1 ps, 1 ps, 1 ps);
      tpd_PAD_Y                      :	VitalDelayType01 := (1 ps, 1 ps);
      tipd_A                         :	VitalDelayType01 := (0 ps, 0 ps);
      tipd_EN                        :	VitalDelayType01 := (0 ps, 0 ps);
      tipd_PAD                       :	VitalDelayType01 := (0 ps, 0 ps));

   port(
      A                              :	in    STD_ULOGIC;
      EN                             :	in    STD_ULOGIC;
      PAD                            :	inout STD_ULOGIC;
      Y                              :	out   STD_ULOGIC);
attribute VITAL_LEVEL0 of BBCD8SMP_V5 : entity is TRUE;
end BBCD8SMP_V5;

-- architecture body --
library IEEE;
use IEEE.VITAL_Primitives.all;
library c35_IOLIBV5_4M;
use c35_IOLIBV5_4M.VTABLES.all;
architecture VITAL of BBCD8SMP_V5 is
   attribute VITAL_LEVEL1 of VITAL : architecture is TRUE;

   SIGNAL A_ipd	 : STD_ULOGIC := 'X';
   SIGNAL EN_ipd	 : STD_ULOGIC := 'X';
   SIGNAL PAD_ipd	 : STD_ULOGIC := 'X';

begin

   ---------------------
   --  INPUT PATH DELAYs
   ---------------------
   WireDelay : block
   begin
   VitalWireDelay (A_ipd, A, tipd_A);
   VitalWireDelay (EN_ipd, EN, tipd_EN);
   VitalWireDelay (PAD_ipd, PAD, tipd_PAD);
   end block;
   --------------------
   --  BEHAVIOR SECTION
   --------------------
   VITALBehavior : process (A_ipd, EN_ipd, PAD_ipd)


   -- functionality results
   VARIABLE Results : STD_LOGIC_VECTOR(1 to 2) := (others => 'X');
   ALIAS PAD_zd : STD_LOGIC is Results(1);
   ALIAS Y_zd : STD_LOGIC is Results(2);

   -- output glitch detection variables
   VARIABLE PAD_GlitchData	: VitalGlitchDataType;
   VARIABLE Y_GlitchData	: VitalGlitchDataType;

   begin

      -------------------------
      --  Functionality Section
      -------------------------
      PAD_zd := VitalBUFIF0 (data => A_ipd,
              enable => EN_ipd);
      Y_zd := TO_X01(PAD_ipd);

      ----------------------
      --  Path Delay Section
      ----------------------
      VitalPathDelay01Z (
       OutSignal => PAD,
       GlitchData => PAD_GlitchData,
       OutSignalName => "PAD",
       OutTemp => PAD_zd,
       Paths => (0 => (A_ipd'last_event, VitalExtendToFillDelay(tpd_A_PAD), TRUE),
                 1 => (EN_ipd'last_event, VitalExtendToFillDelay(tpd_EN_PAD), TRUE)),
       Mode => OnEvent,
       Xon => Xon,
       MsgOn => MsgOn,
       MsgSeverity => WARNING,
       OutputMap => "UX01ZWLH-");
      VitalPathDelay01 (
       OutSignal => Y,
       GlitchData => Y_GlitchData,
       OutSignalName => "Y",
       OutTemp => Y_zd,
       Paths => (0 => (PAD_ipd'last_event, tpd_PAD_Y, TRUE)),
       Mode => OnEvent,
       Xon => Xon,
       MsgOn => MsgOn,
       MsgSeverity => WARNING);

end process;

end VITAL;

configuration CFG_BBCD8SMP_V5_VITAL of BBCD8SMP_V5 is
   for VITAL
   end for;
end CFG_BBCD8SMP_V5_VITAL;


----- CELL BBCD8SP_V5 -----
library IEEE;
use IEEE.STD_LOGIC_1164.all;
library IEEE;
use IEEE.VITAL_Timing.all;


-- entity declaration --
entity BBCD8SP_V5 is
   generic(
      TimingChecksOn: Boolean := True;
      InstancePath: STRING := "*";
      Xon: Boolean := True;
      MsgOn: Boolean := True;
      tpd_A_PAD                      :	VitalDelayType01 := (1 ps, 1 ps);
      tpd_EN_PAD                     :	VitalDelayType01z := 
               (1 ps, 1 ps, 1 ps, 1 ps, 1 ps, 1 ps);
      tpd_PAD_Y                      :	VitalDelayType01 := (1 ps, 1 ps);
      tipd_A                         :	VitalDelayType01 := (0 ps, 0 ps);
      tipd_EN                        :	VitalDelayType01 := (0 ps, 0 ps);
      tipd_PAD                       :	VitalDelayType01 := (0 ps, 0 ps));

   port(
      A                              :	in    STD_ULOGIC;
      EN                             :	in    STD_ULOGIC;
      PAD                            :	inout STD_ULOGIC;
      Y                              :	out   STD_ULOGIC);
attribute VITAL_LEVEL0 of BBCD8SP_V5 : entity is TRUE;
end BBCD8SP_V5;

-- architecture body --
library IEEE;
use IEEE.VITAL_Primitives.all;
library c35_IOLIBV5_4M;
use c35_IOLIBV5_4M.VTABLES.all;
architecture VITAL of BBCD8SP_V5 is
   attribute VITAL_LEVEL1 of VITAL : architecture is TRUE;

   SIGNAL A_ipd	 : STD_ULOGIC := 'X';
   SIGNAL EN_ipd	 : STD_ULOGIC := 'X';
   SIGNAL PAD_ipd	 : STD_ULOGIC := 'X';

begin

   ---------------------
   --  INPUT PATH DELAYs
   ---------------------
   WireDelay : block
   begin
   VitalWireDelay (A_ipd, A, tipd_A);
   VitalWireDelay (EN_ipd, EN, tipd_EN);
   VitalWireDelay (PAD_ipd, PAD, tipd_PAD);
   end block;
   --------------------
   --  BEHAVIOR SECTION
   --------------------
   VITALBehavior : process (A_ipd, EN_ipd, PAD_ipd)


   -- functionality results
   VARIABLE Results : STD_LOGIC_VECTOR(1 to 2) := (others => 'X');
   ALIAS PAD_zd : STD_LOGIC is Results(1);
   ALIAS Y_zd : STD_LOGIC is Results(2);

   -- output glitch detection variables
   VARIABLE PAD_GlitchData	: VitalGlitchDataType;
   VARIABLE Y_GlitchData	: VitalGlitchDataType;

   begin

      -------------------------
      --  Functionality Section
      -------------------------
      PAD_zd := VitalBUFIF0 (data => A_ipd,
              enable => EN_ipd);
      Y_zd := TO_X01(PAD_ipd);

      ----------------------
      --  Path Delay Section
      ----------------------
      VitalPathDelay01Z (
       OutSignal => PAD,
       GlitchData => PAD_GlitchData,
       OutSignalName => "PAD",
       OutTemp => PAD_zd,
       Paths => (0 => (A_ipd'last_event, VitalExtendToFillDelay(tpd_A_PAD), TRUE),
                 1 => (EN_ipd'last_event, VitalExtendToFillDelay(tpd_EN_PAD), TRUE)),
       Mode => OnEvent,
       Xon => Xon,
       MsgOn => MsgOn,
       MsgSeverity => WARNING,
       OutputMap => "UX01ZWLH-");
      VitalPathDelay01 (
       OutSignal => Y,
       GlitchData => Y_GlitchData,
       OutSignalName => "Y",
       OutTemp => Y_zd,
       Paths => (0 => (PAD_ipd'last_event, tpd_PAD_Y, TRUE)),
       Mode => OnEvent,
       Xon => Xon,
       MsgOn => MsgOn,
       MsgSeverity => WARNING);

end process;

end VITAL;

configuration CFG_BBCD8SP_V5_VITAL of BBCD8SP_V5 is
   for VITAL
   end for;
end CFG_BBCD8SP_V5_VITAL;


----- CELL BBCD16P_V5 -----
library IEEE;
use IEEE.STD_LOGIC_1164.all;
library IEEE;
use IEEE.VITAL_Timing.all;


-- entity declaration --
entity BBCD16P_V5 is
   generic(
      TimingChecksOn: Boolean := True;
      InstancePath: STRING := "*";
      Xon: Boolean := True;
      MsgOn: Boolean := True;
      tpd_A_PAD                      :	VitalDelayType01 := (1 ps, 1 ps);
      tpd_EN_PAD                     :	VitalDelayType01z := 
               (1 ps, 1 ps, 1 ps, 1 ps, 1 ps, 1 ps);
      tpd_PAD_Y                      :	VitalDelayType01 := (1 ps, 1 ps);
      tipd_A                         :	VitalDelayType01 := (0 ps, 0 ps);
      tipd_EN                        :	VitalDelayType01 := (0 ps, 0 ps);
      tipd_PAD                       :	VitalDelayType01 := (0 ps, 0 ps));

   port(
      A                              :	in    STD_ULOGIC;
      EN                             :	in    STD_ULOGIC;
      PAD                            :	inout STD_ULOGIC;
      Y                              :	out   STD_ULOGIC);
attribute VITAL_LEVEL0 of BBCD16P_V5 : entity is TRUE;
end BBCD16P_V5;

-- architecture body --
library IEEE;
use IEEE.VITAL_Primitives.all;
library c35_IOLIBV5_4M;
use c35_IOLIBV5_4M.VTABLES.all;
architecture VITAL of BBCD16P_V5 is
   attribute VITAL_LEVEL1 of VITAL : architecture is TRUE;

   SIGNAL A_ipd	 : STD_ULOGIC := 'X';
   SIGNAL EN_ipd	 : STD_ULOGIC := 'X';
   SIGNAL PAD_ipd	 : STD_ULOGIC := 'X';

begin

   ---------------------
   --  INPUT PATH DELAYs
   ---------------------
   WireDelay : block
   begin
   VitalWireDelay (A_ipd, A, tipd_A);
   VitalWireDelay (EN_ipd, EN, tipd_EN);
   VitalWireDelay (PAD_ipd, PAD, tipd_PAD);
   end block;
   --------------------
   --  BEHAVIOR SECTION
   --------------------
   VITALBehavior : process (A_ipd, EN_ipd, PAD_ipd)


   -- functionality results
   VARIABLE Results : STD_LOGIC_VECTOR(1 to 2) := (others => 'X');
   ALIAS PAD_zd : STD_LOGIC is Results(1);
   ALIAS Y_zd : STD_LOGIC is Results(2);

   -- output glitch detection variables
   VARIABLE PAD_GlitchData	: VitalGlitchDataType;
   VARIABLE Y_GlitchData	: VitalGlitchDataType;

   begin

      -------------------------
      --  Functionality Section
      -------------------------
      PAD_zd := VitalBUFIF0 (data => A_ipd,
              enable => EN_ipd);
      Y_zd := TO_X01(PAD_ipd);

      ----------------------
      --  Path Delay Section
      ----------------------
      VitalPathDelay01Z (
       OutSignal => PAD,
       GlitchData => PAD_GlitchData,
       OutSignalName => "PAD",
       OutTemp => PAD_zd,
       Paths => (0 => (A_ipd'last_event, VitalExtendToFillDelay(tpd_A_PAD), TRUE),
                 1 => (EN_ipd'last_event, VitalExtendToFillDelay(tpd_EN_PAD), TRUE)),
       Mode => OnEvent,
       Xon => Xon,
       MsgOn => MsgOn,
       MsgSeverity => WARNING,
       OutputMap => "UX01ZWLH-");
      VitalPathDelay01 (
       OutSignal => Y,
       GlitchData => Y_GlitchData,
       OutSignalName => "Y",
       OutTemp => Y_zd,
       Paths => (0 => (PAD_ipd'last_event, tpd_PAD_Y, TRUE)),
       Mode => OnEvent,
       Xon => Xon,
       MsgOn => MsgOn,
       MsgSeverity => WARNING);

end process;

end VITAL;

configuration CFG_BBCD16P_V5_VITAL of BBCD16P_V5 is
   for VITAL
   end for;
end CFG_BBCD16P_V5_VITAL;


----- CELL BBCD16SMP_V5 -----
library IEEE;
use IEEE.STD_LOGIC_1164.all;
library IEEE;
use IEEE.VITAL_Timing.all;


-- entity declaration --
entity BBCD16SMP_V5 is
   generic(
      TimingChecksOn: Boolean := True;
      InstancePath: STRING := "*";
      Xon: Boolean := True;
      MsgOn: Boolean := True;
      tpd_A_PAD                      :	VitalDelayType01 := (1 ps, 1 ps);
      tpd_EN_PAD                     :	VitalDelayType01z := 
               (1 ps, 1 ps, 1 ps, 1 ps, 1 ps, 1 ps);
      tpd_PAD_Y                      :	VitalDelayType01 := (1 ps, 1 ps);
      tipd_A                         :	VitalDelayType01 := (0 ps, 0 ps);
      tipd_EN                        :	VitalDelayType01 := (0 ps, 0 ps);
      tipd_PAD                       :	VitalDelayType01 := (0 ps, 0 ps));

   port(
      A                              :	in    STD_ULOGIC;
      EN                             :	in    STD_ULOGIC;
      PAD                            :	inout STD_ULOGIC;
      Y                              :	out   STD_ULOGIC);
attribute VITAL_LEVEL0 of BBCD16SMP_V5 : entity is TRUE;
end BBCD16SMP_V5;

-- architecture body --
library IEEE;
use IEEE.VITAL_Primitives.all;
library c35_IOLIBV5_4M;
use c35_IOLIBV5_4M.VTABLES.all;
architecture VITAL of BBCD16SMP_V5 is
   attribute VITAL_LEVEL1 of VITAL : architecture is TRUE;

   SIGNAL A_ipd	 : STD_ULOGIC := 'X';
   SIGNAL EN_ipd	 : STD_ULOGIC := 'X';
   SIGNAL PAD_ipd	 : STD_ULOGIC := 'X';

begin

   ---------------------
   --  INPUT PATH DELAYs
   ---------------------
   WireDelay : block
   begin
   VitalWireDelay (A_ipd, A, tipd_A);
   VitalWireDelay (EN_ipd, EN, tipd_EN);
   VitalWireDelay (PAD_ipd, PAD, tipd_PAD);
   end block;
   --------------------
   --  BEHAVIOR SECTION
   --------------------
   VITALBehavior : process (A_ipd, EN_ipd, PAD_ipd)


   -- functionality results
   VARIABLE Results : STD_LOGIC_VECTOR(1 to 2) := (others => 'X');
   ALIAS PAD_zd : STD_LOGIC is Results(1);
   ALIAS Y_zd : STD_LOGIC is Results(2);

   -- output glitch detection variables
   VARIABLE PAD_GlitchData	: VitalGlitchDataType;
   VARIABLE Y_GlitchData	: VitalGlitchDataType;

   begin

      -------------------------
      --  Functionality Section
      -------------------------
      PAD_zd := VitalBUFIF0 (data => A_ipd,
              enable => EN_ipd);
      Y_zd := TO_X01(PAD_ipd);

      ----------------------
      --  Path Delay Section
      ----------------------
      VitalPathDelay01Z (
       OutSignal => PAD,
       GlitchData => PAD_GlitchData,
       OutSignalName => "PAD",
       OutTemp => PAD_zd,
       Paths => (0 => (A_ipd'last_event, VitalExtendToFillDelay(tpd_A_PAD), TRUE),
                 1 => (EN_ipd'last_event, VitalExtendToFillDelay(tpd_EN_PAD), TRUE)),
       Mode => OnEvent,
       Xon => Xon,
       MsgOn => MsgOn,
       MsgSeverity => WARNING,
       OutputMap => "UX01ZWLH-");
      VitalPathDelay01 (
       OutSignal => Y,
       GlitchData => Y_GlitchData,
       OutSignalName => "Y",
       OutTemp => Y_zd,
       Paths => (0 => (PAD_ipd'last_event, tpd_PAD_Y, TRUE)),
       Mode => OnEvent,
       Xon => Xon,
       MsgOn => MsgOn,
       MsgSeverity => WARNING);

end process;

end VITAL;

configuration CFG_BBCD16SMP_V5_VITAL of BBCD16SMP_V5 is
   for VITAL
   end for;
end CFG_BBCD16SMP_V5_VITAL;


----- CELL BBCD16SP_V5 -----
library IEEE;
use IEEE.STD_LOGIC_1164.all;
library IEEE;
use IEEE.VITAL_Timing.all;


-- entity declaration --
entity BBCD16SP_V5 is
   generic(
      TimingChecksOn: Boolean := True;
      InstancePath: STRING := "*";
      Xon: Boolean := True;
      MsgOn: Boolean := True;
      tpd_A_PAD                      :	VitalDelayType01 := (1 ps, 1 ps);
      tpd_EN_PAD                     :	VitalDelayType01z := 
               (1 ps, 1 ps, 1 ps, 1 ps, 1 ps, 1 ps);
      tpd_PAD_Y                      :	VitalDelayType01 := (1 ps, 1 ps);
      tipd_A                         :	VitalDelayType01 := (0 ps, 0 ps);
      tipd_EN                        :	VitalDelayType01 := (0 ps, 0 ps);
      tipd_PAD                       :	VitalDelayType01 := (0 ps, 0 ps));

   port(
      A                              :	in    STD_ULOGIC;
      EN                             :	in    STD_ULOGIC;
      PAD                            :	inout STD_ULOGIC;
      Y                              :	out   STD_ULOGIC);
attribute VITAL_LEVEL0 of BBCD16SP_V5 : entity is TRUE;
end BBCD16SP_V5;

-- architecture body --
library IEEE;
use IEEE.VITAL_Primitives.all;
library c35_IOLIBV5_4M;
use c35_IOLIBV5_4M.VTABLES.all;
architecture VITAL of BBCD16SP_V5 is
   attribute VITAL_LEVEL1 of VITAL : architecture is TRUE;

   SIGNAL A_ipd	 : STD_ULOGIC := 'X';
   SIGNAL EN_ipd	 : STD_ULOGIC := 'X';
   SIGNAL PAD_ipd	 : STD_ULOGIC := 'X';

begin

   ---------------------
   --  INPUT PATH DELAYs
   ---------------------
   WireDelay : block
   begin
   VitalWireDelay (A_ipd, A, tipd_A);
   VitalWireDelay (EN_ipd, EN, tipd_EN);
   VitalWireDelay (PAD_ipd, PAD, tipd_PAD);
   end block;
   --------------------
   --  BEHAVIOR SECTION
   --------------------
   VITALBehavior : process (A_ipd, EN_ipd, PAD_ipd)


   -- functionality results
   VARIABLE Results : STD_LOGIC_VECTOR(1 to 2) := (others => 'X');
   ALIAS PAD_zd : STD_LOGIC is Results(1);
   ALIAS Y_zd : STD_LOGIC is Results(2);

   -- output glitch detection variables
   VARIABLE PAD_GlitchData	: VitalGlitchDataType;
   VARIABLE Y_GlitchData	: VitalGlitchDataType;

   begin

      -------------------------
      --  Functionality Section
      -------------------------
      PAD_zd := VitalBUFIF0 (data => A_ipd,
              enable => EN_ipd);
      Y_zd := TO_X01(PAD_ipd);

      ----------------------
      --  Path Delay Section
      ----------------------
      VitalPathDelay01Z (
       OutSignal => PAD,
       GlitchData => PAD_GlitchData,
       OutSignalName => "PAD",
       OutTemp => PAD_zd,
       Paths => (0 => (A_ipd'last_event, VitalExtendToFillDelay(tpd_A_PAD), TRUE),
                 1 => (EN_ipd'last_event, VitalExtendToFillDelay(tpd_EN_PAD), TRUE)),
       Mode => OnEvent,
       Xon => Xon,
       MsgOn => MsgOn,
       MsgSeverity => WARNING,
       OutputMap => "UX01ZWLH-");
      VitalPathDelay01 (
       OutSignal => Y,
       GlitchData => Y_GlitchData,
       OutSignalName => "Y",
       OutTemp => Y_zd,
       Paths => (0 => (PAD_ipd'last_event, tpd_PAD_Y, TRUE)),
       Mode => OnEvent,
       Xon => Xon,
       MsgOn => MsgOn,
       MsgSeverity => WARNING);

end process;

end VITAL;

configuration CFG_BBCD16SP_V5_VITAL of BBCD16SP_V5 is
   for VITAL
   end for;
end CFG_BBCD16SP_V5_VITAL;


----- CELL BBCD24P_V5 -----
library IEEE;
use IEEE.STD_LOGIC_1164.all;
library IEEE;
use IEEE.VITAL_Timing.all;


-- entity declaration --
entity BBCD24P_V5 is
   generic(
      TimingChecksOn: Boolean := True;
      InstancePath: STRING := "*";
      Xon: Boolean := True;
      MsgOn: Boolean := True;
      tpd_A_PAD                      :	VitalDelayType01 := (1 ps, 1 ps);
      tpd_EN_PAD                     :	VitalDelayType01z := 
               (1 ps, 1 ps, 1 ps, 1 ps, 1 ps, 1 ps);
      tpd_PAD_Y                      :	VitalDelayType01 := (1 ps, 1 ps);
      tipd_A                         :	VitalDelayType01 := (0 ps, 0 ps);
      tipd_EN                        :	VitalDelayType01 := (0 ps, 0 ps);
      tipd_PAD                       :	VitalDelayType01 := (0 ps, 0 ps));

   port(
      A                              :	in    STD_ULOGIC;
      EN                             :	in    STD_ULOGIC;
      PAD                            :	inout STD_ULOGIC;
      Y                              :	out   STD_ULOGIC);
attribute VITAL_LEVEL0 of BBCD24P_V5 : entity is TRUE;
end BBCD24P_V5;

-- architecture body --
library IEEE;
use IEEE.VITAL_Primitives.all;
library c35_IOLIBV5_4M;
use c35_IOLIBV5_4M.VTABLES.all;
architecture VITAL of BBCD24P_V5 is
   attribute VITAL_LEVEL1 of VITAL : architecture is TRUE;

   SIGNAL A_ipd	 : STD_ULOGIC := 'X';
   SIGNAL EN_ipd	 : STD_ULOGIC := 'X';
   SIGNAL PAD_ipd	 : STD_ULOGIC := 'X';

begin

   ---------------------
   --  INPUT PATH DELAYs
   ---------------------
   WireDelay : block
   begin
   VitalWireDelay (A_ipd, A, tipd_A);
   VitalWireDelay (EN_ipd, EN, tipd_EN);
   VitalWireDelay (PAD_ipd, PAD, tipd_PAD);
   end block;
   --------------------
   --  BEHAVIOR SECTION
   --------------------
   VITALBehavior : process (A_ipd, EN_ipd, PAD_ipd)


   -- functionality results
   VARIABLE Results : STD_LOGIC_VECTOR(1 to 2) := (others => 'X');
   ALIAS PAD_zd : STD_LOGIC is Results(1);
   ALIAS Y_zd : STD_LOGIC is Results(2);

   -- output glitch detection variables
   VARIABLE PAD_GlitchData	: VitalGlitchDataType;
   VARIABLE Y_GlitchData	: VitalGlitchDataType;

   begin

      -------------------------
      --  Functionality Section
      -------------------------
      PAD_zd := VitalBUFIF0 (data => A_ipd,
              enable => EN_ipd);
      Y_zd := TO_X01(PAD_ipd);

      ----------------------
      --  Path Delay Section
      ----------------------
      VitalPathDelay01Z (
       OutSignal => PAD,
       GlitchData => PAD_GlitchData,
       OutSignalName => "PAD",
       OutTemp => PAD_zd,
       Paths => (0 => (A_ipd'last_event, VitalExtendToFillDelay(tpd_A_PAD), TRUE),
                 1 => (EN_ipd'last_event, VitalExtendToFillDelay(tpd_EN_PAD), TRUE)),
       Mode => OnEvent,
       Xon => Xon,
       MsgOn => MsgOn,
       MsgSeverity => WARNING,
       OutputMap => "UX01ZWLH-");
      VitalPathDelay01 (
       OutSignal => Y,
       GlitchData => Y_GlitchData,
       OutSignalName => "Y",
       OutTemp => Y_zd,
       Paths => (0 => (PAD_ipd'last_event, tpd_PAD_Y, TRUE)),
       Mode => OnEvent,
       Xon => Xon,
       MsgOn => MsgOn,
       MsgSeverity => WARNING);

end process;

end VITAL;

configuration CFG_BBCD24P_V5_VITAL of BBCD24P_V5 is
   for VITAL
   end for;
end CFG_BBCD24P_V5_VITAL;


----- CELL BBCD24SMP_V5 -----
library IEEE;
use IEEE.STD_LOGIC_1164.all;
library IEEE;
use IEEE.VITAL_Timing.all;


-- entity declaration --
entity BBCD24SMP_V5 is
   generic(
      TimingChecksOn: Boolean := True;
      InstancePath: STRING := "*";
      Xon: Boolean := True;
      MsgOn: Boolean := True;
      tpd_A_PAD                      :	VitalDelayType01 := (1 ps, 1 ps);
      tpd_EN_PAD                     :	VitalDelayType01z := 
               (1 ps, 1 ps, 1 ps, 1 ps, 1 ps, 1 ps);
      tpd_PAD_Y                      :	VitalDelayType01 := (1 ps, 1 ps);
      tipd_A                         :	VitalDelayType01 := (0 ps, 0 ps);
      tipd_EN                        :	VitalDelayType01 := (0 ps, 0 ps);
      tipd_PAD                       :	VitalDelayType01 := (0 ps, 0 ps));

   port(
      A                              :	in    STD_ULOGIC;
      EN                             :	in    STD_ULOGIC;
      PAD                            :	inout STD_ULOGIC;
      Y                              :	out   STD_ULOGIC);
attribute VITAL_LEVEL0 of BBCD24SMP_V5 : entity is TRUE;
end BBCD24SMP_V5;

-- architecture body --
library IEEE;
use IEEE.VITAL_Primitives.all;
library c35_IOLIBV5_4M;
use c35_IOLIBV5_4M.VTABLES.all;
architecture VITAL of BBCD24SMP_V5 is
   attribute VITAL_LEVEL1 of VITAL : architecture is TRUE;

   SIGNAL A_ipd	 : STD_ULOGIC := 'X';
   SIGNAL EN_ipd	 : STD_ULOGIC := 'X';
   SIGNAL PAD_ipd	 : STD_ULOGIC := 'X';

begin

   ---------------------
   --  INPUT PATH DELAYs
   ---------------------
   WireDelay : block
   begin
   VitalWireDelay (A_ipd, A, tipd_A);
   VitalWireDelay (EN_ipd, EN, tipd_EN);
   VitalWireDelay (PAD_ipd, PAD, tipd_PAD);
   end block;
   --------------------
   --  BEHAVIOR SECTION
   --------------------
   VITALBehavior : process (A_ipd, EN_ipd, PAD_ipd)


   -- functionality results
   VARIABLE Results : STD_LOGIC_VECTOR(1 to 2) := (others => 'X');
   ALIAS PAD_zd : STD_LOGIC is Results(1);
   ALIAS Y_zd : STD_LOGIC is Results(2);

   -- output glitch detection variables
   VARIABLE PAD_GlitchData	: VitalGlitchDataType;
   VARIABLE Y_GlitchData	: VitalGlitchDataType;

   begin

      -------------------------
      --  Functionality Section
      -------------------------
      PAD_zd := VitalBUFIF0 (data => A_ipd,
              enable => EN_ipd);
      Y_zd := TO_X01(PAD_ipd);

      ----------------------
      --  Path Delay Section
      ----------------------
      VitalPathDelay01Z (
       OutSignal => PAD,
       GlitchData => PAD_GlitchData,
       OutSignalName => "PAD",
       OutTemp => PAD_zd,
       Paths => (0 => (A_ipd'last_event, VitalExtendToFillDelay(tpd_A_PAD), TRUE),
                 1 => (EN_ipd'last_event, VitalExtendToFillDelay(tpd_EN_PAD), TRUE)),
       Mode => OnEvent,
       Xon => Xon,
       MsgOn => MsgOn,
       MsgSeverity => WARNING,
       OutputMap => "UX01ZWLH-");
      VitalPathDelay01 (
       OutSignal => Y,
       GlitchData => Y_GlitchData,
       OutSignalName => "Y",
       OutTemp => Y_zd,
       Paths => (0 => (PAD_ipd'last_event, tpd_PAD_Y, TRUE)),
       Mode => OnEvent,
       Xon => Xon,
       MsgOn => MsgOn,
       MsgSeverity => WARNING);

end process;

end VITAL;

configuration CFG_BBCD24SMP_V5_VITAL of BBCD24SMP_V5 is
   for VITAL
   end for;
end CFG_BBCD24SMP_V5_VITAL;


----- CELL BBCD24SP_V5 -----
library IEEE;
use IEEE.STD_LOGIC_1164.all;
library IEEE;
use IEEE.VITAL_Timing.all;


-- entity declaration --
entity BBCD24SP_V5 is
   generic(
      TimingChecksOn: Boolean := True;
      InstancePath: STRING := "*";
      Xon: Boolean := True;
      MsgOn: Boolean := True;
      tpd_A_PAD                      :	VitalDelayType01 := (1 ps, 1 ps);
      tpd_EN_PAD                     :	VitalDelayType01z := 
               (1 ps, 1 ps, 1 ps, 1 ps, 1 ps, 1 ps);
      tpd_PAD_Y                      :	VitalDelayType01 := (1 ps, 1 ps);
      tipd_A                         :	VitalDelayType01 := (0 ps, 0 ps);
      tipd_EN                        :	VitalDelayType01 := (0 ps, 0 ps);
      tipd_PAD                       :	VitalDelayType01 := (0 ps, 0 ps));

   port(
      A                              :	in    STD_ULOGIC;
      EN                             :	in    STD_ULOGIC;
      PAD                            :	inout STD_ULOGIC;
      Y                              :	out   STD_ULOGIC);
attribute VITAL_LEVEL0 of BBCD24SP_V5 : entity is TRUE;
end BBCD24SP_V5;

-- architecture body --
library IEEE;
use IEEE.VITAL_Primitives.all;
library c35_IOLIBV5_4M;
use c35_IOLIBV5_4M.VTABLES.all;
architecture VITAL of BBCD24SP_V5 is
   attribute VITAL_LEVEL1 of VITAL : architecture is TRUE;

   SIGNAL A_ipd	 : STD_ULOGIC := 'X';
   SIGNAL EN_ipd	 : STD_ULOGIC := 'X';
   SIGNAL PAD_ipd	 : STD_ULOGIC := 'X';

begin

   ---------------------
   --  INPUT PATH DELAYs
   ---------------------
   WireDelay : block
   begin
   VitalWireDelay (A_ipd, A, tipd_A);
   VitalWireDelay (EN_ipd, EN, tipd_EN);
   VitalWireDelay (PAD_ipd, PAD, tipd_PAD);
   end block;
   --------------------
   --  BEHAVIOR SECTION
   --------------------
   VITALBehavior : process (A_ipd, EN_ipd, PAD_ipd)


   -- functionality results
   VARIABLE Results : STD_LOGIC_VECTOR(1 to 2) := (others => 'X');
   ALIAS PAD_zd : STD_LOGIC is Results(1);
   ALIAS Y_zd : STD_LOGIC is Results(2);

   -- output glitch detection variables
   VARIABLE PAD_GlitchData	: VitalGlitchDataType;
   VARIABLE Y_GlitchData	: VitalGlitchDataType;

   begin

      -------------------------
      --  Functionality Section
      -------------------------
      PAD_zd := VitalBUFIF0 (data => A_ipd,
              enable => EN_ipd);
      Y_zd := TO_X01(PAD_ipd);

      ----------------------
      --  Path Delay Section
      ----------------------
      VitalPathDelay01Z (
       OutSignal => PAD,
       GlitchData => PAD_GlitchData,
       OutSignalName => "PAD",
       OutTemp => PAD_zd,
       Paths => (0 => (A_ipd'last_event, VitalExtendToFillDelay(tpd_A_PAD), TRUE),
                 1 => (EN_ipd'last_event, VitalExtendToFillDelay(tpd_EN_PAD), TRUE)),
       Mode => OnEvent,
       Xon => Xon,
       MsgOn => MsgOn,
       MsgSeverity => WARNING,
       OutputMap => "UX01ZWLH-");
      VitalPathDelay01 (
       OutSignal => Y,
       GlitchData => Y_GlitchData,
       OutSignalName => "Y",
       OutTemp => Y_zd,
       Paths => (0 => (PAD_ipd'last_event, tpd_PAD_Y, TRUE)),
       Mode => OnEvent,
       Xon => Xon,
       MsgOn => MsgOn,
       MsgSeverity => WARNING);

end process;

end VITAL;

configuration CFG_BBCD24SP_V5_VITAL of BBCD24SP_V5 is
   for VITAL
   end for;
end CFG_BBCD24SP_V5_VITAL;


----- CELL BBCU1P_V5 -----
library IEEE;
use IEEE.STD_LOGIC_1164.all;
library IEEE;
use IEEE.VITAL_Timing.all;


-- entity declaration --
entity BBCU1P_V5 is
   generic(
      TimingChecksOn: Boolean := True;
      InstancePath: STRING := "*";
      Xon: Boolean := True;
      MsgOn: Boolean := True;
      tpd_A_PAD                      :	VitalDelayType01 := (1 ps, 1 ps);
      tpd_EN_PAD                     :	VitalDelayType01z := 
               (1 ps, 1 ps, 1 ps, 1 ps, 1 ps, 1 ps);
      tpd_PAD_Y                      :	VitalDelayType01 := (1 ps, 1 ps);
      tipd_A                         :	VitalDelayType01 := (0 ps, 0 ps);
      tipd_EN                        :	VitalDelayType01 := (0 ps, 0 ps);
      tipd_PAD                       :	VitalDelayType01 := (0 ps, 0 ps));

   port(
      A                              :	in    STD_ULOGIC;
      EN                             :	in    STD_ULOGIC;
      PAD                            :	inout STD_ULOGIC;
      Y                              :	out   STD_ULOGIC);
attribute VITAL_LEVEL0 of BBCU1P_V5 : entity is TRUE;
end BBCU1P_V5;

-- architecture body --
library IEEE;
use IEEE.VITAL_Primitives.all;
library c35_IOLIBV5_4M;
use c35_IOLIBV5_4M.VTABLES.all;
architecture VITAL of BBCU1P_V5 is
   attribute VITAL_LEVEL1 of VITAL : architecture is TRUE;

   SIGNAL A_ipd	 : STD_ULOGIC := 'X';
   SIGNAL EN_ipd	 : STD_ULOGIC := 'X';
   SIGNAL PAD_ipd	 : STD_ULOGIC := 'X';

begin

   ---------------------
   --  INPUT PATH DELAYs
   ---------------------
   WireDelay : block
   begin
   VitalWireDelay (A_ipd, A, tipd_A);
   VitalWireDelay (EN_ipd, EN, tipd_EN);
   VitalWireDelay (PAD_ipd, PAD, tipd_PAD);
   end block;
   --------------------
   --  BEHAVIOR SECTION
   --------------------
   VITALBehavior : process (A_ipd, EN_ipd, PAD_ipd)


   -- functionality results
   VARIABLE Results : STD_LOGIC_VECTOR(1 to 2) := (others => 'X');
   ALIAS PAD_zd : STD_LOGIC is Results(1);
   ALIAS Y_zd : STD_LOGIC is Results(2);

   -- output glitch detection variables
   VARIABLE PAD_GlitchData	: VitalGlitchDataType;
   VARIABLE Y_GlitchData	: VitalGlitchDataType;

   begin

      -------------------------
      --  Functionality Section
      -------------------------
      PAD_zd := VitalBUFIF0 (data => A_ipd,
              enable => EN_ipd);
      Y_zd := TO_X01(PAD_ipd);

      ----------------------
      --  Path Delay Section
      ----------------------
      VitalPathDelay01Z (
       OutSignal => PAD,
       GlitchData => PAD_GlitchData,
       OutSignalName => "PAD",
       OutTemp => PAD_zd,
       Paths => (0 => (A_ipd'last_event, VitalExtendToFillDelay(tpd_A_PAD), TRUE),
                 1 => (EN_ipd'last_event, VitalExtendToFillDelay(tpd_EN_PAD), TRUE)),
       Mode => OnEvent,
       Xon => Xon,
       MsgOn => MsgOn,
       MsgSeverity => WARNING,
       OutputMap => "UX01ZWLH-");
      VitalPathDelay01 (
       OutSignal => Y,
       GlitchData => Y_GlitchData,
       OutSignalName => "Y",
       OutTemp => Y_zd,
       Paths => (0 => (PAD_ipd'last_event, tpd_PAD_Y, TRUE)),
       Mode => OnEvent,
       Xon => Xon,
       MsgOn => MsgOn,
       MsgSeverity => WARNING);

end process;

end VITAL;

configuration CFG_BBCU1P_V5_VITAL of BBCU1P_V5 is
   for VITAL
   end for;
end CFG_BBCU1P_V5_VITAL;


----- CELL BBCU4P_V5 -----
library IEEE;
use IEEE.STD_LOGIC_1164.all;
library IEEE;
use IEEE.VITAL_Timing.all;


-- entity declaration --
entity BBCU4P_V5 is
   generic(
      TimingChecksOn: Boolean := True;
      InstancePath: STRING := "*";
      Xon: Boolean := True;
      MsgOn: Boolean := True;
      tpd_A_PAD                      :	VitalDelayType01 := (1 ps, 1 ps);
      tpd_EN_PAD                     :	VitalDelayType01z := 
               (1 ps, 1 ps, 1 ps, 1 ps, 1 ps, 1 ps);
      tpd_PAD_Y                      :	VitalDelayType01 := (1 ps, 1 ps);
      tipd_A                         :	VitalDelayType01 := (0 ps, 0 ps);
      tipd_EN                        :	VitalDelayType01 := (0 ps, 0 ps);
      tipd_PAD                       :	VitalDelayType01 := (0 ps, 0 ps));

   port(
      A                              :	in    STD_ULOGIC;
      EN                             :	in    STD_ULOGIC;
      PAD                            :	inout STD_ULOGIC;
      Y                              :	out   STD_ULOGIC);
attribute VITAL_LEVEL0 of BBCU4P_V5 : entity is TRUE;
end BBCU4P_V5;

-- architecture body --
library IEEE;
use IEEE.VITAL_Primitives.all;
library c35_IOLIBV5_4M;
use c35_IOLIBV5_4M.VTABLES.all;
architecture VITAL of BBCU4P_V5 is
   attribute VITAL_LEVEL1 of VITAL : architecture is TRUE;

   SIGNAL A_ipd	 : STD_ULOGIC := 'X';
   SIGNAL EN_ipd	 : STD_ULOGIC := 'X';
   SIGNAL PAD_ipd	 : STD_ULOGIC := 'X';

begin

   ---------------------
   --  INPUT PATH DELAYs
   ---------------------
   WireDelay : block
   begin
   VitalWireDelay (A_ipd, A, tipd_A);
   VitalWireDelay (EN_ipd, EN, tipd_EN);
   VitalWireDelay (PAD_ipd, PAD, tipd_PAD);
   end block;
   --------------------
   --  BEHAVIOR SECTION
   --------------------
   VITALBehavior : process (A_ipd, EN_ipd, PAD_ipd)


   -- functionality results
   VARIABLE Results : STD_LOGIC_VECTOR(1 to 2) := (others => 'X');
   ALIAS PAD_zd : STD_LOGIC is Results(1);
   ALIAS Y_zd : STD_LOGIC is Results(2);

   -- output glitch detection variables
   VARIABLE PAD_GlitchData	: VitalGlitchDataType;
   VARIABLE Y_GlitchData	: VitalGlitchDataType;

   begin

      -------------------------
      --  Functionality Section
      -------------------------
      PAD_zd := VitalBUFIF0 (data => A_ipd,
              enable => EN_ipd);
      Y_zd := TO_X01(PAD_ipd);

      ----------------------
      --  Path Delay Section
      ----------------------
      VitalPathDelay01Z (
       OutSignal => PAD,
       GlitchData => PAD_GlitchData,
       OutSignalName => "PAD",
       OutTemp => PAD_zd,
       Paths => (0 => (A_ipd'last_event, VitalExtendToFillDelay(tpd_A_PAD), TRUE),
                 1 => (EN_ipd'last_event, VitalExtendToFillDelay(tpd_EN_PAD), TRUE)),
       Mode => OnEvent,
       Xon => Xon,
       MsgOn => MsgOn,
       MsgSeverity => WARNING,
       OutputMap => "UX01ZWLH-");
      VitalPathDelay01 (
       OutSignal => Y,
       GlitchData => Y_GlitchData,
       OutSignalName => "Y",
       OutTemp => Y_zd,
       Paths => (0 => (PAD_ipd'last_event, tpd_PAD_Y, TRUE)),
       Mode => OnEvent,
       Xon => Xon,
       MsgOn => MsgOn,
       MsgSeverity => WARNING);

end process;

end VITAL;

configuration CFG_BBCU4P_V5_VITAL of BBCU4P_V5 is
   for VITAL
   end for;
end CFG_BBCU4P_V5_VITAL;


----- CELL BBCU4SMP_V5 -----
library IEEE;
use IEEE.STD_LOGIC_1164.all;
library IEEE;
use IEEE.VITAL_Timing.all;


-- entity declaration --
entity BBCU4SMP_V5 is
   generic(
      TimingChecksOn: Boolean := True;
      InstancePath: STRING := "*";
      Xon: Boolean := True;
      MsgOn: Boolean := True;
      tpd_A_PAD                      :	VitalDelayType01 := (1 ps, 1 ps);
      tpd_EN_PAD                     :	VitalDelayType01z := 
               (1 ps, 1 ps, 1 ps, 1 ps, 1 ps, 1 ps);
      tpd_PAD_Y                      :	VitalDelayType01 := (1 ps, 1 ps);
      tipd_A                         :	VitalDelayType01 := (0 ps, 0 ps);
      tipd_EN                        :	VitalDelayType01 := (0 ps, 0 ps);
      tipd_PAD                       :	VitalDelayType01 := (0 ps, 0 ps));

   port(
      A                              :	in    STD_ULOGIC;
      EN                             :	in    STD_ULOGIC;
      PAD                            :	inout STD_ULOGIC;
      Y                              :	out   STD_ULOGIC);
attribute VITAL_LEVEL0 of BBCU4SMP_V5 : entity is TRUE;
end BBCU4SMP_V5;

-- architecture body --
library IEEE;
use IEEE.VITAL_Primitives.all;
library c35_IOLIBV5_4M;
use c35_IOLIBV5_4M.VTABLES.all;
architecture VITAL of BBCU4SMP_V5 is
   attribute VITAL_LEVEL1 of VITAL : architecture is TRUE;

   SIGNAL A_ipd	 : STD_ULOGIC := 'X';
   SIGNAL EN_ipd	 : STD_ULOGIC := 'X';
   SIGNAL PAD_ipd	 : STD_ULOGIC := 'X';

begin

   ---------------------
   --  INPUT PATH DELAYs
   ---------------------
   WireDelay : block
   begin
   VitalWireDelay (A_ipd, A, tipd_A);
   VitalWireDelay (EN_ipd, EN, tipd_EN);
   VitalWireDelay (PAD_ipd, PAD, tipd_PAD);
   end block;
   --------------------
   --  BEHAVIOR SECTION
   --------------------
   VITALBehavior : process (A_ipd, EN_ipd, PAD_ipd)


   -- functionality results
   VARIABLE Results : STD_LOGIC_VECTOR(1 to 2) := (others => 'X');
   ALIAS PAD_zd : STD_LOGIC is Results(1);
   ALIAS Y_zd : STD_LOGIC is Results(2);

   -- output glitch detection variables
   VARIABLE PAD_GlitchData	: VitalGlitchDataType;
   VARIABLE Y_GlitchData	: VitalGlitchDataType;

   begin

      -------------------------
      --  Functionality Section
      -------------------------
      PAD_zd := VitalBUFIF0 (data => A_ipd,
              enable => EN_ipd);
      Y_zd := TO_X01(PAD_ipd);

      ----------------------
      --  Path Delay Section
      ----------------------
      VitalPathDelay01Z (
       OutSignal => PAD,
       GlitchData => PAD_GlitchData,
       OutSignalName => "PAD",
       OutTemp => PAD_zd,
       Paths => (0 => (A_ipd'last_event, VitalExtendToFillDelay(tpd_A_PAD), TRUE),
                 1 => (EN_ipd'last_event, VitalExtendToFillDelay(tpd_EN_PAD), TRUE)),
       Mode => OnEvent,
       Xon => Xon,
       MsgOn => MsgOn,
       MsgSeverity => WARNING,
       OutputMap => "UX01ZWLH-");
      VitalPathDelay01 (
       OutSignal => Y,
       GlitchData => Y_GlitchData,
       OutSignalName => "Y",
       OutTemp => Y_zd,
       Paths => (0 => (PAD_ipd'last_event, tpd_PAD_Y, TRUE)),
       Mode => OnEvent,
       Xon => Xon,
       MsgOn => MsgOn,
       MsgSeverity => WARNING);

end process;

end VITAL;

configuration CFG_BBCU4SMP_V5_VITAL of BBCU4SMP_V5 is
   for VITAL
   end for;
end CFG_BBCU4SMP_V5_VITAL;


----- CELL BBCU8P_V5 -----
library IEEE;
use IEEE.STD_LOGIC_1164.all;
library IEEE;
use IEEE.VITAL_Timing.all;


-- entity declaration --
entity BBCU8P_V5 is
   generic(
      TimingChecksOn: Boolean := True;
      InstancePath: STRING := "*";
      Xon: Boolean := True;
      MsgOn: Boolean := True;
      tpd_A_PAD                      :	VitalDelayType01 := (1 ps, 1 ps);
      tpd_EN_PAD                     :	VitalDelayType01z := 
               (1 ps, 1 ps, 1 ps, 1 ps, 1 ps, 1 ps);
      tpd_PAD_Y                      :	VitalDelayType01 := (1 ps, 1 ps);
      tipd_A                         :	VitalDelayType01 := (0 ps, 0 ps);
      tipd_EN                        :	VitalDelayType01 := (0 ps, 0 ps);
      tipd_PAD                       :	VitalDelayType01 := (0 ps, 0 ps));

   port(
      A                              :	in    STD_ULOGIC;
      EN                             :	in    STD_ULOGIC;
      PAD                            :	inout STD_ULOGIC;
      Y                              :	out   STD_ULOGIC);
attribute VITAL_LEVEL0 of BBCU8P_V5 : entity is TRUE;
end BBCU8P_V5;

-- architecture body --
library IEEE;
use IEEE.VITAL_Primitives.all;
library c35_IOLIBV5_4M;
use c35_IOLIBV5_4M.VTABLES.all;
architecture VITAL of BBCU8P_V5 is
   attribute VITAL_LEVEL1 of VITAL : architecture is TRUE;

   SIGNAL A_ipd	 : STD_ULOGIC := 'X';
   SIGNAL EN_ipd	 : STD_ULOGIC := 'X';
   SIGNAL PAD_ipd	 : STD_ULOGIC := 'X';

begin

   ---------------------
   --  INPUT PATH DELAYs
   ---------------------
   WireDelay : block
   begin
   VitalWireDelay (A_ipd, A, tipd_A);
   VitalWireDelay (EN_ipd, EN, tipd_EN);
   VitalWireDelay (PAD_ipd, PAD, tipd_PAD);
   end block;
   --------------------
   --  BEHAVIOR SECTION
   --------------------
   VITALBehavior : process (A_ipd, EN_ipd, PAD_ipd)


   -- functionality results
   VARIABLE Results : STD_LOGIC_VECTOR(1 to 2) := (others => 'X');
   ALIAS PAD_zd : STD_LOGIC is Results(1);
   ALIAS Y_zd : STD_LOGIC is Results(2);

   -- output glitch detection variables
   VARIABLE PAD_GlitchData	: VitalGlitchDataType;
   VARIABLE Y_GlitchData	: VitalGlitchDataType;

   begin

      -------------------------
      --  Functionality Section
      -------------------------
      PAD_zd := VitalBUFIF0 (data => A_ipd,
              enable => EN_ipd);
      Y_zd := TO_X01(PAD_ipd);

      ----------------------
      --  Path Delay Section
      ----------------------
      VitalPathDelay01Z (
       OutSignal => PAD,
       GlitchData => PAD_GlitchData,
       OutSignalName => "PAD",
       OutTemp => PAD_zd,
       Paths => (0 => (A_ipd'last_event, VitalExtendToFillDelay(tpd_A_PAD), TRUE),
                 1 => (EN_ipd'last_event, VitalExtendToFillDelay(tpd_EN_PAD), TRUE)),
       Mode => OnEvent,
       Xon => Xon,
       MsgOn => MsgOn,
       MsgSeverity => WARNING,
       OutputMap => "UX01ZWLH-");
      VitalPathDelay01 (
       OutSignal => Y,
       GlitchData => Y_GlitchData,
       OutSignalName => "Y",
       OutTemp => Y_zd,
       Paths => (0 => (PAD_ipd'last_event, tpd_PAD_Y, TRUE)),
       Mode => OnEvent,
       Xon => Xon,
       MsgOn => MsgOn,
       MsgSeverity => WARNING);

end process;

end VITAL;

configuration CFG_BBCU8P_V5_VITAL of BBCU8P_V5 is
   for VITAL
   end for;
end CFG_BBCU8P_V5_VITAL;


----- CELL BBCU8SMP_V5 -----
library IEEE;
use IEEE.STD_LOGIC_1164.all;
library IEEE;
use IEEE.VITAL_Timing.all;


-- entity declaration --
entity BBCU8SMP_V5 is
   generic(
      TimingChecksOn: Boolean := True;
      InstancePath: STRING := "*";
      Xon: Boolean := True;
      MsgOn: Boolean := True;
      tpd_A_PAD                      :	VitalDelayType01 := (1 ps, 1 ps);
      tpd_EN_PAD                     :	VitalDelayType01z := 
               (1 ps, 1 ps, 1 ps, 1 ps, 1 ps, 1 ps);
      tpd_PAD_Y                      :	VitalDelayType01 := (1 ps, 1 ps);
      tipd_A                         :	VitalDelayType01 := (0 ps, 0 ps);
      tipd_EN                        :	VitalDelayType01 := (0 ps, 0 ps);
      tipd_PAD                       :	VitalDelayType01 := (0 ps, 0 ps));

   port(
      A                              :	in    STD_ULOGIC;
      EN                             :	in    STD_ULOGIC;
      PAD                            :	inout STD_ULOGIC;
      Y                              :	out   STD_ULOGIC);
attribute VITAL_LEVEL0 of BBCU8SMP_V5 : entity is TRUE;
end BBCU8SMP_V5;

-- architecture body --
library IEEE;
use IEEE.VITAL_Primitives.all;
library c35_IOLIBV5_4M;
use c35_IOLIBV5_4M.VTABLES.all;
architecture VITAL of BBCU8SMP_V5 is
   attribute VITAL_LEVEL1 of VITAL : architecture is TRUE;

   SIGNAL A_ipd	 : STD_ULOGIC := 'X';
   SIGNAL EN_ipd	 : STD_ULOGIC := 'X';
   SIGNAL PAD_ipd	 : STD_ULOGIC := 'X';

begin

   ---------------------
   --  INPUT PATH DELAYs
   ---------------------
   WireDelay : block
   begin
   VitalWireDelay (A_ipd, A, tipd_A);
   VitalWireDelay (EN_ipd, EN, tipd_EN);
   VitalWireDelay (PAD_ipd, PAD, tipd_PAD);
   end block;
   --------------------
   --  BEHAVIOR SECTION
   --------------------
   VITALBehavior : process (A_ipd, EN_ipd, PAD_ipd)


   -- functionality results
   VARIABLE Results : STD_LOGIC_VECTOR(1 to 2) := (others => 'X');
   ALIAS PAD_zd : STD_LOGIC is Results(1);
   ALIAS Y_zd : STD_LOGIC is Results(2);

   -- output glitch detection variables
   VARIABLE PAD_GlitchData	: VitalGlitchDataType;
   VARIABLE Y_GlitchData	: VitalGlitchDataType;

   begin

      -------------------------
      --  Functionality Section
      -------------------------
      PAD_zd := VitalBUFIF0 (data => A_ipd,
              enable => EN_ipd);
      Y_zd := TO_X01(PAD_ipd);

      ----------------------
      --  Path Delay Section
      ----------------------
      VitalPathDelay01Z (
       OutSignal => PAD,
       GlitchData => PAD_GlitchData,
       OutSignalName => "PAD",
       OutTemp => PAD_zd,
       Paths => (0 => (A_ipd'last_event, VitalExtendToFillDelay(tpd_A_PAD), TRUE),
                 1 => (EN_ipd'last_event, VitalExtendToFillDelay(tpd_EN_PAD), TRUE)),
       Mode => OnEvent,
       Xon => Xon,
       MsgOn => MsgOn,
       MsgSeverity => WARNING,
       OutputMap => "UX01ZWLH-");
      VitalPathDelay01 (
       OutSignal => Y,
       GlitchData => Y_GlitchData,
       OutSignalName => "Y",
       OutTemp => Y_zd,
       Paths => (0 => (PAD_ipd'last_event, tpd_PAD_Y, TRUE)),
       Mode => OnEvent,
       Xon => Xon,
       MsgOn => MsgOn,
       MsgSeverity => WARNING);

end process;

end VITAL;

configuration CFG_BBCU8SMP_V5_VITAL of BBCU8SMP_V5 is
   for VITAL
   end for;
end CFG_BBCU8SMP_V5_VITAL;


----- CELL BBCU8SP_V5 -----
library IEEE;
use IEEE.STD_LOGIC_1164.all;
library IEEE;
use IEEE.VITAL_Timing.all;


-- entity declaration --
entity BBCU8SP_V5 is
   generic(
      TimingChecksOn: Boolean := True;
      InstancePath: STRING := "*";
      Xon: Boolean := True;
      MsgOn: Boolean := True;
      tpd_A_PAD                      :	VitalDelayType01 := (1 ps, 1 ps);
      tpd_EN_PAD                     :	VitalDelayType01z := 
               (1 ps, 1 ps, 1 ps, 1 ps, 1 ps, 1 ps);
      tpd_PAD_Y                      :	VitalDelayType01 := (1 ps, 1 ps);
      tipd_A                         :	VitalDelayType01 := (0 ps, 0 ps);
      tipd_EN                        :	VitalDelayType01 := (0 ps, 0 ps);
      tipd_PAD                       :	VitalDelayType01 := (0 ps, 0 ps));

   port(
      A                              :	in    STD_ULOGIC;
      EN                             :	in    STD_ULOGIC;
      PAD                            :	inout STD_ULOGIC;
      Y                              :	out   STD_ULOGIC);
attribute VITAL_LEVEL0 of BBCU8SP_V5 : entity is TRUE;
end BBCU8SP_V5;

-- architecture body --
library IEEE;
use IEEE.VITAL_Primitives.all;
library c35_IOLIBV5_4M;
use c35_IOLIBV5_4M.VTABLES.all;
architecture VITAL of BBCU8SP_V5 is
   attribute VITAL_LEVEL1 of VITAL : architecture is TRUE;

   SIGNAL A_ipd	 : STD_ULOGIC := 'X';
   SIGNAL EN_ipd	 : STD_ULOGIC := 'X';
   SIGNAL PAD_ipd	 : STD_ULOGIC := 'X';

begin

   ---------------------
   --  INPUT PATH DELAYs
   ---------------------
   WireDelay : block
   begin
   VitalWireDelay (A_ipd, A, tipd_A);
   VitalWireDelay (EN_ipd, EN, tipd_EN);
   VitalWireDelay (PAD_ipd, PAD, tipd_PAD);
   end block;
   --------------------
   --  BEHAVIOR SECTION
   --------------------
   VITALBehavior : process (A_ipd, EN_ipd, PAD_ipd)


   -- functionality results
   VARIABLE Results : STD_LOGIC_VECTOR(1 to 2) := (others => 'X');
   ALIAS PAD_zd : STD_LOGIC is Results(1);
   ALIAS Y_zd : STD_LOGIC is Results(2);

   -- output glitch detection variables
   VARIABLE PAD_GlitchData	: VitalGlitchDataType;
   VARIABLE Y_GlitchData	: VitalGlitchDataType;

   begin

      -------------------------
      --  Functionality Section
      -------------------------
      PAD_zd := VitalBUFIF0 (data => A_ipd,
              enable => EN_ipd);
      Y_zd := TO_X01(PAD_ipd);

      ----------------------
      --  Path Delay Section
      ----------------------
      VitalPathDelay01Z (
       OutSignal => PAD,
       GlitchData => PAD_GlitchData,
       OutSignalName => "PAD",
       OutTemp => PAD_zd,
       Paths => (0 => (A_ipd'last_event, VitalExtendToFillDelay(tpd_A_PAD), TRUE),
                 1 => (EN_ipd'last_event, VitalExtendToFillDelay(tpd_EN_PAD), TRUE)),
       Mode => OnEvent,
       Xon => Xon,
       MsgOn => MsgOn,
       MsgSeverity => WARNING,
       OutputMap => "UX01ZWLH-");
      VitalPathDelay01 (
       OutSignal => Y,
       GlitchData => Y_GlitchData,
       OutSignalName => "Y",
       OutTemp => Y_zd,
       Paths => (0 => (PAD_ipd'last_event, tpd_PAD_Y, TRUE)),
       Mode => OnEvent,
       Xon => Xon,
       MsgOn => MsgOn,
       MsgSeverity => WARNING);

end process;

end VITAL;

configuration CFG_BBCU8SP_V5_VITAL of BBCU8SP_V5 is
   for VITAL
   end for;
end CFG_BBCU8SP_V5_VITAL;


----- CELL BBCU16P_V5 -----
library IEEE;
use IEEE.STD_LOGIC_1164.all;
library IEEE;
use IEEE.VITAL_Timing.all;


-- entity declaration --
entity BBCU16P_V5 is
   generic(
      TimingChecksOn: Boolean := True;
      InstancePath: STRING := "*";
      Xon: Boolean := True;
      MsgOn: Boolean := True;
      tpd_A_PAD                      :	VitalDelayType01 := (1 ps, 1 ps);
      tpd_EN_PAD                     :	VitalDelayType01z := 
               (1 ps, 1 ps, 1 ps, 1 ps, 1 ps, 1 ps);
      tpd_PAD_Y                      :	VitalDelayType01 := (1 ps, 1 ps);
      tipd_A                         :	VitalDelayType01 := (0 ps, 0 ps);
      tipd_EN                        :	VitalDelayType01 := (0 ps, 0 ps);
      tipd_PAD                       :	VitalDelayType01 := (0 ps, 0 ps));

   port(
      A                              :	in    STD_ULOGIC;
      EN                             :	in    STD_ULOGIC;
      PAD                            :	inout STD_ULOGIC;
      Y                              :	out   STD_ULOGIC);
attribute VITAL_LEVEL0 of BBCU16P_V5 : entity is TRUE;
end BBCU16P_V5;

-- architecture body --
library IEEE;
use IEEE.VITAL_Primitives.all;
library c35_IOLIBV5_4M;
use c35_IOLIBV5_4M.VTABLES.all;
architecture VITAL of BBCU16P_V5 is
   attribute VITAL_LEVEL1 of VITAL : architecture is TRUE;

   SIGNAL A_ipd	 : STD_ULOGIC := 'X';
   SIGNAL EN_ipd	 : STD_ULOGIC := 'X';
   SIGNAL PAD_ipd	 : STD_ULOGIC := 'X';

begin

   ---------------------
   --  INPUT PATH DELAYs
   ---------------------
   WireDelay : block
   begin
   VitalWireDelay (A_ipd, A, tipd_A);
   VitalWireDelay (EN_ipd, EN, tipd_EN);
   VitalWireDelay (PAD_ipd, PAD, tipd_PAD);
   end block;
   --------------------
   --  BEHAVIOR SECTION
   --------------------
   VITALBehavior : process (A_ipd, EN_ipd, PAD_ipd)


   -- functionality results
   VARIABLE Results : STD_LOGIC_VECTOR(1 to 2) := (others => 'X');
   ALIAS PAD_zd : STD_LOGIC is Results(1);
   ALIAS Y_zd : STD_LOGIC is Results(2);

   -- output glitch detection variables
   VARIABLE PAD_GlitchData	: VitalGlitchDataType;
   VARIABLE Y_GlitchData	: VitalGlitchDataType;

   begin

      -------------------------
      --  Functionality Section
      -------------------------
      PAD_zd := VitalBUFIF0 (data => A_ipd,
              enable => EN_ipd);
      Y_zd := TO_X01(PAD_ipd);

      ----------------------
      --  Path Delay Section
      ----------------------
      VitalPathDelay01Z (
       OutSignal => PAD,
       GlitchData => PAD_GlitchData,
       OutSignalName => "PAD",
       OutTemp => PAD_zd,
       Paths => (0 => (A_ipd'last_event, VitalExtendToFillDelay(tpd_A_PAD), TRUE),
                 1 => (EN_ipd'last_event, VitalExtendToFillDelay(tpd_EN_PAD), TRUE)),
       Mode => OnEvent,
       Xon => Xon,
       MsgOn => MsgOn,
       MsgSeverity => WARNING,
       OutputMap => "UX01ZWLH-");
      VitalPathDelay01 (
       OutSignal => Y,
       GlitchData => Y_GlitchData,
       OutSignalName => "Y",
       OutTemp => Y_zd,
       Paths => (0 => (PAD_ipd'last_event, tpd_PAD_Y, TRUE)),
       Mode => OnEvent,
       Xon => Xon,
       MsgOn => MsgOn,
       MsgSeverity => WARNING);

end process;

end VITAL;

configuration CFG_BBCU16P_V5_VITAL of BBCU16P_V5 is
   for VITAL
   end for;
end CFG_BBCU16P_V5_VITAL;


----- CELL BBCU16SMP_V5 -----
library IEEE;
use IEEE.STD_LOGIC_1164.all;
library IEEE;
use IEEE.VITAL_Timing.all;


-- entity declaration --
entity BBCU16SMP_V5 is
   generic(
      TimingChecksOn: Boolean := True;
      InstancePath: STRING := "*";
      Xon: Boolean := True;
      MsgOn: Boolean := True;
      tpd_A_PAD                      :	VitalDelayType01 := (1 ps, 1 ps);
      tpd_EN_PAD                     :	VitalDelayType01z := 
               (1 ps, 1 ps, 1 ps, 1 ps, 1 ps, 1 ps);
      tpd_PAD_Y                      :	VitalDelayType01 := (1 ps, 1 ps);
      tipd_A                         :	VitalDelayType01 := (0 ps, 0 ps);
      tipd_EN                        :	VitalDelayType01 := (0 ps, 0 ps);
      tipd_PAD                       :	VitalDelayType01 := (0 ps, 0 ps));

   port(
      A                              :	in    STD_ULOGIC;
      EN                             :	in    STD_ULOGIC;
      PAD                            :	inout STD_ULOGIC;
      Y                              :	out   STD_ULOGIC);
attribute VITAL_LEVEL0 of BBCU16SMP_V5 : entity is TRUE;
end BBCU16SMP_V5;

-- architecture body --
library IEEE;
use IEEE.VITAL_Primitives.all;
library c35_IOLIBV5_4M;
use c35_IOLIBV5_4M.VTABLES.all;
architecture VITAL of BBCU16SMP_V5 is
   attribute VITAL_LEVEL1 of VITAL : architecture is TRUE;

   SIGNAL A_ipd	 : STD_ULOGIC := 'X';
   SIGNAL EN_ipd	 : STD_ULOGIC := 'X';
   SIGNAL PAD_ipd	 : STD_ULOGIC := 'X';

begin

   ---------------------
   --  INPUT PATH DELAYs
   ---------------------
   WireDelay : block
   begin
   VitalWireDelay (A_ipd, A, tipd_A);
   VitalWireDelay (EN_ipd, EN, tipd_EN);
   VitalWireDelay (PAD_ipd, PAD, tipd_PAD);
   end block;
   --------------------
   --  BEHAVIOR SECTION
   --------------------
   VITALBehavior : process (A_ipd, EN_ipd, PAD_ipd)


   -- functionality results
   VARIABLE Results : STD_LOGIC_VECTOR(1 to 2) := (others => 'X');
   ALIAS PAD_zd : STD_LOGIC is Results(1);
   ALIAS Y_zd : STD_LOGIC is Results(2);

   -- output glitch detection variables
   VARIABLE PAD_GlitchData	: VitalGlitchDataType;
   VARIABLE Y_GlitchData	: VitalGlitchDataType;

   begin

      -------------------------
      --  Functionality Section
      -------------------------
      PAD_zd := VitalBUFIF0 (data => A_ipd,
              enable => EN_ipd);
      Y_zd := TO_X01(PAD_ipd);

      ----------------------
      --  Path Delay Section
      ----------------------
      VitalPathDelay01Z (
       OutSignal => PAD,
       GlitchData => PAD_GlitchData,
       OutSignalName => "PAD",
       OutTemp => PAD_zd,
       Paths => (0 => (A_ipd'last_event, VitalExtendToFillDelay(tpd_A_PAD), TRUE),
                 1 => (EN_ipd'last_event, VitalExtendToFillDelay(tpd_EN_PAD), TRUE)),
       Mode => OnEvent,
       Xon => Xon,
       MsgOn => MsgOn,
       MsgSeverity => WARNING,
       OutputMap => "UX01ZWLH-");
      VitalPathDelay01 (
       OutSignal => Y,
       GlitchData => Y_GlitchData,
       OutSignalName => "Y",
       OutTemp => Y_zd,
       Paths => (0 => (PAD_ipd'last_event, tpd_PAD_Y, TRUE)),
       Mode => OnEvent,
       Xon => Xon,
       MsgOn => MsgOn,
       MsgSeverity => WARNING);

end process;

end VITAL;

configuration CFG_BBCU16SMP_V5_VITAL of BBCU16SMP_V5 is
   for VITAL
   end for;
end CFG_BBCU16SMP_V5_VITAL;


----- CELL BBCU16SP_V5 -----
library IEEE;
use IEEE.STD_LOGIC_1164.all;
library IEEE;
use IEEE.VITAL_Timing.all;


-- entity declaration --
entity BBCU16SP_V5 is
   generic(
      TimingChecksOn: Boolean := True;
      InstancePath: STRING := "*";
      Xon: Boolean := True;
      MsgOn: Boolean := True;
      tpd_A_PAD                      :	VitalDelayType01 := (1 ps, 1 ps);
      tpd_EN_PAD                     :	VitalDelayType01z := 
               (1 ps, 1 ps, 1 ps, 1 ps, 1 ps, 1 ps);
      tpd_PAD_Y                      :	VitalDelayType01 := (1 ps, 1 ps);
      tipd_A                         :	VitalDelayType01 := (0 ps, 0 ps);
      tipd_EN                        :	VitalDelayType01 := (0 ps, 0 ps);
      tipd_PAD                       :	VitalDelayType01 := (0 ps, 0 ps));

   port(
      A                              :	in    STD_ULOGIC;
      EN                             :	in    STD_ULOGIC;
      PAD                            :	inout STD_ULOGIC;
      Y                              :	out   STD_ULOGIC);
attribute VITAL_LEVEL0 of BBCU16SP_V5 : entity is TRUE;
end BBCU16SP_V5;

-- architecture body --
library IEEE;
use IEEE.VITAL_Primitives.all;
library c35_IOLIBV5_4M;
use c35_IOLIBV5_4M.VTABLES.all;
architecture VITAL of BBCU16SP_V5 is
   attribute VITAL_LEVEL1 of VITAL : architecture is TRUE;

   SIGNAL A_ipd	 : STD_ULOGIC := 'X';
   SIGNAL EN_ipd	 : STD_ULOGIC := 'X';
   SIGNAL PAD_ipd	 : STD_ULOGIC := 'X';

begin

   ---------------------
   --  INPUT PATH DELAYs
   ---------------------
   WireDelay : block
   begin
   VitalWireDelay (A_ipd, A, tipd_A);
   VitalWireDelay (EN_ipd, EN, tipd_EN);
   VitalWireDelay (PAD_ipd, PAD, tipd_PAD);
   end block;
   --------------------
   --  BEHAVIOR SECTION
   --------------------
   VITALBehavior : process (A_ipd, EN_ipd, PAD_ipd)


   -- functionality results
   VARIABLE Results : STD_LOGIC_VECTOR(1 to 2) := (others => 'X');
   ALIAS PAD_zd : STD_LOGIC is Results(1);
   ALIAS Y_zd : STD_LOGIC is Results(2);

   -- output glitch detection variables
   VARIABLE PAD_GlitchData	: VitalGlitchDataType;
   VARIABLE Y_GlitchData	: VitalGlitchDataType;

   begin

      -------------------------
      --  Functionality Section
      -------------------------
      PAD_zd := VitalBUFIF0 (data => A_ipd,
              enable => EN_ipd);
      Y_zd := TO_X01(PAD_ipd);

      ----------------------
      --  Path Delay Section
      ----------------------
      VitalPathDelay01Z (
       OutSignal => PAD,
       GlitchData => PAD_GlitchData,
       OutSignalName => "PAD",
       OutTemp => PAD_zd,
       Paths => (0 => (A_ipd'last_event, VitalExtendToFillDelay(tpd_A_PAD), TRUE),
                 1 => (EN_ipd'last_event, VitalExtendToFillDelay(tpd_EN_PAD), TRUE)),
       Mode => OnEvent,
       Xon => Xon,
       MsgOn => MsgOn,
       MsgSeverity => WARNING,
       OutputMap => "UX01ZWLH-");
      VitalPathDelay01 (
       OutSignal => Y,
       GlitchData => Y_GlitchData,
       OutSignalName => "Y",
       OutTemp => Y_zd,
       Paths => (0 => (PAD_ipd'last_event, tpd_PAD_Y, TRUE)),
       Mode => OnEvent,
       Xon => Xon,
       MsgOn => MsgOn,
       MsgSeverity => WARNING);

end process;

end VITAL;

configuration CFG_BBCU16SP_V5_VITAL of BBCU16SP_V5 is
   for VITAL
   end for;
end CFG_BBCU16SP_V5_VITAL;


----- CELL BBCU24P_V5 -----
library IEEE;
use IEEE.STD_LOGIC_1164.all;
library IEEE;
use IEEE.VITAL_Timing.all;


-- entity declaration --
entity BBCU24P_V5 is
   generic(
      TimingChecksOn: Boolean := True;
      InstancePath: STRING := "*";
      Xon: Boolean := True;
      MsgOn: Boolean := True;
      tpd_A_PAD                      :	VitalDelayType01 := (1 ps, 1 ps);
      tpd_EN_PAD                     :	VitalDelayType01z := 
               (1 ps, 1 ps, 1 ps, 1 ps, 1 ps, 1 ps);
      tpd_PAD_Y                      :	VitalDelayType01 := (1 ps, 1 ps);
      tipd_A                         :	VitalDelayType01 := (0 ps, 0 ps);
      tipd_EN                        :	VitalDelayType01 := (0 ps, 0 ps);
      tipd_PAD                       :	VitalDelayType01 := (0 ps, 0 ps));

   port(
      A                              :	in    STD_ULOGIC;
      EN                             :	in    STD_ULOGIC;
      PAD                            :	inout STD_ULOGIC;
      Y                              :	out   STD_ULOGIC);
attribute VITAL_LEVEL0 of BBCU24P_V5 : entity is TRUE;
end BBCU24P_V5;

-- architecture body --
library IEEE;
use IEEE.VITAL_Primitives.all;
library c35_IOLIBV5_4M;
use c35_IOLIBV5_4M.VTABLES.all;
architecture VITAL of BBCU24P_V5 is
   attribute VITAL_LEVEL1 of VITAL : architecture is TRUE;

   SIGNAL A_ipd	 : STD_ULOGIC := 'X';
   SIGNAL EN_ipd	 : STD_ULOGIC := 'X';
   SIGNAL PAD_ipd	 : STD_ULOGIC := 'X';

begin

   ---------------------
   --  INPUT PATH DELAYs
   ---------------------
   WireDelay : block
   begin
   VitalWireDelay (A_ipd, A, tipd_A);
   VitalWireDelay (EN_ipd, EN, tipd_EN);
   VitalWireDelay (PAD_ipd, PAD, tipd_PAD);
   end block;
   --------------------
   --  BEHAVIOR SECTION
   --------------------
   VITALBehavior : process (A_ipd, EN_ipd, PAD_ipd)


   -- functionality results
   VARIABLE Results : STD_LOGIC_VECTOR(1 to 2) := (others => 'X');
   ALIAS PAD_zd : STD_LOGIC is Results(1);
   ALIAS Y_zd : STD_LOGIC is Results(2);

   -- output glitch detection variables
   VARIABLE PAD_GlitchData	: VitalGlitchDataType;
   VARIABLE Y_GlitchData	: VitalGlitchDataType;

   begin

      -------------------------
      --  Functionality Section
      -------------------------
      PAD_zd := VitalBUFIF0 (data => A_ipd,
              enable => EN_ipd);
      Y_zd := TO_X01(PAD_ipd);

      ----------------------
      --  Path Delay Section
      ----------------------
      VitalPathDelay01Z (
       OutSignal => PAD,
       GlitchData => PAD_GlitchData,
       OutSignalName => "PAD",
       OutTemp => PAD_zd,
       Paths => (0 => (A_ipd'last_event, VitalExtendToFillDelay(tpd_A_PAD), TRUE),
                 1 => (EN_ipd'last_event, VitalExtendToFillDelay(tpd_EN_PAD), TRUE)),
       Mode => OnEvent,
       Xon => Xon,
       MsgOn => MsgOn,
       MsgSeverity => WARNING,
       OutputMap => "UX01ZWLH-");
      VitalPathDelay01 (
       OutSignal => Y,
       GlitchData => Y_GlitchData,
       OutSignalName => "Y",
       OutTemp => Y_zd,
       Paths => (0 => (PAD_ipd'last_event, tpd_PAD_Y, TRUE)),
       Mode => OnEvent,
       Xon => Xon,
       MsgOn => MsgOn,
       MsgSeverity => WARNING);

end process;

end VITAL;

configuration CFG_BBCU24P_V5_VITAL of BBCU24P_V5 is
   for VITAL
   end for;
end CFG_BBCU24P_V5_VITAL;


----- CELL BBCU24SMP_V5 -----
library IEEE;
use IEEE.STD_LOGIC_1164.all;
library IEEE;
use IEEE.VITAL_Timing.all;


-- entity declaration --
entity BBCU24SMP_V5 is
   generic(
      TimingChecksOn: Boolean := True;
      InstancePath: STRING := "*";
      Xon: Boolean := True;
      MsgOn: Boolean := True;
      tpd_A_PAD                      :	VitalDelayType01 := (1 ps, 1 ps);
      tpd_EN_PAD                     :	VitalDelayType01z := 
               (1 ps, 1 ps, 1 ps, 1 ps, 1 ps, 1 ps);
      tpd_PAD_Y                      :	VitalDelayType01 := (1 ps, 1 ps);
      tipd_A                         :	VitalDelayType01 := (0 ps, 0 ps);
      tipd_EN                        :	VitalDelayType01 := (0 ps, 0 ps);
      tipd_PAD                       :	VitalDelayType01 := (0 ps, 0 ps));

   port(
      A                              :	in    STD_ULOGIC;
      EN                             :	in    STD_ULOGIC;
      PAD                            :	inout STD_ULOGIC;
      Y                              :	out   STD_ULOGIC);
attribute VITAL_LEVEL0 of BBCU24SMP_V5 : entity is TRUE;
end BBCU24SMP_V5;

-- architecture body --
library IEEE;
use IEEE.VITAL_Primitives.all;
library c35_IOLIBV5_4M;
use c35_IOLIBV5_4M.VTABLES.all;
architecture VITAL of BBCU24SMP_V5 is
   attribute VITAL_LEVEL1 of VITAL : architecture is TRUE;

   SIGNAL A_ipd	 : STD_ULOGIC := 'X';
   SIGNAL EN_ipd	 : STD_ULOGIC := 'X';
   SIGNAL PAD_ipd	 : STD_ULOGIC := 'X';

begin

   ---------------------
   --  INPUT PATH DELAYs
   ---------------------
   WireDelay : block
   begin
   VitalWireDelay (A_ipd, A, tipd_A);
   VitalWireDelay (EN_ipd, EN, tipd_EN);
   VitalWireDelay (PAD_ipd, PAD, tipd_PAD);
   end block;
   --------------------
   --  BEHAVIOR SECTION
   --------------------
   VITALBehavior : process (A_ipd, EN_ipd, PAD_ipd)


   -- functionality results
   VARIABLE Results : STD_LOGIC_VECTOR(1 to 2) := (others => 'X');
   ALIAS PAD_zd : STD_LOGIC is Results(1);
   ALIAS Y_zd : STD_LOGIC is Results(2);

   -- output glitch detection variables
   VARIABLE PAD_GlitchData	: VitalGlitchDataType;
   VARIABLE Y_GlitchData	: VitalGlitchDataType;

   begin

      -------------------------
      --  Functionality Section
      -------------------------
      PAD_zd := VitalBUFIF0 (data => A_ipd,
              enable => EN_ipd);
      Y_zd := TO_X01(PAD_ipd);

      ----------------------
      --  Path Delay Section
      ----------------------
      VitalPathDelay01Z (
       OutSignal => PAD,
       GlitchData => PAD_GlitchData,
       OutSignalName => "PAD",
       OutTemp => PAD_zd,
       Paths => (0 => (A_ipd'last_event, VitalExtendToFillDelay(tpd_A_PAD), TRUE),
                 1 => (EN_ipd'last_event, VitalExtendToFillDelay(tpd_EN_PAD), TRUE)),
       Mode => OnEvent,
       Xon => Xon,
       MsgOn => MsgOn,
       MsgSeverity => WARNING,
       OutputMap => "UX01ZWLH-");
      VitalPathDelay01 (
       OutSignal => Y,
       GlitchData => Y_GlitchData,
       OutSignalName => "Y",
       OutTemp => Y_zd,
       Paths => (0 => (PAD_ipd'last_event, tpd_PAD_Y, TRUE)),
       Mode => OnEvent,
       Xon => Xon,
       MsgOn => MsgOn,
       MsgSeverity => WARNING);

end process;

end VITAL;

configuration CFG_BBCU24SMP_V5_VITAL of BBCU24SMP_V5 is
   for VITAL
   end for;
end CFG_BBCU24SMP_V5_VITAL;


----- CELL BBCU24SP_V5 -----
library IEEE;
use IEEE.STD_LOGIC_1164.all;
library IEEE;
use IEEE.VITAL_Timing.all;


-- entity declaration --
entity BBCU24SP_V5 is
   generic(
      TimingChecksOn: Boolean := True;
      InstancePath: STRING := "*";
      Xon: Boolean := True;
      MsgOn: Boolean := True;
      tpd_A_PAD                      :	VitalDelayType01 := (1 ps, 1 ps);
      tpd_EN_PAD                     :	VitalDelayType01z := 
               (1 ps, 1 ps, 1 ps, 1 ps, 1 ps, 1 ps);
      tpd_PAD_Y                      :	VitalDelayType01 := (1 ps, 1 ps);
      tipd_A                         :	VitalDelayType01 := (0 ps, 0 ps);
      tipd_EN                        :	VitalDelayType01 := (0 ps, 0 ps);
      tipd_PAD                       :	VitalDelayType01 := (0 ps, 0 ps));

   port(
      A                              :	in    STD_ULOGIC;
      EN                             :	in    STD_ULOGIC;
      PAD                            :	inout STD_ULOGIC;
      Y                              :	out   STD_ULOGIC);
attribute VITAL_LEVEL0 of BBCU24SP_V5 : entity is TRUE;
end BBCU24SP_V5;

-- architecture body --
library IEEE;
use IEEE.VITAL_Primitives.all;
library c35_IOLIBV5_4M;
use c35_IOLIBV5_4M.VTABLES.all;
architecture VITAL of BBCU24SP_V5 is
   attribute VITAL_LEVEL1 of VITAL : architecture is TRUE;

   SIGNAL A_ipd	 : STD_ULOGIC := 'X';
   SIGNAL EN_ipd	 : STD_ULOGIC := 'X';
   SIGNAL PAD_ipd	 : STD_ULOGIC := 'X';

begin

   ---------------------
   --  INPUT PATH DELAYs
   ---------------------
   WireDelay : block
   begin
   VitalWireDelay (A_ipd, A, tipd_A);
   VitalWireDelay (EN_ipd, EN, tipd_EN);
   VitalWireDelay (PAD_ipd, PAD, tipd_PAD);
   end block;
   --------------------
   --  BEHAVIOR SECTION
   --------------------
   VITALBehavior : process (A_ipd, EN_ipd, PAD_ipd)


   -- functionality results
   VARIABLE Results : STD_LOGIC_VECTOR(1 to 2) := (others => 'X');
   ALIAS PAD_zd : STD_LOGIC is Results(1);
   ALIAS Y_zd : STD_LOGIC is Results(2);

   -- output glitch detection variables
   VARIABLE PAD_GlitchData	: VitalGlitchDataType;
   VARIABLE Y_GlitchData	: VitalGlitchDataType;

   begin

      -------------------------
      --  Functionality Section
      -------------------------
      PAD_zd := VitalBUFIF0 (data => A_ipd,
              enable => EN_ipd);
      Y_zd := TO_X01(PAD_ipd);

      ----------------------
      --  Path Delay Section
      ----------------------
      VitalPathDelay01Z (
       OutSignal => PAD,
       GlitchData => PAD_GlitchData,
       OutSignalName => "PAD",
       OutTemp => PAD_zd,
       Paths => (0 => (A_ipd'last_event, VitalExtendToFillDelay(tpd_A_PAD), TRUE),
                 1 => (EN_ipd'last_event, VitalExtendToFillDelay(tpd_EN_PAD), TRUE)),
       Mode => OnEvent,
       Xon => Xon,
       MsgOn => MsgOn,
       MsgSeverity => WARNING,
       OutputMap => "UX01ZWLH-");
      VitalPathDelay01 (
       OutSignal => Y,
       GlitchData => Y_GlitchData,
       OutSignalName => "Y",
       OutTemp => Y_zd,
       Paths => (0 => (PAD_ipd'last_event, tpd_PAD_Y, TRUE)),
       Mode => OnEvent,
       Xon => Xon,
       MsgOn => MsgOn,
       MsgSeverity => WARNING);

end process;

end VITAL;

configuration CFG_BBCU24SP_V5_VITAL of BBCU24SP_V5 is
   for VITAL
   end for;
end CFG_BBCU24SP_V5_VITAL;


----- CELL BBS1P_V5 -----
library IEEE;
use IEEE.STD_LOGIC_1164.all;
library IEEE;
use IEEE.VITAL_Timing.all;
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
