Kevin-Pottier/SOCN/TECH/AMS/vital/c35/c35_IOLIBV5_3M_Vcomponents.vhd

----------------------------------------------------------------
-- 
-- Created by the Synopsys Library Compiler 2000.11
-- FILE CONTENTS:    VITAL Component Package
-- DATE CREATED :    Thu Jun 27 17:09:16 2002
-- 
-- LIBRARY      :    c35_IOLIBV5_4M
-- DATE ENTERED :    $Date: 2001/10/30 09:43:45 $
-- REVISION     :    $Id: csx_IOLIBV5_3M.lib,v 1.2 2001/10/30 09:43:45 mbo Exp mbo $
-- TECHNOLOGY   :    cmos
-- TIME SCALE   :    1 ps
-- LOGIC SYSTEM :    IEEE-1164
-- NOTES        :    
--                   Owner: austriamicrosystems AG  HIT-Kit: Digital
-- HISTORY      :
-- 
----------------------------------------------------------------

library IEEE;
use IEEE.STD_LOGIC_1164.all;
-- synopsys translate_off

library IEEE;
use IEEE.VITAL_Timing.all;
-- synopsys translate_on

package VCOMPONENTS is

constant DefaultTimingChecksOn : Boolean := True;
constant DefaultXon : Boolean := True;
constant DefaultMsgOn : Boolean := True;

----- Component BBC1P_V5 -----
component BBC1P_V5
-- synopsys translate_off
   generic(
      TimingChecksOn: Boolean := DefaultTimingChecksOn;
      InstancePath: STRING := "*";
      Xon: Boolean := DefaultXon;
      MsgOn: Boolean := DefaultMsgOn;
      tpd_A_PAD                      :	VitalDelayType01 := (1 ps, 1 ps);
      tpd_EN_PAD                     :	VitalDelayType01z := 
               (1 ps, 1 ps, 1 ps, 1 ps, 1 ps, 1 ps);
      tpd_PAD_Y                      :	VitalDelayType01 := (1 ps, 1 ps);
      tipd_A                         :	VitalDelayType01 := (0 ps, 0 ps);
      tipd_EN                        :	VitalDelayType01 := (0 ps, 0 ps);
      tipd_PAD                       :	VitalDelayType01 := (0 ps, 0 ps));

-- synopsys translate_on
   port(
      A                              :	in    STD_ULOGIC;
      EN                             :	in    STD_ULOGIC;
      PAD                            :	inout STD_ULOGIC;
      Y                              :	out   STD_ULOGIC);
end component;


----- Component BBC4P_V5 -----
component BBC4P_V5
-- synopsys translate_off
   generic(
      TimingChecksOn: Boolean := DefaultTimingChecksOn;
      InstancePath: STRING := "*";
      Xon: Boolean := DefaultXon;
      MsgOn: Boolean := DefaultMsgOn;
      tpd_A_PAD                      :	VitalDelayType01 := (1 ps, 1 ps);
      tpd_EN_PAD                     :	VitalDelayType01z := 
               (1 ps, 1 ps, 1 ps, 1 ps, 1 ps, 1 ps);
      tpd_PAD_Y                      :	VitalDelayType01 := (1 ps, 1 ps);
      tipd_A                         :	VitalDelayType01 := (0 ps, 0 ps);
      tipd_EN                        :	VitalDelayType01 := (0 ps, 0 ps);
      tipd_PAD                       :	VitalDelayType01 := (0 ps, 0 ps));

-- synopsys translate_on
   port(
      A                              :	in    STD_ULOGIC;
      EN                             :	in    STD_ULOGIC;
      PAD                            :	inout STD_ULOGIC;
      Y                              :	out   STD_ULOGIC);
end component;


----- Component BBC4SMP_V5 -----
component BBC4SMP_V5
-- synopsys translate_off
   generic(
      TimingChecksOn: Boolean := DefaultTimingChecksOn;
      InstancePath: STRING := "*";
      Xon: Boolean := DefaultXon;
      MsgOn: Boolean := DefaultMsgOn;
      tpd_A_PAD                      :	VitalDelayType01 := (1 ps, 1 ps);
      tpd_EN_PAD                     :	VitalDelayType01z := 
               (1 ps, 1 ps, 1 ps, 1 ps, 1 ps, 1 ps);
      tpd_PAD_Y                      :	VitalDelayType01 := (1 ps, 1 ps);
      tipd_A                         :	VitalDelayType01 := (0 ps, 0 ps);
      tipd_EN                        :	VitalDelayType01 := (0 ps, 0 ps);
      tipd_PAD                       :	VitalDelayType01 := (0 ps, 0 ps));

-- synopsys translate_on
   port(
      A                              :	in    STD_ULOGIC;
      EN                             :	in    STD_ULOGIC;
      PAD                            :	inout STD_ULOGIC;
      Y                              :	out   STD_ULOGIC);
end component;


----- Component BBC8P_V5 -----
component BBC8P_V5
-- synopsys translate_off
   generic(
      TimingChecksOn: Boolean := DefaultTimingChecksOn;
      InstancePath: STRING := "*";
      Xon: Boolean := DefaultXon;
      MsgOn: Boolean := DefaultMsgOn;
      tpd_A_PAD                      :	VitalDelayType01 := (1 ps, 1 ps);
      tpd_EN_PAD                     :	VitalDelayType01z := 
               (1 ps, 1 ps, 1 ps, 1 ps, 1 ps, 1 ps);
      tpd_PAD_Y                      :	VitalDelayType01 := (1 ps, 1 ps);
      tipd_A                         :	VitalDelayType01 := (0 ps, 0 ps);
      tipd_EN                        :	VitalDelayType01 := (0 ps, 0 ps);
      tipd_PAD                       :	VitalDelayType01 := (0 ps, 0 ps));

-- synopsys translate_on
   port(
      A                              :	in    STD_ULOGIC;
      EN                             :	in    STD_ULOGIC;
      PAD                            :	inout STD_ULOGIC;
      Y                              :	out   STD_ULOGIC);
end component;


----- Component BBC8SMP_V5 -----
component BBC8SMP_V5
-- synopsys translate_off
   generic(
      TimingChecksOn: Boolean := DefaultTimingChecksOn;
      InstancePath: STRING := "*";
      Xon: Boolean := DefaultXon;
      MsgOn: Boolean := DefaultMsgOn;
      tpd_A_PAD                      :	VitalDelayType01 := (1 ps, 1 ps);
      tpd_EN_PAD                     :	VitalDelayType01z := 
               (1 ps, 1 ps, 1 ps, 1 ps, 1 ps, 1 ps);
      tpd_PAD_Y                      :	VitalDelayType01 := (1 ps, 1 ps);
      tipd_A                         :	VitalDelayType01 := (0 ps, 0 ps);
      tipd_EN                        :	VitalDelayType01 := (0 ps, 0 ps);
      tipd_PAD                       :	VitalDelayType01 := (0 ps, 0 ps));

-- synopsys translate_on
   port(
      A                              :	in    STD_ULOGIC;
      EN                             :	in    STD_ULOGIC;
      PAD                            :	inout STD_ULOGIC;
      Y                              :	out   STD_ULOGIC);
end component;


----- Component BBC8SP_V5 -----
component BBC8SP_V5
-- synopsys translate_off
   generic(
      TimingChecksOn: Boolean := DefaultTimingChecksOn;
      InstancePath: STRING := "*";
      Xon: Boolean := DefaultXon;
      MsgOn: Boolean := DefaultMsgOn;
      tpd_A_PAD                      :	VitalDelayType01 := (1 ps, 1 ps);
      tpd_EN_PAD                     :	VitalDelayType01z := 
               (1 ps, 1 ps, 1 ps, 1 ps, 1 ps, 1 ps);
      tpd_PAD_Y                      :	VitalDelayType01 := (1 ps, 1 ps);
      tipd_A                         :	VitalDelayType01 := (0 ps, 0 ps);
      tipd_EN                        :	VitalDelayType01 := (0 ps, 0 ps);
      tipd_PAD                       :	VitalDelayType01 := (0 ps, 0 ps));

-- synopsys translate_on
   port(
      A                              :	in    STD_ULOGIC;
      EN                             :	in    STD_ULOGIC;
      PAD                            :	inout STD_ULOGIC;
      Y                              :	out   STD_ULOGIC);
end component;


----- Component BBC16P_V5 -----
component BBC16P_V5
-- synopsys translate_off
   generic(
      TimingChecksOn: Boolean := DefaultTimingChecksOn;
      InstancePath: STRING := "*";
      Xon: Boolean := DefaultXon;
      MsgOn: Boolean := DefaultMsgOn;
      tpd_A_PAD                      :	VitalDelayType01 := (1 ps, 1 ps);
      tpd_EN_PAD                     :	VitalDelayType01z := 
               (1 ps, 1 ps, 1 ps, 1 ps, 1 ps, 1 ps);
      tpd_PAD_Y                      :	VitalDelayType01 := (1 ps, 1 ps);
      tipd_A                         :	VitalDelayType01 := (0 ps, 0 ps);
      tipd_EN                        :	VitalDelayType01 := (0 ps, 0 ps);
      tipd_PAD                       :	VitalDelayType01 := (0 ps, 0 ps));

-- synopsys translate_on
   port(
      A                              :	in    STD_ULOGIC;
      EN                             :	in    STD_ULOGIC;
      PAD                            :	inout STD_ULOGIC;
      Y                              :	out   STD_ULOGIC);
end component;


----- Component BBC16SMP_V5 -----
component BBC16SMP_V5
-- synopsys translate_off
   generic(
      TimingChecksOn: Boolean := DefaultTimingChecksOn;
      InstancePath: STRING := "*";
      Xon: Boolean := DefaultXon;
      MsgOn: Boolean := DefaultMsgOn;
      tpd_A_PAD                      :	VitalDelayType01 := (1 ps, 1 ps);
      tpd_EN_PAD                     :	VitalDelayType01z := 
               (1 ps, 1 ps, 1 ps, 1 ps, 1 ps, 1 ps);
      tpd_PAD_Y                      :	VitalDelayType01 := (1 ps, 1 ps);
      tipd_A                         :	VitalDelayType01 := (0 ps, 0 ps);
      tipd_EN                        :	VitalDelayType01 := (0 ps, 0 ps);
      tipd_PAD                       :	VitalDelayType01 := (0 ps, 0 ps));

-- synopsys translate_on
   port(
      A                              :	in    STD_ULOGIC;
      EN                             :	in    STD_ULOGIC;
      PAD                            :	inout STD_ULOGIC;
      Y                              :	out   STD_ULOGIC);
end component;


----- Component BBC16SP_V5 -----
component BBC16SP_V5
-- synopsys translate_off
   generic(
      TimingChecksOn: Boolean := DefaultTimingChecksOn;
      InstancePath: STRING := "*";
      Xon: Boolean := DefaultXon;
      MsgOn: Boolean := DefaultMsgOn;
      tpd_A_PAD                      :	VitalDelayType01 := (1 ps, 1 ps);
      tpd_EN_PAD                     :	VitalDelayType01z := 
               (1 ps, 1 ps, 1 ps, 1 ps, 1 ps, 1 ps);
      tpd_PAD_Y                      :	VitalDelayType01 := (1 ps, 1 ps);
      tipd_A                         :	VitalDelayType01 := (0 ps, 0 ps);
      tipd_EN                        :	VitalDelayType01 := (0 ps, 0 ps);
      tipd_PAD                       :	VitalDelayType01 := (0 ps, 0 ps));

-- synopsys translate_on
   port(
      A                              :	in    STD_ULOGIC;
      EN                             :	in    STD_ULOGIC;
      PAD                            :	inout STD_ULOGIC;
      Y                              :	out   STD_ULOGIC);
end component;


----- Component BBC24P_V5 -----
component BBC24P_V5
-- synopsys translate_off
   generic(
      TimingChecksOn: Boolean := DefaultTimingChecksOn;
      InstancePath: STRING := "*";
      Xon: Boolean := DefaultXon;
      MsgOn: Boolean := DefaultMsgOn;
      tpd_A_PAD                      :	VitalDelayType01 := (1 ps, 1 ps);
      tpd_EN_PAD                     :	VitalDelayType01z := 
               (1 ps, 1 ps, 1 ps, 1 ps, 1 ps, 1 ps);
      tpd_PAD_Y                      :	VitalDelayType01 := (1 ps, 1 ps);
      tipd_A                         :	VitalDelayType01 := (0 ps, 0 ps);
      tipd_EN                        :	VitalDelayType01 := (0 ps, 0 ps);
      tipd_PAD                       :	VitalDelayType01 := (0 ps, 0 ps));

-- synopsys translate_on
   port(
      A                              :	in    STD_ULOGIC;
      EN                             :	in    STD_ULOGIC;
      PAD                            :	inout STD_ULOGIC;
      Y                              :	out   STD_ULOGIC);
end component;


----- Component BBC24SMP_V5 -----
component BBC24SMP_V5
-- synopsys translate_off
   generic(
      TimingChecksOn: Boolean := DefaultTimingChecksOn;
      InstancePath: STRING := "*";
      Xon: Boolean := DefaultXon;
      MsgOn: Boolean := DefaultMsgOn;
      tpd_A_PAD                      :	VitalDelayType01 := (1 ps, 1 ps);
      tpd_EN_PAD                     :	VitalDelayType01z := 
               (1 ps, 1 ps, 1 ps, 1 ps, 1 ps, 1 ps);
      tpd_PAD_Y                      :	VitalDelayType01 := (1 ps, 1 ps);
      tipd_A                         :	VitalDelayType01 := (0 ps, 0 ps);
      tipd_EN                        :	VitalDelayType01 := (0 ps, 0 ps);
      tipd_PAD                       :	VitalDelayType01 := (0 ps, 0 ps));

-- synopsys translate_on
   port(
      A                              :	in    STD_ULOGIC;
      EN                             :	in    STD_ULOGIC;
      PAD                            :	inout STD_ULOGIC;
      Y                              :	out   STD_ULOGIC);
end component;


----- Component BBC24SP_V5 -----
component BBC24SP_V5
-- synopsys translate_off
   generic(
      TimingChecksOn: Boolean := DefaultTimingChecksOn;
      InstancePath: STRING := "*";
      Xon: Boolean := DefaultXon;
      MsgOn: Boolean := DefaultMsgOn;
      tpd_A_PAD                      :	VitalDelayType01 := (1 ps, 1 ps);
      tpd_EN_PAD                     :	VitalDelayType01z := 
               (1 ps, 1 ps, 1 ps, 1 ps, 1 ps, 1 ps);
      tpd_PAD_Y                      :	VitalDelayType01 := (1 ps, 1 ps);
      tipd_A                         :	VitalDelayType01 := (0 ps, 0 ps);
      tipd_EN                        :	VitalDelayType01 := (0 ps, 0 ps);
      tipd_PAD                       :	VitalDelayType01 := (0 ps, 0 ps));

-- synopsys translate_on
   port(
      A                              :	in    STD_ULOGIC;
      EN                             :	in    STD_ULOGIC;
      PAD                            :	inout STD_ULOGIC;
      Y                              :	out   STD_ULOGIC);
end component;


----- Component BBCD1P_V5 -----
component BBCD1P_V5
-- synopsys translate_off
   generic(
      TimingChecksOn: Boolean := DefaultTimingChecksOn;
      InstancePath: STRING := "*";
      Xon: Boolean := DefaultXon;
      MsgOn: Boolean := DefaultMsgOn;
      tpd_A_PAD                      :	VitalDelayType01 := (1 ps, 1 ps);
      tpd_EN_PAD                     :	VitalDelayType01z := 
               (1 ps, 1 ps, 1 ps, 1 ps, 1 ps, 1 ps);
      tpd_PAD_Y                      :	VitalDelayType01 := (1 ps, 1 ps);
      tipd_A                         :	VitalDelayType01 := (0 ps, 0 ps);
      tipd_EN                        :	VitalDelayType01 := (0 ps, 0 ps);
      tipd_PAD                       :	VitalDelayType01 := (0 ps, 0 ps));

-- synopsys translate_on
   port(
      A                              :	in    STD_ULOGIC;
      EN                             :	in    STD_ULOGIC;
      PAD                            :	inout STD_ULOGIC;
      Y                              :	out   STD_ULOGIC);
end component;


----- Component BBCD4P_V5 -----
component BBCD4P_V5
-- synopsys translate_off
   generic(
      TimingChecksOn: Boolean := DefaultTimingChecksOn;
      InstancePath: STRING := "*";
      Xon: Boolean := DefaultXon;
      MsgOn: Boolean := DefaultMsgOn;
      tpd_A_PAD                      :	VitalDelayType01 := (1 ps, 1 ps);
      tpd_EN_PAD                     :	VitalDelayType01z := 
               (1 ps, 1 ps, 1 ps, 1 ps, 1 ps, 1 ps);
      tpd_PAD_Y                      :	VitalDelayType01 := (1 ps, 1 ps);
      tipd_A                         :	VitalDelayType01 := (0 ps, 0 ps);
      tipd_EN                        :	VitalDelayType01 := (0 ps, 0 ps);
      tipd_PAD                       :	VitalDelayType01 := (0 ps, 0 ps));

-- synopsys translate_on
   port(
      A                              :	in    STD_ULOGIC;
      EN                             :	in    STD_ULOGIC;
      PAD                            :	inout STD_ULOGIC;
      Y                              :	out   STD_ULOGIC);
end component;


----- Component BBCD4SMP_V5 -----
component BBCD4SMP_V5
-- synopsys translate_off
   generic(
      TimingChecksOn: Boolean := DefaultTimingChecksOn;
      InstancePath: STRING := "*";
      Xon: Boolean := DefaultXon;
      MsgOn: Boolean := DefaultMsgOn;
      tpd_A_PAD                      :	VitalDelayType01 := (1 ps, 1 ps);
      tpd_EN_PAD                     :	VitalDelayType01z := 
               (1 ps, 1 ps, 1 ps, 1 ps, 1 ps, 1 ps);
      tpd_PAD_Y                      :	VitalDelayType01 := (1 ps, 1 ps);
      tipd_A                         :	VitalDelayType01 := (0 ps, 0 ps);
      tipd_EN                        :	VitalDelayType01 := (0 ps, 0 ps);
      tipd_PAD                       :	VitalDelayType01 := (0 ps, 0 ps));

-- synopsys translate_on
   port(
      A                              :	in    STD_ULOGIC;
      EN                             :	in    STD_ULOGIC;
      PAD                            :	inout STD_ULOGIC;
      Y                              :	out   STD_ULOGIC);
end component;


----- Component BBCD8P_V5 -----
component BBCD8P_V5
-- synopsys translate_off
   generic(
      TimingChecksOn: Boolean := DefaultTimingChecksOn;
      InstancePath: STRING := "*";
      Xon: Boolean := DefaultXon;
      MsgOn: Boolean := DefaultMsgOn;
      tpd_A_PAD                      :	VitalDelayType01 := (1 ps, 1 ps);
      tpd_EN_PAD                     :	VitalDelayType01z := 
               (1 ps, 1 ps, 1 ps, 1 ps, 1 ps, 1 ps);
      tpd_PAD_Y                      :	VitalDelayType01 := (1 ps, 1 ps);
      tipd_A                         :	VitalDelayType01 := (0 ps, 0 ps);
      tipd_EN                        :	VitalDelayType01 := (0 ps, 0 ps);
      tipd_PAD                       :	VitalDelayType01 := (0 ps, 0 ps));

-- synopsys translate_on
   port(
      A                              :	in    STD_ULOGIC;
      EN                             :	in    STD_ULOGIC;
      PAD                            :	inout STD_ULOGIC;
      Y                              :	out   STD_ULOGIC);
end component;


----- Component BBCD8SMP_V5 -----
component BBCD8SMP_V5
-- synopsys translate_off
   generic(
      TimingChecksOn: Boolean := DefaultTimingChecksOn;
      InstancePath: STRING := "*";
      Xon: Boolean := DefaultXon;
      MsgOn: Boolean := DefaultMsgOn;
      tpd_A_PAD                      :	VitalDelayType01 := (1 ps, 1 ps);
      tpd_EN_PAD                     :	VitalDelayType01z := 
               (1 ps, 1 ps, 1 ps, 1 ps, 1 ps, 1 ps);
      tpd_PAD_Y                      :	VitalDelayType01 := (1 ps, 1 ps);
      tipd_A                         :	VitalDelayType01 := (0 ps, 0 ps);
      tipd_EN                        :	VitalDelayType01 := (0 ps, 0 ps);
      tipd_PAD                       :	VitalDelayType01 := (0 ps, 0 ps));

-- synopsys translate_on
   port(
      A                              :	in    STD_ULOGIC;
      EN                             :	in    STD_ULOGIC;
      PAD                            :	inout STD_ULOGIC;
      Y                              :	out   STD_ULOGIC);
end component;


----- Component BBCD8SP_V5 -----
component BBCD8SP_V5
-- synopsys translate_off
   generic(
      TimingChecksOn: Boolean := DefaultTimingChecksOn;
      InstancePath: STRING := "*";
      Xon: Boolean := DefaultXon;
      MsgOn: Boolean := DefaultMsgOn;
      tpd_A_PAD                      :	VitalDelayType01 := (1 ps, 1 ps);
      tpd_EN_PAD                     :	VitalDelayType01z := 
               (1 ps, 1 ps, 1 ps, 1 ps, 1 ps, 1 ps);
      tpd_PAD_Y                      :	VitalDelayType01 := (1 ps, 1 ps);
      tipd_A                         :	VitalDelayType01 := (0 ps, 0 ps);
      tipd_EN                        :	VitalDelayType01 := (0 ps, 0 ps);
      tipd_PAD                       :	VitalDelayType01 := (0 ps, 0 ps));

-- synopsys translate_on
   port(
      A                              :	in    STD_ULOGIC;
      EN                             :	in    STD_ULOGIC;
      PAD                            :	inout STD_ULOGIC;
      Y                              :	out   STD_ULOGIC);
end component;


----- Component BBCD16P_V5 -----
component BBCD16P_V5
-- synopsys translate_off
   generic(
      TimingChecksOn: Boolean := DefaultTimingChecksOn;
      InstancePath: STRING := "*";
      Xon: Boolean := DefaultXon;
      MsgOn: Boolean := DefaultMsgOn;
      tpd_A_PAD                      :	VitalDelayType01 := (1 ps, 1 ps);
      tpd_EN_PAD                     :	VitalDelayType01z := 
               (1 ps, 1 ps, 1 ps, 1 ps, 1 ps, 1 ps);
      tpd_PAD_Y                      :	VitalDelayType01 := (1 ps, 1 ps);
      tipd_A                         :	VitalDelayType01 := (0 ps, 0 ps);
      tipd_EN                        :	VitalDelayType01 := (0 ps, 0 ps);
      tipd_PAD                       :	VitalDelayType01 := (0 ps, 0 ps));

-- synopsys translate_on
   port(
      A                              :	in    STD_ULOGIC;
      EN                             :	in    STD_ULOGIC;
      PAD                            :	inout STD_ULOGIC;
      Y                              :	out   STD_ULOGIC);
end component;


----- Component BBCD16SMP_V5 -----
component BBCD16SMP_V5
-- synopsys translate_off
   generic(
      TimingChecksOn: Boolean := DefaultTimingChecksOn;
      InstancePath: STRING := "*";
      Xon: Boolean := DefaultXon;
      MsgOn: Boolean := DefaultMsgOn;
      tpd_A_PAD                      :	VitalDelayType01 := (1 ps, 1 ps);
      tpd_EN_PAD                     :	VitalDelayType01z := 
               (1 ps, 1 ps, 1 ps, 1 ps, 1 ps, 1 ps);
      tpd_PAD_Y                      :	VitalDelayType01 := (1 ps, 1 ps);
      tipd_A                         :	VitalDelayType01 := (0 ps, 0 ps);
      tipd_EN                        :	VitalDelayType01 := (0 ps, 0 ps);
      tipd_PAD                       :	VitalDelayType01 := (0 ps, 0 ps));

-- synopsys translate_on
   port(
      A                              :	in    STD_ULOGIC;
      EN                             :	in    STD_ULOGIC;
      PAD                            :	inout STD_ULOGIC;
      Y                              :	out   STD_ULOGIC);
end component;


----- Component BBCD16SP_V5 -----
component BBCD16SP_V5
-- synopsys translate_off
   generic(
      TimingChecksOn: Boolean := DefaultTimingChecksOn;
      InstancePath: STRING := "*";
      Xon: Boolean := DefaultXon;
      MsgOn: Boolean := DefaultMsgOn;
      tpd_A_PAD                      :	VitalDelayType01 := (1 ps, 1 ps);
      tpd_EN_PAD                     :	VitalDelayType01z := 
               (1 ps, 1 ps, 1 ps, 1 ps, 1 ps, 1 ps);
      tpd_PAD_Y                      :	VitalDelayType01 := (1 ps, 1 ps);
      tipd_A                         :	VitalDelayType01 := (0 ps, 0 ps);
      tipd_EN                        :	VitalDelayType01 := (0 ps, 0 ps);
      tipd_PAD                       :	VitalDelayType01 := (0 ps, 0 ps));

-- synopsys translate_on
   port(
      A                              :	in    STD_ULOGIC;
      EN                             :	in    STD_ULOGIC;
      PAD                            :	inout STD_ULOGIC;
      Y                              :	out   STD_ULOGIC);
end component;


----- Component BBCD24P_V5 -----
component BBCD24P_V5
-- synopsys translate_off
   generic(
      TimingChecksOn: Boolean := DefaultTimingChecksOn;
      InstancePath: STRING := "*";
      Xon: Boolean := DefaultXon;
      MsgOn: Boolean := DefaultMsgOn;
      tpd_A_PAD                      :	VitalDelayType01 := (1 ps, 1 ps);
      tpd_EN_PAD                     :	VitalDelayType01z := 
               (1 ps, 1 ps, 1 ps, 1 ps, 1 ps, 1 ps);
      tpd_PAD_Y                      :	VitalDelayType01 := (1 ps, 1 ps);
      tipd_A                         :	VitalDelayType01 := (0 ps, 0 ps);
      tipd_EN                        :	VitalDelayType01 := (0 ps, 0 ps);
      tipd_PAD                       :	VitalDelayType01 := (0 ps, 0 ps));

-- synopsys translate_on
   port(
      A                              :	in    STD_ULOGIC;
      EN                             :	in    STD_ULOGIC;
      PAD                            :	inout STD_ULOGIC;
      Y                              :	out   STD_ULOGIC);
end component;


----- Component BBCD24SMP_V5 -----
component BBCD24SMP_V5
-- synopsys translate_off
   generic(
      TimingChecksOn: Boolean := DefaultTimingChecksOn;
      InstancePath: STRING := "*";
      Xon: Boolean := DefaultXon;
      MsgOn: Boolean := DefaultMsgOn;
      tpd_A_PAD                      :	VitalDelayType01 := (1 ps, 1 ps);
      tpd_EN_PAD                     :	VitalDelayType01z := 
               (1 ps, 1 ps, 1 ps, 1 ps, 1 ps, 1 ps);
      tpd_PAD_Y                      :	VitalDelayType01 := (1 ps, 1 ps);
      tipd_A                         :	VitalDelayType01 := (0 ps, 0 ps);
      tipd_EN                        :	VitalDelayType01 := (0 ps, 0 ps);
      tipd_PAD                       :	VitalDelayType01 := (0 ps, 0 ps));

-- synopsys translate_on
   port(
      A                              :	in    STD_ULOGIC;
      EN                             :	in    STD_ULOGIC;
      PAD                            :	inout STD_ULOGIC;
      Y                              :	out   STD_ULOGIC);
end component;


----- Component BBCD24SP_V5 -----
component BBCD24SP_V5
-- synopsys translate_off
   generic(
      TimingChecksOn: Boolean := DefaultTimingChecksOn;
      InstancePath: STRING := "*";
      Xon: Boolean := DefaultXon;
      MsgOn: Boolean := DefaultMsgOn;
      tpd_A_PAD                      :	VitalDelayType01 := (1 ps, 1 ps);
      tpd_EN_PAD                     :	VitalDelayType01z := 
               (1 ps, 1 ps, 1 ps, 1 ps, 1 ps, 1 ps);
      tpd_PAD_Y                      :	VitalDelayType01 := (1 ps, 1 ps);
      tipd_A                         :	VitalDelayType01 := (0 ps, 0 ps);
      tipd_EN                        :	VitalDelayType01 := (0 ps, 0 ps);
      tipd_PAD                       :	VitalDelayType01 := (0 ps, 0 ps));

-- synopsys translate_on
   port(
      A                              :	in    STD_ULOGIC;
      EN                             :	in    STD_ULOGIC;
      PAD                            :	inout STD_ULOGIC;
      Y                              :	out   STD_ULOGIC);
end component;


----- Component BBCU1P_V5 -----
component BBCU1P_V5
-- synopsys translate_off
   generic(
      TimingChecksOn: Boolean := DefaultTimingChecksOn;
      InstancePath: STRING := "*";
      Xon: Boolean := DefaultXon;
      MsgOn: Boolean := DefaultMsgOn;
      tpd_A_PAD                      :	VitalDelayType01 := (1 ps, 1 ps);
      tpd_EN_PAD                     :	VitalDelayType01z := 
               (1 ps, 1 ps, 1 ps, 1 ps, 1 ps, 1 ps);
      tpd_PAD_Y                      :	VitalDelayType01 := (1 ps, 1 ps);
      tipd_A                         :	VitalDelayType01 := (0 ps, 0 ps);
      tipd_EN                        :	VitalDelayType01 := (0 ps, 0 ps);
      tipd_PAD                       :	VitalDelayType01 := (0 ps, 0 ps));

-- synopsys translate_on
   port(
      A                              :	in    STD_ULOGIC;
      EN                             :	in    STD_ULOGIC;
      PAD                            :	inout STD_ULOGIC;
      Y                              :	out   STD_ULOGIC);
end component;


----- Component BBCU4P_V5 -----
component BBCU4P_V5
-- synopsys translate_off
   generic(
      TimingChecksOn: Boolean := DefaultTimingChecksOn;
      InstancePath: STRING := "*";
      Xon: Boolean := DefaultXon;
      MsgOn: Boolean := DefaultMsgOn;
      tpd_A_PAD                      :	VitalDelayType01 := (1 ps, 1 ps);
      tpd_EN_PAD                     :	VitalDelayType01z := 
               (1 ps, 1 ps, 1 ps, 1 ps, 1 ps, 1 ps);
      tpd_PAD_Y                      :	VitalDelayType01 := (1 ps, 1 ps);
      tipd_A                         :	VitalDelayType01 := (0 ps, 0 ps);
      tipd_EN                        :	VitalDelayType01 := (0 ps, 0 ps);
      tipd_PAD                       :	VitalDelayType01 := (0 ps, 0 ps));

-- synopsys translate_on
   port(
      A                              :	in    STD_ULOGIC;
      EN                             :	in    STD_ULOGIC;
      PAD                            :	inout STD_ULOGIC;
      Y                              :	out   STD_ULOGIC);
end component;


----- Component BBCU4SMP_V5 -----
component BBCU4SMP_V5
-- synopsys translate_off
   generic(
      TimingChecksOn: Boolean := DefaultTimingChecksOn;
      InstancePath: STRING := "*";
      Xon: Boolean := DefaultXon;
      MsgOn: Boolean := DefaultMsgOn;
      tpd_A_PAD                      :	VitalDelayType01 := (1 ps, 1 ps);
      tpd_EN_PAD                     :	VitalDelayType01z := 
               (1 ps, 1 ps, 1 ps, 1 ps, 1 ps, 1 ps);
      tpd_PAD_Y                      :	VitalDelayType01 := (1 ps, 1 ps);
      tipd_A                         :	VitalDelayType01 := (0 ps, 0 ps);
      tipd_EN                        :	VitalDelayType01 := (0 ps, 0 ps);
      tipd_PAD                       :	VitalDelayType01 := (0 ps, 0 ps));

-- synopsys translate_on
   port(
      A                              :	in    STD_ULOGIC;
      EN                             :	in    STD_ULOGIC;
      PAD                            :	inout STD_ULOGIC;
      Y                              :	out   STD_ULOGIC);
end component;


----- Component BBCU8P_V5 -----
component BBCU8P_V5
-- synopsys translate_off
   generic(
      TimingChecksOn: Boolean := DefaultTimingChecksOn;
      InstancePath: STRING := "*";
      Xon: Boolean := DefaultXon;
      MsgOn: Boolean := DefaultMsgOn;
      tpd_A_PAD                      :	VitalDelayType01 := (1 ps, 1 ps);
      tpd_EN_PAD                     :	VitalDelayType01z := 
               (1 ps, 1 ps, 1 ps, 1 ps, 1 ps, 1 ps);
      tpd_PAD_Y                      :	VitalDelayType01 := (1 ps, 1 ps);
      tipd_A                         :	VitalDelayType01 := (0 ps, 0 ps);
      tipd_EN                        :	VitalDelayType01 := (0 ps, 0 ps);
      tipd_PAD                       :	VitalDelayType01 := (0 ps, 0 ps));

-- synopsys translate_on
   port(
      A                              :	in    STD_ULOGIC;
      EN                             :	in    STD_ULOGIC;
      PAD                            :	inout STD_ULOGIC;
      Y                              :	out   STD_ULOGIC);
end component;


----- Component BBCU8SMP_V5 -----
component BBCU8SMP_V5
-- synopsys translate_off
   generic(
      TimingChecksOn: Boolean := DefaultTimingChecksOn;
      InstancePath: STRING := "*";
      Xon: Boolean := DefaultXon;
      MsgOn: Boolean := DefaultMsgOn;
      tpd_A_PAD                      :	VitalDelayType01 := (1 ps, 1 ps);
      tpd_EN_PAD                     :	VitalDelayType01z := 
               (1 ps, 1 ps, 1 ps, 1 ps, 1 ps, 1 ps);
      tpd_PAD_Y                      :	VitalDelayType01 := (1 ps, 1 ps);
      tipd_A                         :	VitalDelayType01 := (0 ps, 0 ps);
      tipd_EN                        :	VitalDelayType01 := (0 ps, 0 ps);
      tipd_PAD                       :	VitalDelayType01 := (0 ps, 0 ps));

-- synopsys translate_on
   port(
      A                              :	in    STD_ULOGIC;
      EN                             :	in    STD_ULOGIC;
      PAD                            :	inout STD_ULOGIC;
      Y                              :	out   STD_ULOGIC);
end component;


----- Component BBCU8SP_V5 -----
component BBCU8SP_V5
-- synopsys translate_off
   generic(
      TimingChecksOn: Boolean := DefaultTimingChecksOn;
      InstancePath: STRING := "*";
      Xon: Boolean := DefaultXon;
      MsgOn: Boolean := DefaultMsgOn;
      tpd_A_PAD                      :	VitalDelayType01 := (1 ps, 1 ps);
      tpd_EN_PAD                     :	VitalDelayType01z := 
               (1 ps, 1 ps, 1 ps, 1 ps, 1 ps, 1 ps);
      tpd_PAD_Y                      :	VitalDelayType01 := (1 ps, 1 ps);
      tipd_A                         :	VitalDelayType01 := (0 ps, 0 ps);
      tipd_EN                        :	VitalDelayType01 := (0 ps, 0 ps);
      tipd_PAD                       :	VitalDelayType01 := (0 ps, 0 ps));

-- synopsys translate_on
   port(
      A                              :	in    STD_ULOGIC;
      EN                             :	in    STD_ULOGIC;
      PAD                            :	inout STD_ULOGIC;
      Y                              :	out   STD_ULOGIC);
end component;


----- Component BBCU16P_V5 -----
component BBCU16P_V5
-- synopsys translate_off
   generic(
      TimingChecksOn: Boolean := DefaultTimingChecksOn;
      InstancePath: STRING := "*";
      Xon: Boolean := DefaultXon;
      MsgOn: Boolean := DefaultMsgOn;
      tpd_A_PAD                      :	VitalDelayType01 := (1 ps, 1 ps);
      tpd_EN_PAD                     :	VitalDelayType01z := 
               (1 ps, 1 ps, 1 ps, 1 ps, 1 ps, 1 ps);
      tpd_PAD_Y                      :	VitalDelayType01 := (1 ps, 1 ps);
      tipd_A                         :	VitalDelayType01 := (0 ps, 0 ps);
      tipd_EN                        :	VitalDelayType01 := (0 ps, 0 ps);
      tipd_PAD                       :	VitalDelayType01 := (0 ps, 0 ps));

-- synopsys translate_on
   port(
      A                              :	in    STD_ULOGIC;
      EN                             :	in    STD_ULOGIC;
      PAD                            :	inout STD_ULOGIC;
      Y                              :	out   STD_ULOGIC);
end component;


----- Component BBCU16SMP_V5 -----
component BBCU16SMP_V5
-- synopsys translate_off
   generic(
      TimingChecksOn: Boolean := DefaultTimingChecksOn;
      InstancePath: STRING := "*";
      Xon: Boolean := DefaultXon;
      MsgOn: Boolean := DefaultMsgOn;
      tpd_A_PAD                      :	VitalDelayType01 := (1 ps, 1 ps);
      tpd_EN_PAD                     :	VitalDelayType01z := 
               (1 ps, 1 ps, 1 ps, 1 ps, 1 ps, 1 ps);
      tpd_PAD_Y                      :	VitalDelayType01 := (1 ps, 1 ps);
      tipd_A                         :	VitalDelayType01 := (0 ps, 0 ps);
      tipd_EN                        :	VitalDelayType01 := (0 ps, 0 ps);
      tipd_PAD                       :	VitalDelayType01 := (0 ps, 0 ps));

-- synopsys translate_on
   port(
      A                              :	in    STD_ULOGIC;
      EN                             :	in    STD_ULOGIC;
      PAD                            :	inout STD_ULOGIC;
      Y                              :	out   STD_ULOGIC);
end component;


----- Component BBCU16SP_V5 -----
component BBCU16SP_V5
-- synopsys translate_off
   generic(
      TimingChecksOn: Boolean := DefaultTimingChecksOn;
      InstancePath: STRING := "*";
      Xon: Boolean := DefaultXon;
      MsgOn: Boolean := DefaultMsgOn;
      tpd_A_PAD                      :	VitalDelayType01 := (1 ps, 1 ps);
      tpd_EN_PAD                     :	VitalDelayType01z := 
               (1 ps, 1 ps, 1 ps, 1 ps, 1 ps, 1 ps);
      tpd_PAD_Y                      :	VitalDelayType01 := (1 ps, 1 ps);
      tipd_A                         :	VitalDelayType01 := (0 ps, 0 ps);
      tipd_EN                        :	VitalDelayType01 := (0 ps, 0 ps);
      tipd_PAD                       :	VitalDelayType01 := (0 ps, 0 ps));

-- synopsys translate_on
   port(
      A                              :	in    STD_ULOGIC;
      EN                             :	in    STD_ULOGIC;
      PAD                            :	inout STD_ULOGIC;
      Y                              :	out   STD_ULOGIC);
end component;


----- Component BBCU24P_V5 -----
component BBCU24P_V5
-- synopsys translate_off
   generic(
      TimingChecksOn: Boolean := DefaultTimingChecksOn;
      InstancePath: STRING := "*";
      Xon: Boolean := DefaultXon;
      MsgOn: Boolean := DefaultMsgOn;
      tpd_A_PAD                      :	VitalDelayType01 := (1 ps, 1 ps);
      tpd_EN_PAD                     :	VitalDelayType01z := 
               (1 ps, 1 ps, 1 ps, 1 ps, 1 ps, 1 ps);
      tpd_PAD_Y                      :	VitalDelayType01 := (1 ps, 1 ps);
      tipd_A                         :	VitalDelayType01 := (0 ps, 0 ps);
      tipd_EN                        :	VitalDelayType01 := (0 ps, 0 ps);
      tipd_PAD                       :	VitalDelayType01 := (0 ps, 0 ps));

-- synopsys translate_on
   port(
      A                              :	in    STD_ULOGIC;
      EN                             :	in    STD_ULOGIC;
      PAD                            :	inout STD_ULOGIC;
      Y                              :	out   STD_ULOGIC);
end component;


----- Component BBCU24SMP_V5 -----
component BBCU24SMP_V5
-- synopsys translate_off
   generic(
      TimingChecksOn: Boolean := DefaultTimingChecksOn;
      InstancePath: STRING := "*";
      Xon: Boolean := DefaultXon;
      MsgOn: Boolean := DefaultMsgOn;
      tpd_A_PAD                      :	VitalDelayType01 := (1 ps, 1 ps);
      tpd_EN_PAD                     :	VitalDelayType01z := 
               (1 ps, 1 ps, 1 ps, 1 ps, 1 ps, 1 ps);
      tpd_PAD_Y                      :	VitalDelayType01 := (1 ps, 1 ps);
      tipd_A                         :	VitalDelayType01 := (0 ps, 0 ps);
      tipd_EN                        :	VitalDelayType01 := (0 ps, 0 ps);
      tipd_PAD                       :	VitalDelayType01 := (0 ps, 0 ps));

-- synopsys translate_on
   port(
      A                              :	in    STD_ULOGIC;
      EN                             :	in    STD_ULOGIC;
      PAD                            :	inout STD_ULOGIC;
      Y                              :	out   STD_ULOGIC);
end component;


----- Component BBCU24SP_V5 -----
component BBCU24SP_V5
-- synopsys translate_off
   generic(
      TimingChecksOn: Boolean := DefaultTimingChecksOn;
      InstancePath: STRING := "*";
      Xon: Boolean := DefaultXon;
      MsgOn: Boolean := DefaultMsgOn;
      tpd_A_PAD                      :	VitalDelayType01 := (1 ps, 1 ps);
      tpd_EN_PAD                     :	VitalDelayType01z := 
               (1 ps, 1 ps, 1 ps, 1 ps, 1 ps, 1 ps);
      tpd_PAD_Y                      :	VitalDelayType01 := (1 ps, 1 ps);
      tipd_A                         :	VitalDelayType01 := (0 ps, 0 ps);
      tipd_EN                        :	VitalDelayType01 := (0 ps, 0 ps);
      tipd_PAD                       :	VitalDelayType01 := (0 ps, 0 ps));

-- synopsys translate_on
   port(
      A                              :	in    STD_ULOGIC;
      EN                             :	in    STD_ULOGIC;
      PAD                            :	inout STD_ULOGIC;
      Y                              :	out   STD_ULOGIC);
end component;


----- Component BBS1P_V5 -----
component BBS1P_V5
-- synopsys translate_off
   generic(
      TimingChecksOn: Boolean := DefaultTimingChecksOn;
      InstancePath: STRING := "*";
      Xon: Boolean := DefaultXon;
      MsgOn: Boolean := DefaultMsgOn;
      tpd_A_PAD                      :	VitalDelayType01 := (1 ps, 1 ps);
      tpd_EN_PAD                     :	VitalDelayType01z := 
               (1 ps, 1 ps, 1 ps, 1 ps, 1 ps, 1 ps);
      tpd_PAD_Y                      :	VitalDelayType01 := (1 ps, 1 ps);
      tipd_A                         :	VitalDelayType01 := (0 ps, 0 ps);
      tipd_EN                        :	VitalDelayType01 := (0 ps, 0 ps);
      tipd_PAD                       :	VitalDelayType01 := (0 ps, 0 ps));

-- synopsys translate_on
   port(
      A                              :	in    STD_ULOGIC;
      EN                             :	in    STD_ULOGIC;
      PAD                            :	inout STD_ULOGIC;
      Y                              :	out   STD_ULOGIC);
end component;
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
