Kevin-Pottier/SOCN/(commit log)

2024-12-04 Changed main.c and compiled to print sinus values
2024-12-04 Was not working because mov direct, direct was not implemented in hardware
    [DAX.vhdl]
2024-12-04 We want 10us for one sample but got 400ns so we added 191 nop (50ns for a nop) to get the 10us for a sample that we need. This will be cleaned up later with better solution like a timer
2025-01-04 Implemented state machine in timer
2025-01-04 Added timer, DAX & startup code + small test of this in test.c
2025-01-04 Added the timer state machine in TimerCore and programmed test code of the sin wave of 10kHz
2025-01-08 BOD (Brown Out Detector) VHDL-AMS done
    [Bod_vhdlams.vhdl]
